sheltonr2/drone-boat/docs/Launch_Point_Study.md

# Launch-point study: where on the US Atlantic coast to launch, and the best launch and destination pair

12 November 2026. Plan, research and reasoning. Results will be added as the runs finish. Companion to [Destination_Study.md](Destination_Study.md).

## The question

The launch has been fixed 10 km off Ocean City, Maryland. Randolph asked on 12 Nov to test launch points up and down the US Atlantic coast, then combinations of launch point and destination, to find the best pair.

## What the research says

**1. The record of small robot boats points at the first few hundred kilometres.** The [Microtransat history](https://www.microtransat.org/history.php) lists every attempt.

- Eight boats left **Cape Cod** between 2014 and 2020. None got further than about 2,100 km. Three were caught by fishing boats within three to six days, and a fourth ran aground and was picked up by one.
- Three left **Gloucester, Massachusetts**. They looped, ran aground on Nantucket, or were withdrawn.
- Four left **Newfoundland**, which is already beyond the New England shelf and its fisheries. One finished (SB Met, 2018, 79 days), one reached the Irish coast after 6,041 km, one covered 4,682 km, and one sailed south and was lost.
- Scout, a 4 m solar boat, left Rhode Island in 2013 and was [lost after more than 1,300 miles](https://makezine.com/article/maker-news/scout-transatlantic-when-is-a-failure-not-a-failure).

The lesson is that boats die on the continental shelf, among the fishing fleets, before they reach deep water. Newfoundland is not a US launch point, but it shows what skipping the shelf is worth.

**2. Unsteered miniboats are launched into the Gulf Stream, not from the beach.** [Educational Passages](https://educationalpassages.org) has ships drop its 1.5 m boats in the stream. One boat shows why: Gryphon Cruiser was [launched off South Carolina less than 50 nautical miles short of the stream, and three days later it was ashore at Daytona Beach](https://educationalpassages.org/?p=15604). Relaunched from a ship, it strayed out of the stream and landed on Nantucket within six weeks. So a launch that stops short of the stream can end within days, and even the stream throws boats back at New England. Our boat steers, which should help with both.

**3. How far the Gulf Stream is from the beach varies enormously.**

- Off Jupiter and Palm Beach, Florida, it runs [1 to 3 miles from the inlet on many days](https://rigline-web-azure-mu.vercel.app/blog/best-offshore-fishing-spots-in-florida-data-driven-breakdown).
- Off Cape Hatteras it is [15 to 25 miles out](https://islandfreepress.org/?p=7099), the closest anywhere north of Florida, and charter boats fish it routinely.
- At Hatteras the stream leaves the coast. South of New England its north wall averages [240 km beyond the shelf break](https://scienceweb.whoi.edu/PO/linew/stream_coordinate_sections.php), which itself is 100 to 200 km offshore.

**4. On the Mid-Atlantic shelf the water moves slowly offshore and south-west.** Ten years of radar measurements ([Roarty et al. 2020](https://repository.library.noaa.gov/view/noaa/48639/noaa_48639_DS1.pdf)) give a mean surface flow of 2 to 12 cm/s, weakest in summer (3 to 6 cm/s). In the south of the region the flow turns offshore and joins the Gulf Stream near Hatteras. The day-to-day swings (10 to 20 cm/s) are much larger than the mean. So off Ocean City the shelf current neither helps nor hurts much: the boat has to sail about 250 km to reach the stream, in whatever the wind is doing.

**5. Early-season tropical storms form close to the southern launch points.** In June, storms tend to form in the Gulf of Mexico, the Caribbean or [off the south-east coast](https://michaelrlowry.substack.com/p/from-late-june-to-early-july-where), sometimes from [fronts stalled over the Gulf Stream](https://products.climate.ncsu.edu/weather/hurricanes/science). A boat launched from Florida or the Carolinas spends its first weeks there. Our weather data understates the winds in tropical storms, so the runs will flatter the southern launches on this point.

## What the destination runs already show about the launch

In the batch-1 Ireland run from Ocean City, 9% of boats were lost or aground within three weeks, 11% ended aground on the American side, and the median boat took 6.8 days to get 200 km from the launch point. So the near-coast phase costs roughly 10 points of success. That is the most a better launch point could win back from that phase alone; a faster crossing could add more.

## Launch points to test

All are about 10 km off the beach (what a small boat can reach in an hour) unless stated. Two extra "offshore" points test paying a charter boat to carry the drone to the shelf edge or the Gulf Stream.

| Launch | Position | Route to SW Ireland | Gulf Stream from the launch (my estimate) | Why it is in |
|---|---|---|---|---|
| Maine, off Mount Desert | 44.05°N 68.17°W | 4,800 km | 700 km | Shortest route. Has to cross the Gulf of Maine and pass Georges Bank and Nova Scotia |
| Cape Cod, off Chatham | 41.70°N 69.80°W | 4,980 km | 450 km | Where eight Microtransat boats started. A check of the model against that record |
| Montauk / Block Island | 41.00°N 71.78°W | 5,090 km | 350 km | Southern New England, clear of Cape Cod and Nantucket Shoals to the south |
| New Jersey, off Barnegat | 39.76°N 73.98°W | 5,250 km | 300 km | Between New York's and Delaware Bay's shipping lanes |
| **Ocean City, MD (current plan)** | 38.32°N 74.97°W | 5,380 km | 250 km | Baseline |
| Ocean City, 100 km off | 38.10°N 73.85°W | 5,290 km | 150 km | Charter run to the canyons at the shelf edge. What is skipping the shelf worth? |
| Virginia Beach | 36.83°N 75.85°W | 5,510 km | 150 km | South of the Chesapeake Bay mouth, where the shelf flow starts to turn offshore |
| Hatteras Inlet, NC | 35.10°N 75.72°W | 5,590 km | 30–45 km | Closest the stream comes north of Florida |
| Hatteras, 45 km off | 34.95°N 75.35°W | 5,560 km | 0 | Charter run into the stream's inshore edge |
| Charleston, SC | 32.68°N 79.77°W | 6,120 km | 100 km | Widest shelf in the south. The Gryphon Cruiser case |
| Cape Canaveral, FL | 28.41°N 80.48°W | 6,430 km | 60 km | Mid-Florida |
| Palm Beach, FL | 26.77°N 79.93°W | 6,600 km | under 10 km | In the stream from the first hour, but 1,200 km further |

Routes: the southern launches follow the stream's axis past Hatteras (30°N 79.8°W, 32°N 78.6°W, 35°N 74.5°W), the Hatteras launches clear Diamond Shoals first (35°N 74.9°W), Cape Cod and Montauk pass south of Georges Bank (40°N 67.5°W), and Maine leaves by the Northeast Channel (42.3°N 66°W). All then use the same mid-ocean waypoint as before (42°N 48°W).

**Autopilot change for this study.** Until now a waypoint counted only when the boat came within 25 km of it. In a 2 m/s current a boat can be swept past, and the old rule would turn it back against the stream. The launch scenarios use a new option (`"waypoint_rule": "abeam"`): a waypoint also counts once the boat has passed it. The earlier destination runs keep the old rule, so Ocean City is run again with the new rule as this study's baseline. Comparing it with the batch-1 Ireland run shows what the rule itself changes.

## Stages

| Stage | What | Runs | Time on the PC |
|---|---|---|---|
| A | All 12 launch points aimed at SW Ireland. Rev C5, 150 voyages each, 2023 weather, same launch dates and seeds as the destination study | 12 | about 8 hours |
| B | The best three launch points × the best three destinations from the destination study (pairs not already run) | up to 8 | about 5.5 hours |
| C | Confirmation of the best two pairs and the current plan: **Rev D**, 500 voyages (250 in each of 2023 and 2024), on the faster simulator | 3 | about 1 h 36 min |

- Stage A uses Rev C5 so that its numbers line up with the 13 destination runs. The boat we will build is Rev D, so the final answer (stage C) is run on Rev D.
- Stage B is a 3 × 3 grid because launch and destination might interact: a southern launch arrives in mid-ocean further south and later in the season, which could favour a different aim point.
- `simulator/run_launch_points_2023.bat` runs stage A. Scenario files: `collab/launch_points/`. A run that has already finished is skipped, so the batch can be restarted after a reboot.
- Analysis: `docs/data/launch_analysis.py`.

## What the simulator can and cannot tell us

It models, for every launch point: the real 2023 wind, waves and currents (currents at 1/12°, so the Gulf Stream and the Florida Current are resolved); land; and risks that rise near any coast (pick-up within 160 km of land, collision ×8 and fouling ×3 within 100 km).

It does not model:

- **Regional differences in fishing and traffic.** The pick-up risk is the same off Maine as off Florida. The Microtransat record says the New England and Nova Scotia shelves are far worse. The analysis therefore adds a sensitivity: each successful voyage is marked down for the days it spent on those grounds (Gulf of Maine and Georges Bank, the Scotian Shelf, the Grand Banks) at an extra 2% and 5% a day. Both rates are guesses. The Cape Cod record implies something near the higher one (3 or 4 boats caught in roughly 70 boat-days), but that is thin data from smaller boats.
- **Shoals and tidal races:** Diamond Shoals, Nantucket Shoals, Georges Bank, the Bay of Fundy tides. The land map has no shallows.
- **Lobster gear** in the Gulf of Maine, beyond the general near-coast fouling risk.
- **Tropical storms at full strength** (research note 5), which matters most for the southern launches.
- **Launch date.** Every launch point uses 1 May to 15 June. A Florida launch could go in April, before the storm season; a Maine launch might be better in June. Stage C can test this for the winners.
- **Cold.** Sea temperature off Maine in May is about 8 °C against 25 °C off Florida. That affects fouling growth, which is modelled, and fog, which is not.

Outside the simulator altogether: how far the boat has to be trailered, whether a charter boat is available (routine at Hatteras and Ocean City), and where a boat that washes back ashore can be recovered.

## What I expect, before the runs

- **Hatteras should do best**, and the 45 km charter launch better than the 10 km one. It is the only place where the stream is close and the route is not much longer. The risk is Diamond Shoals and the capes if the boat is set back ashore.
- **The offshore Ocean City launch** should recover most of the 10 points the near-coast phase costs, at the price of a charter.
- **Florida** gets a fast start but a 1,200 km longer route along a busy coast, within pick-up range for a week. I expect it to be close to Ocean City, and worse once storms are counted properly.
- **Charleston and Canaveral** have a wide shelf to cross before the stream. I expect them to be worst in the south.
- **New England** has the shortest route, but the model will flatter it because it does not know about the fishing fleets. Its fishing-adjusted figure is the one to read.

These are expectations, not results.

## Results

**Destinations for stage B** (from the finished destination study, 12 Nov): **SW Ireland, Cornwall and Brittany.** SW Ireland and Cornwall tied at 44.7%; West of Ireland (42.0%) and Brittany (41.3%) are tied within noise. Brittany is taken over West of Ireland because it is the furthest-south target still in the leading group, which is the better test of whether a southern launch favours a southern aim. Details: [Destination_Study.md](Destination_Study.md#results-12-nov-2026-final-for-this-screen).

### Stage A: 12 launch points to south-west Ireland (finished 13 Nov, 4:04 am)

Rev C5, 150 voyages per launch point, 2023 weather, launches 1 May–15 June, the same launch dates and seeds everywhere, so the paired column is the fair comparison. A single share is good to about ±8 points; paired differences to about ±10 here.

| # | Launch | Success (95% range) | vs Ocean City, paired | Median days | Lost | Aground | At sea | Lost or aground in 3 weeks | Aground on the home side | Days to get 200 km out | Days on the northern fishing grounds | Success if those grounds add 2% / 5% a day |
|---|---|---|---|---|---|---|---|---|---|---|---|---|
| 1 | Hatteras, 45 km off (charter, in the stream) | 54.0% (46–62) | +7.3 (-3.3 to +17.3) | 110 | 9.3% | 6.7% | 21.3% | 0.7% | 6.0% | 2.1 | 5.6 | 53.5% / 52.8% |
| 2 | Ocean City, 100 km off (charter, shelf edge) | 50.0% (42–58) | +3.3 (-6.7 to +12.7) | 115 | 10.7% | 7.3% | 23.3% | 0.0% | 6.7% | 4.7 | 6.5 | 49.0% / 47.8% |
| 3 | Hatteras Inlet, 10 km | 49.3% (41–57) | +2.7 (-7.3 to +12.7) | 107 | 11.3% | 6.0% | 22.7% | 4.7% | 6.0% | 2.6 | 4.2 | 48.5% / 47.5% |
| 4 | Virginia Beach, 10 km | 48.7% (41–57) | +2.0 (-8.7 to +12.7) | 116 | 16.7% | 5.3% | 24.0% | 7.3% | 5.3% | 6.3 | 3.6 | 48.0% / 47.1% |
| 5 | **Ocean City, 10 km (current plan)** | 46.7% (39–55) | — | 121 | 14.0% | 12.0% | 21.3% | 8.7% | 11.3% | 6.8 | 7.3 | 45.5% / 44.0% |
| 6 | Cape Cod, 10 km | 46.6% (39–55) | +0.0 (-9.3 to +10.0) | 118 | 18.0% | 7.3% | 23.3% | 1.3% | 7.3% | 5.5 | 13.0 | 40.9% / 34.1% |
| 7 | Montauk / Block Island, 10 km | 46.0% (38–54) | -0.7 (-12.0 to +10.0) | 126 | 18.0% | 12.0% | 20.7% | 6.7% | 11.3% | 7.3 | 10.2 | 42.0% / 37.3% |
| 8 | Maine, 10 km | 44.0% (36–52) | -2.7 (-12.0 to +6.7) | 115 | 22.7% | 11.3% | 18.0% | 10.7% | 11.3% | 4.5 | 23.7 | 30.3% / 18.4% |
| 9 | Charleston, 10 km | 43.3% (36–51) | -3.3 (-14.0 to +7.3) | 120 | 22.7% | 4.0% | 22.7% | 11.3% | 4.0% | 6.2 | 5.9 | 42.4% / 41.1% |
| 10 | Palm Beach, 10 km | 42.7% (35–51) | -4.0 (-13.3 to +5.3) | 127 | 18.0% | 9.3% | 26.0% | 9.3% | 9.3% | 2.5 | 6.9 | 41.7% / 40.4% |
| 11 | New Jersey (Barnegat), 10 km | 34.7% (28–43) | -12.0 (-21.3 to -2.7) | 131 | 20.7% | 20.0% | 22.0% | 10.7% | 17.3% | 6.5 | 10.3 | 32.4% / 29.7% |
| 12 | Cape Canaveral, 10 km (route flaw, see below) | 31.3% (24–39) | -15.3 (-25.3 to -5.3) | 126 | 21.3% | 15.3% | 24.7% | 18.7% | 14.0% | 4.5 | 7.0 | 29.5% / 27.2% |

"Success" = arrived still reporting or tracked by the YB3. "Aground on the home side" counts groundings west of 50°W, which includes Nova Scotia and Newfoundland as well as the launch coast. "Days on the northern fishing grounds" is time spent over the Gulf of Maine, Georges Bank, the Scotian Shelf and the Grand Banks; the last column marks successes down for it at two guessed extra pick-up rates (see "What the simulator can and cannot tell us").

**Checks before trusting the table.** No errors; every launch point has arrivals. Day-0 groundings are 0–1 everywhere except Hatteras Inlet (3, two of them on the beach at Hatteras village) and **Cape Canaveral (8 aground on the cape itself within a day, nothing broken)**. That one is my mistake: the launch point is south of the cape and the first leg to the north-north-east crosses it. A real launch would head east first. Canaveral's 31% is therefore about 5 points too low; a rerun with a first waypoint due east is queued at the end of stage B. Even corrected it stays in the bottom group, so it does not affect the stage B choice.

**What the waypoint rule changed.** Ocean City with the new "abeam" rule scored 46.7% against 44.7% for the same 150 launches with the old rule (destination study). 137 voyages came out identical; 3 that failed under the old rule arrived under the new one, and none went the other way. Paired: +2.0 (−0.2 to +4.2). So the rule helps a little and changes nothing else; launch points can be compared with it.

### What stage A shows

- **Going offshore beats moving along the coast.** The two charter launches top the table: 45 km off Hatteras, into the stream's inshore edge, 54.0% (+7.3 over Ocean City, range −3 to +17), and 100 km off Ocean City at the shelf edge, 50.0% (+3.3). Both nearly eliminate the near-coast losses: lost or aground in the first three weeks falls from 8.7% at Ocean City to 0.7% and 0%. And they cut fishing pick-ups (from 15 boats to 7 and 9).
- **Hatteras is the best beach launch**, as the research suggested: 49.3% from 10 km off, the shortest median crossing of all (107 days, against 121 from Ocean City), because the boat is 200 km out in under three days. Virginia Beach is about as good (48.7%).
- **None of these gains is certain on 150 voyages.** Every paired range for the top five crosses zero. The pattern (the closer the launch is to the stream, the better) is consistent, and it is what the research predicted, but the size of the gain needs stage C's larger runs.
- **New England gains nothing, and the fishing grounds make it worse.** Cape Cod (46.6%) and Montauk (46.0%) tie Ocean City in the model, but their boats spend 10–13 days on the New England and Scotian fishing grounds, against 4–7 from further south. With the guessed fishing mark-down they fall to 34–42%. Maine is worst affected: 24 days on the grounds, 22 boats picked up, and 18–30% after the mark-down. The Microtransat record from Cape Cod points the same way.
- **Florida doesn't pay.** Palm Beach is in the Florida Current from the first hour, but the route is 1,200 km longer and the boats take longer (127 days median). 42.7%, about the same as Charleston (43.3%).
- **New Jersey is clearly worse** (34.7%, −12, range −21 to −3): boats are carried north-east onto southern New England, Nova Scotia and Newfoundland, and 20% end aground (17% on the home side).

### Stage B: launch and destination pairs (finished 13 Nov, 12:52 pm)

Ran on the PC as `simulator/run_launch_pairs_2023.bat` (request 010), 7:06 am to 12:52 pm, no errors. Rev C5, 150 voyages per pair, 2023 weather, the same launch dates and seeds as stage A, so every cell is paired with Ocean City 10 km → SW Ireland (46.7%).

**Success, and paired difference against Ocean City 10 km → SW Ireland (95% range)**

| Launch | → SW Ireland | → Cornwall | → Brittany | Mean of the three |
|---|---|---|---|---|
| Hatteras 45 km (charter) | **54.0%** +7.3 (−3.3 to +17.3) | 46.7% +0.0 (−10.0 to +9.3) | 50.7% +4.0 (−6.0 to +13.3) | 50.4% |
| Ocean City 100 km (charter) | 50.0% +3.3 (−6.7 to +12.7) | **53.3%** +6.7 (−2.7 to +16.7) | 45.3% −1.3 (−11.3 to +8.7) | 49.6% |
| Hatteras Inlet 10 km | 49.3% +2.7 (−7.3 to +12.7) | 51.3% +4.7 (−6.0 to +15.3) | 50.7% +4.0 (−6.7 to +14.7) | 50.4% |
| Ocean City 10 km (current plan) | 46.7% (baseline) | 46.7% +0.0 (−7.3 to +7.3) | 44.7% −2.0 (−9.3 to +5.3) | 46.0% |

**Pooled** (`docs/data/launch_pairs_analysis.py`; each launch compared with Ocean City 10 km to the same destination, and each destination with SW Ireland from the same launch, resampling seeds):

| | Paired difference (95% range) |
|---|---|
| Hatteras 45 km vs Ocean City 10 km | +4.4 (−4.0 to +12.2) |
| Ocean City 100 km vs Ocean City 10 km | +3.6 (−3.8 to +11.3) |
| Hatteras Inlet 10 km vs Ocean City 10 km | +4.4 (−3.8 to +12.9) |
| Hatteras Inlet 10 km vs Hatteras 45 km | +0.0 (−7.8 to +8.0) |
| Cornwall vs SW Ireland | −0.5 (−4.2 to +3.7) |
| Brittany vs SW Ireland | −2.2 (−6.3 to +2.2) |

With the guessed fishing-ground mark-down (2% / 5% a day) every cell drops by 0.3 to 3 points and the order does not change. Storm encounters (`docs/data/launch_pairs_storms.json`, grade-D loss model) are 16.5–18.2% of voyages within 200 km of a tropical storm for every pair, costing 0.7–1.1 points: they do not separate the pairs.

**Canaveral rerun.** With the waypoint moved east of the cape, Canaveral → SW Ireland is 34.0% (−12.7 against Ocean City, range −22.0 to −2.7), against 31.3% for the flawed run. Grounding in the first three weeks fell from 18.7% to 14.0%, but it is still the worst launch tested, so the stage A conclusion stands: Florida doesn't pay.

### What stage B shows

- **The single cells are noise.** The best cell, Hatteras 45 km → SW Ireland (54.0%), and the next, Ocean City 100 km → Cornwall (53.3%), each come with a poor cell from the same launch (46.7%, 45.3%). The same launch dates and nearly the same first 3,000 km can't plausibly differ by 7 points on the aim point alone; that spread is what 150 voyages give.
- **Pooled, the three alternative launches are all about 4 points better than Ocean City 10 km, and tied with each other.** None of the ranges excludes zero, but all three point the same way, and they share the reason stage A found: they get the boat off the shelf and away from the coast faster (lost or aground in three weeks: 0–5% against 8.7%).
- **A beach launch at Hatteras Inlet is as good as the charter 45 km out** (+0.0, −7.8 to +8.0). Following the rule we set (prefer a beach launch over a charter launch when they're within noise), Hatteras Inlet is the launch to carry forward, though its early-grounding rate (4.7%) is higher than the charter's (0.7%).
- **SW Ireland and Cornwall are tied; Brittany is about 2 points worse.** Same as the destination study.

### Stage C: final check (13 Nov, 1:56–3:30 pm)

The best two pairs, both from Hatteras Inlet so that one comparison isolates the destination and the other the launch, and the current plan:

1. Hatteras Inlet 10 km → SW Ireland
2. Hatteras Inlet 10 km → Cornwall
3. Ocean City 10 km → SW Ireland (current plan)

On **Rev D as drawn**, **500 voyages each** (alternating 2023 and 2024 weather, so 250 in each year), the same seeds in all three runs. That is twice the 250 first planned: the faster simulator (installed 13 Nov after the bit-for-bit check) makes it cost about 1 h 36 min instead of 8 hours, and it narrows the paired ranges by about a third. `simulator/run_launch_final.bat` (request 011). Results: `results/2026-11-13_launch_2023+2024_<pair>.json`; log `collab/run_log_launch_final_2026-11-13.txt`; analysis `docs/data/launch_final_analysis.py` (output beside it).

Results: `results/2026-11-13_launch_2023_<launch>__<destination>.json`. Logs: `collab/run_log_launch_points_2023_2026-11-13.txt` (stage A), `collab/run_log_launch_pairs_2023_2026-11-13.txt` (stage B). Note: the first attempt at stage A, started at 6:02 pm on 12 Nov, was killed when the laptop was unplugged; the batch was restarted at 8:49 pm and ran cleanly.

**Results.** 500 voyages per pair, 250 in each weather year, the same seeds in all three. Ran in 1 h 34 min, no errors.

| Pair | Success (95% range) | 2023 | 2024 | Lost | Aground | Lost or aground in 3 weeks | Storm: TS within 200 km | After the storm-loss model | Fishing mark-down 2% / 5% |
|---|---|---|---|---|---|---|---|---|---|
| **Hatteras Inlet → Cornwall** | **68.4% (64–72)** | 72.0% | 64.8% | 6.8% | 3.4% | 2.8% | 13.2% | 67.2% | 67.9 / 67.2% |
| Hatteras Inlet → SW Ireland | 64.6% (60–69) | 65.6% | 63.6% | 8.2% | 2.4% | 2.8% | 13.8% | 63.5% | 64.0 / 63.3% |
| Ocean City 10 km → SW Ireland (current plan) | 59.2% (55–63) | 62.8% | 55.6% | 15.2% | 3.0% | 7.4% | 16.3% | 57.8% | 58.3 / 57.4% |

**Paired differences (95% range):**

| Comparison | Both years | 2023 | 2024 |
|---|---|---|---|
| **Hatteras Inlet → Cornwall vs current plan** | **+9.2 (+3.8 to +14.8)** | +9.2 (+1.2 to +17.2) | +9.2 (+1.6 to +16.8) |
| Launch only: Hatteras Inlet vs Ocean City, both to SW Ireland | +5.4 (−0.2 to +10.8) | +2.8 (−4.8 to +10.0) | +8.0 (+0.4 to +15.6) |
| Destination only: Cornwall vs SW Ireland, both from Hatteras Inlet | +3.8 (−0.2 to +7.8) | +6.4 (+0.4 to +12.4) | +1.2 (−4.4 to +7.2) |

## Recommendation (13 Nov 2026; adopted by Randolph the same day, with one correction)

**Update, 13 Nov evening:** Rev E from the 45 km point to Cornwall: **87.6%** (500 voyages, 2023 and 2024), +4.2 (+0.0 to +8.4) over the inlet, clear of the shoals; the 45 km point is the recommended drop ([Launch_Plan.md](Launch_Plan.md), [Naval_Review.md](Naval_Review.md)).

**Correction, 13 Nov, after adoption:** the 10 km drop off Hatteras Inlet sends about half the simulated tracks across Diamond Shoals, which the simulator's coastline doesn't hold ([Naval_Review.md](Naval_Review.md)). The provisional drop point is the 45 km charter point ("Hatteras 45 km" in stages A and B), which tied with the inlet on success and stays clear of the shoals. Runs to confirm it on Rev E are queued. The destination half of the recommendation (Cornwall) is unaffected. The text below is as written before the correction.

**Launch 10 km off Hatteras Inlet and aim for Cornwall** (Isles of Scilly / Land's End), instead of 10 km off Ocean City to SW Ireland.

- **How sure:** +9.2 points (+3.8 to +14.8) over the current plan on Rev D, the same in both weather years. That is the first launch result in this study whose range clears zero by a clear margin. Each half of it alone is borderline: the launch is worth about 5 points and the destination about 4.
- **Why it works:**
  - Off Hatteras the Gulf Stream is close. The boat is 200 km out in under 3 days (Ocean City: 7), so it spends less time near the coast, the fishing grounds and the shipping lanes. Losses fall from 15.2% to 6.8%, and the first-three-weeks losses from 7.4% to 2.8%.
  - It also sees slightly fewer tropical storms: within 200 km on 13% of voyages against 16%.
  - Cornwall is a slightly easier target than SW Ireland on the same tracks.
- **What it costs in practice:**
  - **Distance:** Hatteras is about 5 hours' drive south of Ocean City, plus a boat out of Hatteras Inlet. The inlet shoals and breaks in any swell, so go out on a calm morning with a local skipper, not a borrowed skiff.
  - **The charter alternative:** the 45 km charter from Hatteras did as well as the Inlet in stage B (tied), so if the Inlet is unworkable on the day, go with the Hatteras charter.
  - **Recovery:** Cornwall and the Scillies have good harbours and an active sea-rescue and fishing community for recovery. Recovery planning and contacts move from Ireland to south-west England.
- **What would change it:**
  - A test-season result from the real boat showing it can't hold its course in the Stream's eddies.
  - Real data on fishing-boat pick-ups, which the model only guesses. The Hatteras route crosses fewer grounds, so better data is more likely to strengthen this than reverse it.
  - Cornwall's approaches have heavy shipping; if a ship-strike model is added, rerun the destination half.
- **Changed 13 Nov:** [Launch_Plan.md](Launch_Plan.md) rewritten for Hatteras → Cornwall; Executive Summary, Build Plan and README updated. The boat-sim files for John's team (`designs/boat-sim/`) still carry the Ocean City drop so the boats there are compared alike.

## Sources

- [Microtransat Challenge history](https://www.microtransat.org/history.php)
- [Educational Passages: Gryphon Cruiser](https://educationalpassages.org/?p=15604)
- [Roarty et al. 2020, surface circulation over the Mid-Atlantic Bight shelf from HF radar](https://repository.library.noaa.gov/view/noaa/48639/noaa_48639_DS1.pdf)
- [WHOI Line W: mean position of the Gulf Stream north wall](https://scienceweb.whoi.edu/PO/linew/stream_coordinate_sections.php)
- [Island Free Press: charter fishing off Hatteras](https://islandfreepress.org/?p=7099)
- [Rigline: Gulf Stream off Jupiter and Palm Beach](https://rigline-web-azure-mu.vercel.app/blog/best-offshore-fishing-spots-in-florida-data-driven-breakdown)
- [Michael Lowry: where early-season tropical storms form](https://michaelrlowry.substack.com/p/from-late-june-to-early-july-where)
- [NC State Climate Office: tropical storm science](https://products.climate.ncsu.edu/weather/hurricanes/science)
- [Make: Scout transatlantic](https://makezine.com/article/maker-news/scout-transatlantic-when-is-a-failure-not-a-failure)
