sheltonr2/drone-boat/docs/Destination_Study.md

# Destination study: is there a better target than Ireland?

12 November 2026. Plan and reasoning; results to follow when the runs finish. Run files `simulator/run_destinations_2023.bat` and `run_destinations2_2023.bat`, scenarios in `collab/destinations/`.

## How the question is set up

- **The simulator already counts any landfall in Europe as a crossing.** Ireland is where the autopilot aims, not the only place that counts. So the question is which aim point gets the most boats across.
- **What counts as "across" in this study:** mainland Europe and the British Isles, Madeira, the Canary Islands, and north-west Africa's Atlantic coast (Morocco, Western Sahara). **The Azores do not count:** they sit about two-thirds of the way across, roughly 4,000 km from the launch point against 5,200–5,700 km for the others.
- **Same everything else:** Rev C5, corrected simulator, 10 km launch off Ocean City, launches 1 May–15 June 2023, real 2023 weather, 150 voyages per destination. A 150-voyage result is good to about ±8 points, so this is a first screen; the best two or three get a 2023 + 2024 confirmation run.
- **An artefact to keep in mind:** a boat that leaves the weather data's area (north of 60°N or east of 0°) gets no wind there. That penalises boats that overshoot the Hebrides to the north.
- **Weather data limits:** the downloaded weather covers 26–60°N and 82°W–0°. That rules out Norway, Iceland and West Africa south of the Canaries without new downloads. A boat pushed south of 26°N near the Canaries sails on neutral weather there.

## Candidates

### How they were chosen

The first six were a quick north-to-south sweep of well-known headlands on the European side that fit inside the weather data, each with an obvious route. They were a sensible first screen but not an optimised list, and they left three gaps: nothing north of Mizen Head, nothing between Brittany and Galicia, and nothing between Lisbon and the Canaries. They also tested only one route to each place. A second batch of seven fills those gaps.

The choice is driven by two things more than by the name on the map:
- **The latitude at which the boat approaches the far side.** That sets how much it uses the westerlies and the North Atlantic Current, how rough the seas are, and how long it takes.
- **How good a net the coast behind the aim point is.** Any far-side landfall counts, and many boats arrive damaged. A coast that wraps round the aim point, with the wind blowing onto it, catches boats that can no longer steer well. An isolated island or a coast the current runs along, not onto, does not.

### Batch 1 (`run_destinations_2023.bat`)

| Destination | Aim point | Route distance | Route |
|---|---|---|---|
| South-west Ireland (current plan) | Mizen Head, 51.35°N 9.7°W | 5,380 km | via 42°N 48°W, south of the Grand Banks |
| Cornwall and the Isles of Scilly | 49.95°N 6.3°W | 5,610 km | same waypoint |
| Brittany | Pointe du Raz, 48.04°N 4.85°W | 5,730 km | same waypoint |
| Galicia, Spain | Cape Finisterre, 42.9°N 9.35°W | 5,530 km | via 40°N 48°W |
| Portugal | Cabo da Roca, 38.75°N 9.6°W | 5,560 km | direct (the direct course arcs north to about 43°N in mid-ocean) |
| Canary Islands | Lanzarote, 29.0°N 13.4°W | 5,690 km | direct |

### Batch 2 (`run_destinations2_2023.bat`)

| Destination | Aim point | Why it was added |
|---|---|---|
| Bay of Biscay | Vendée coast, 46.45°N 1.85°W | The middle of the widest net: Brittany to the north, Spain to the south, wind onshore. The best test of the "net" idea |
| West of Ireland | Connemara, 53.4°N 10.25°W | Further into the current's path; a boat that drifts north still has Donegal and Scotland beyond it |
| Outer Hebrides, Scotland | South Uist, 57.2°N 7.5°W | The northern end of what the weather data allows; most current, roughest seas |
| Gulf of Cádiz | 36.55°N 6.4°W | A funnel between the Algarve and Morocco, both of which count |
| Morocco | Casablanca, 33.6°N 7.7°W | A long, straight coast to aim at south of the stormy latitudes |
| Canary Islands by the northern arc | via 42°N 48°W and 40°N 20°W | The traditional sailing route: stay in the westerlies, then turn south with the northerly winds off Portugal. Tests route against destination |
| Azores | Faial, 38.55°N 28.75°W | Only about 4,000 km, but two-thirds of the way across. Reported separately: it counts only if the Azores are accepted as "across" |

### Not tested, and why

- **Iceland, the Faroes and Norway:** outside the downloaded weather (which stops at 60°N and at 0° longitude). Iceland's south coast is about 4,600 km from the launch point, shorter than Ireland, but colder and rougher, with ice near the route. Worth a weather download only if the northern targets do well here.
- **West Africa south of the Canaries, Cape Verde:** outside the weather data (south of 26°N), and reaching them means crossing the light-wind belt.
- **The Caribbean and South America:** not across from North America in the sense asked. (The trade-wind route runs the other way, Europe to the Caribbean.)
- **Madeira:** a single small island, bracketed by the Portugal and Canaries runs.
- **Different routes to the northern targets:** the waypoint at 42°N 48°W is held fixed. Tuning it is the next step for whichever targets win.
- **A different launch point:** was out of scope here. Added on 12 Nov as its own study, which also tests launch and destination pairs: [Launch_Point_Study.md](Launch_Point_Study.md).

## What the physics suggests before the runs

These are expectations from general North Atlantic oceanography, not results. The runs will confirm or overturn them.

- **The ocean's conveyor favours the north.** The Gulf Stream feeds the North Atlantic Current, which runs north-east toward Ireland and Britain. A boat sailing for the British Isles has current and the prevailing westerlies behind it for most of the way, and a dead boat drifts the same way. That is why drift bottles and small unpowered boats from North America so often land in Ireland, Britain and France.
- **The southern routes cross the Azores High.** In summer a large area of high pressure sits around 30–40°N in the mid-Atlantic, with light, shifting winds. Routes to Portugal and the Canaries go through or around it, so they are likely to be slower, and time at sea is what drives failures.
- **The north is rougher.** Gales and breaking seas are more frequent the further north and the later in the season. That costs knockdowns, wing and keel damage. It is the main argument for a more southerly target.
- **Coast width matters.** Aiming at Cornwall or Brittany puts the boat in the mouth of a funnel: if it drifts north it hits Ireland or Wales, if south it hits France or Spain. Aiming at south-west Ireland, a boat that overshoots north passes Ireland and continues into the open sea towards Scotland and Norway.
- **Traffic and fishing near the coast.** The approaches to the English Channel (off Ushant) and Cape Finisterre are among the busiest shipping lanes in the world, and the Iberian and Moroccan coasts are heavily fished. The simulator's collision and pick-up risks do not vary by region, so it will understate this for Brittany, Galicia and Portugal.
- **Hurricanes.** The Canaries route stays in the subtropics into August to October. The simulator's weather resolves hurricanes poorly, so it will understate that risk.
- **The Azores** would be the easiest target by distance alone, but they are not across the Atlantic and are excluded.

## When results are in

For each destination: share of voyages reaching any far-side coast with a verified position, where they landed, median crossing time, and the main causes of loss. Then a recommendation, with the confirmation run for the best candidates.

## Results (12 Nov 2026, final for this screen)

Rev C5 on the corrected simulator, 150 voyages per aim point, 2023 weather, launched 10 km off Ocean City, 1 May–15 June. Every aim point used the same launch dates and seeds, so the paired column is the fairer comparison. A single share is good to about ±8 points; paired differences are tighter.

| Rank | Aim point | Success (95% range) | vs SW Ireland, paired | Any landfall | Median days | Lost | Aground | At sea | Where successes landed |
|---|---|---|---|---|---|---|---|---|---|
| 1 | SW Ireland (Mizen Head) | 44.7% (37–53) | — | 51.3% | 121 | 14.7% | 12.0% | 22.0% | Ireland 58, France 4, Great Britain 4, Portugal 1 |
| 2 | Cornwall | 44.7% (37–53) | +0.0 (-7.3 to +8.0) | 50.7% | 127 | 16.0% | 12.7% | 20.7% | Great Britain 57, France 9, Portugal 1 |
| 3 | West of Ireland | 42.0% (34–50) | -2.7 (-10.0 to +4.7) | 48.0% | 118 | 15.3% | 12.0% | 24.7% | Ireland 60, Great Britain 3 |
| 4 | Brittany | 41.3% (34–49) | -3.3 (-10.7 to +4.0) | 48.6% | 132 | 13.3% | 12.7% | 25.3% | France 58, Ireland 3, Great Britain 1 |
| 5 | Bay of Biscay | 38.7% (31–47) | -6.0 (-14.0 to +1.3) | 46.1% | 143 | 14.0% | 11.3% | 28.7% | France 52, Spain 2, Portugal 2, Ireland 1, Great Britain 1 |
| 6 | Galicia | 38.0% (31–46) | -6.7 (-15.3 to +2.0) | 43.4% | 140 | 20.7% | 5.3% | 30.7% | Spain 51, Portugal 5, France 1 |
| 7 | Outer Hebrides | 38.0% (31–46) | -6.7 (-15.3 to +1.3) | 46.0% | 124 | 15.3% | 12.0% | 26.7% | Great Britain 53, Ireland 3, France 1 |
| 8 | Gulf of Cádiz | 36.7% (29–45) | -8.0 (-18.0 to +2.7) | 40.7% | 150 | 18.0% | 12.0% | 29.3% | Spain 27, Portugal 26, Africa 2 |
| 9 | Portugal (Lisbon) | 33.4% (26–41) | -11.3 (-21.3 to -1.3) | 36.1% | 148 | 16.7% | 12.7% | 34.7% | Portugal 50 |
| 10 | Canaries, northern arc | 22.0% (16–29) | -22.7 (-31.3 to -14.7) | 27.3% | 158 | 19.3% | 14.7% | 38.7% | Canaries 31, Madeira 1, Portugal 1 |
| 11 | Morocco | 18.0% (13–25) | -26.7 (-36.0 to -17.3) | 19.3% | 163 | 24.7% | 11.3% | 44.7% | Africa 25, Spain 1, Madeira 1 |
| 12 | Canaries | 10.7% (7–17) | -34.0 (-42.7 to -25.3) | 13.4% | 170 | 19.3% | 6.0% | 61.3% | Canaries 15, Madeira 1 |

Success = arrived still reporting or tracked by the YB3. "Any landfall" also counts silent and adrift arrivals. Boats that reach the 40 km arrival circle but are still offshore count for the aim point's country. Lost, aground and at sea are shares of all 150.

**The Azores, reported separately** (they count only if Randolph accepts them as "across"):

| Rank | Aim point | Success (95% range) | vs SW Ireland, paired | Any landfall | Median days | Lost | Aground | At sea | Where successes landed |
|---|---|---|---|---|---|---|---|---|---|
| — | Azores (not "across") | 52.7% (45–60) | +8.0 (-1.3 to +17.3) | 54.7% | 90 | 16.0% | 2.0% | 27.3% | Azores 79 |

### What it shows

- **No target beats south-west Ireland.** Cornwall ties it exactly (44.7% each). West of Ireland (−2.7) and Brittany (−3.3) are within noise. Ireland stays the target; Cornwall is an equal alternative.
- **Further north does not help.** The Outer Hebrides are about as far as SW Ireland but score −6.7. This run doesn't show why.
- **Further south is clearly worse.** Biscay −6, Galicia −7, Cádiz −8, Portugal −11 (range −21 to −1), the Canaries by either route −23 to −34, Morocco −27. Every southern route crosses the light winds of the Azores High: medians of 140–170 days against 121, and 29–61% still at sea at the season's end. The northern arc to the Canaries (22%) beats the direct route (11%), but only by avoiding the High for longer.
- **The Azores score best (52.7%, +8, range −1 to +17) because they are close**: 90 days median. If they counted, they would be the easiest target, but they are about two-thirds of the way across.
- **The causes of loss are the same on every route** (rudder servos, fouling, electronics, leaks). The destination changes how long the boat is exposed to them, not what they are.
- Caveats as before: collision and pick-up risks don't vary by region, so busy approaches (the Channel, Ushant, Finisterre) are flattered; one weather year; Rev C5, not Rev D.

### Going forward

The launch-point study ([Launch_Point_Study.md](Launch_Point_Study.md)) carries three destinations into its stage B: **SW Ireland, Cornwall and Brittany**. West of Ireland scored a fraction higher than Brittany, but the two are tied within noise and the west-of-Ireland aim point is only 230 km from the SW Ireland one. Brittany is the furthest-south target still in the leading group, so it is the better test of whether a southern launch favours a southern aim. No separate destination confirmation run: the best pairs are confirmed on Rev D, on 2023 and 2024 weather, in stage C of the launch study.

Script: `docs/data/dest_analysis.py`. Results: `results/2026-11-12_dest_2023_<name>.json`. Logs: `collab/run_log_destinations_2023_2026-11-12.txt`, `collab/run_log_destinations2_2023_2026-11-12.txt`.
