sheltonr2/drone-boat/build-files/dxf/T21_weed_fairing.dxf

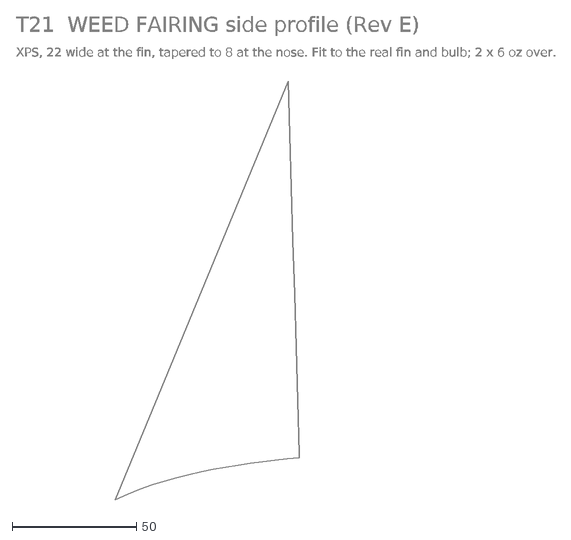
[picture p1: CAD file, 2026-11-13]
build-files/dxf/T21_weed_fairing.dxf
T21 WEED FAIRING side profile (Rev E)
XPS, 22 wide at the fin, tapered to 8 at the nose. Fit to the real fin and bulb; 2 x 6 oz over.
