sheltonr2/drone-boat/build-files/stl/P08_spar_clamp_two_sockets.stl

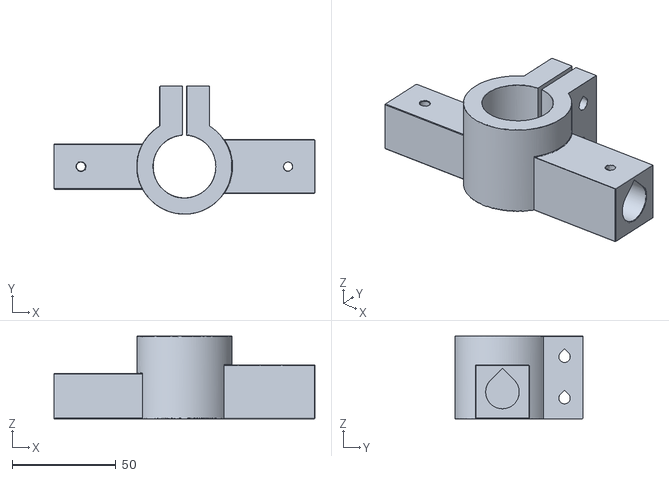
[picture p2: CAD file, 2026-11-14]
build-files/stl/P08_spar_clamp_two_sockets.stl
126.0 x 62.0 x 40.0
