sheltonr2/drone-boat/designs/revC_boat_wing_feathered.stl

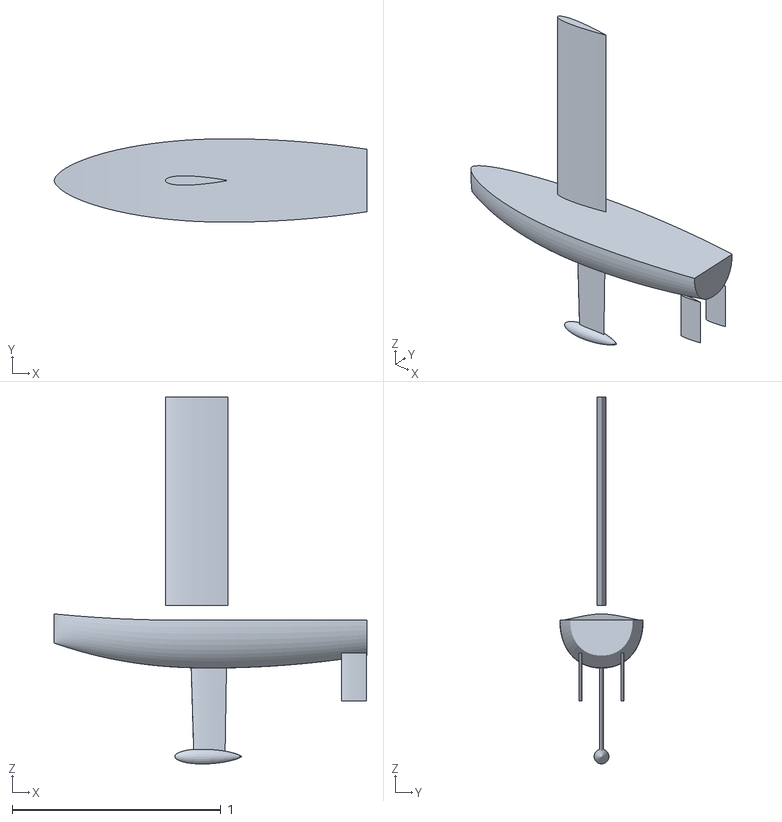
[picture p3: CAD file, 2026-11-10]
designs/revC_boat_wing_feathered.stl
1.50 x 0.4 x 1.76
