sheltonr2/drone-boat/build-files/dxf/T16_hatch.dxf

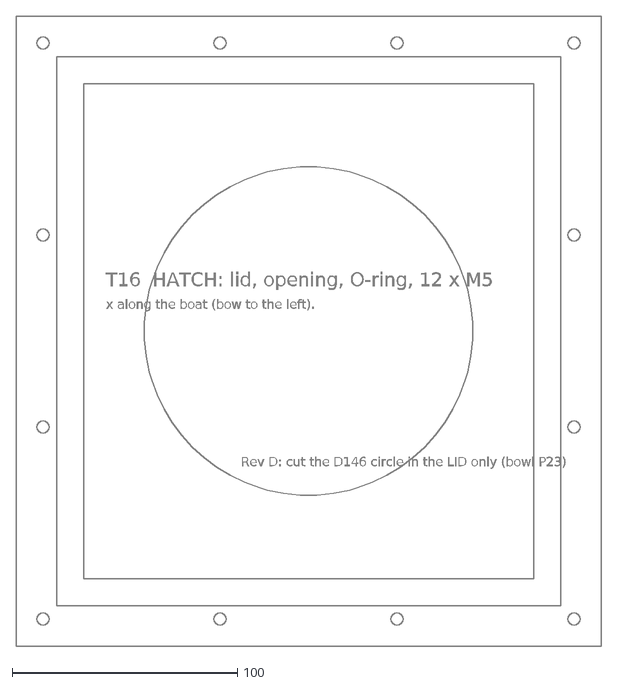
[picture p4: CAD file, 2026-11-12]
build-files/dxf/T16_hatch.dxf
T16 HATCH: lid, opening, O-ring, 12 x M5
Rev D: cut the D146 circle in the LID only (bowl P23)
x along the boat (bow to the left).
