sheltonr2/drone-boat/build-files/stl/P09_tail_servo_housing.stl

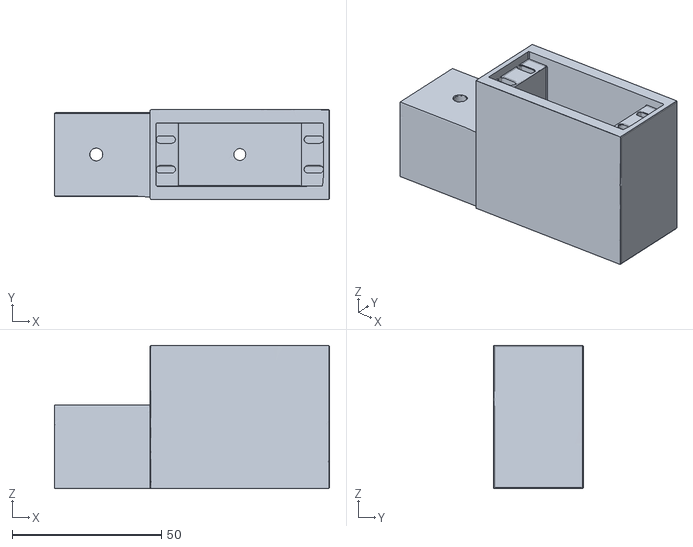
[picture p5: CAD file, 2026-11-14]
build-files/stl/P09_tail_servo_housing.stl
92.0 x 30.0 x 48.0
