sheltonr2/drone-boat/build-files/dxf/T15_wing.dxf

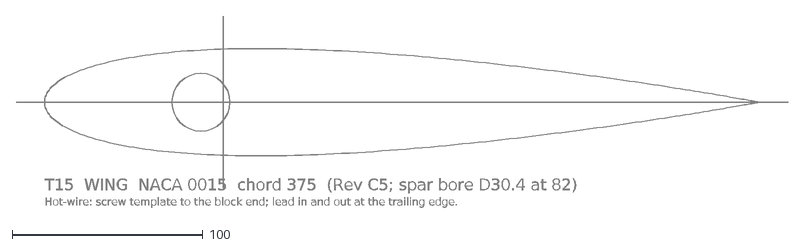
[picture p6: CAD file, 2026-11-11]
build-files/dxf/T15_wing.dxf
T15 WING NACA 0015 chord 375 (Rev C5; spar bore D30.4 at 82)
Hot-wire: screw template to the block end; lead in and out at the trailing edge.
