sheltonr2/drone-boat/build-files/stl/P26_rudder_servo_arm.stl

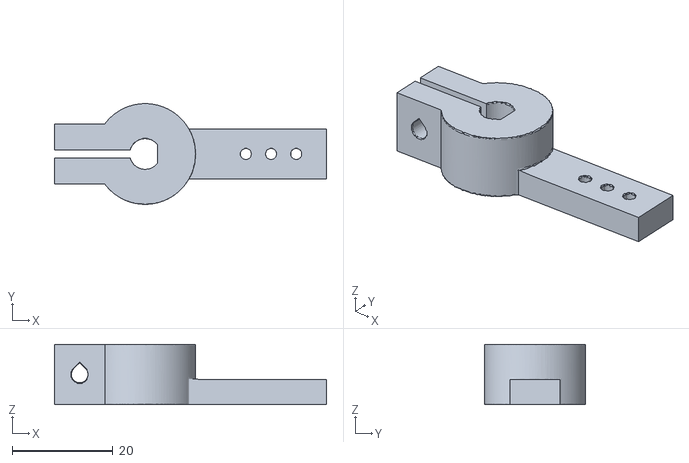
[picture p7: CAD file, 2026-11-13]
build-files/stl/P26_rudder_servo_arm.stl
54.0 x 20.0 x 12.0
