sheltonr2/drone-boat/build-files/dxf/T04_frame_station_4.dxf

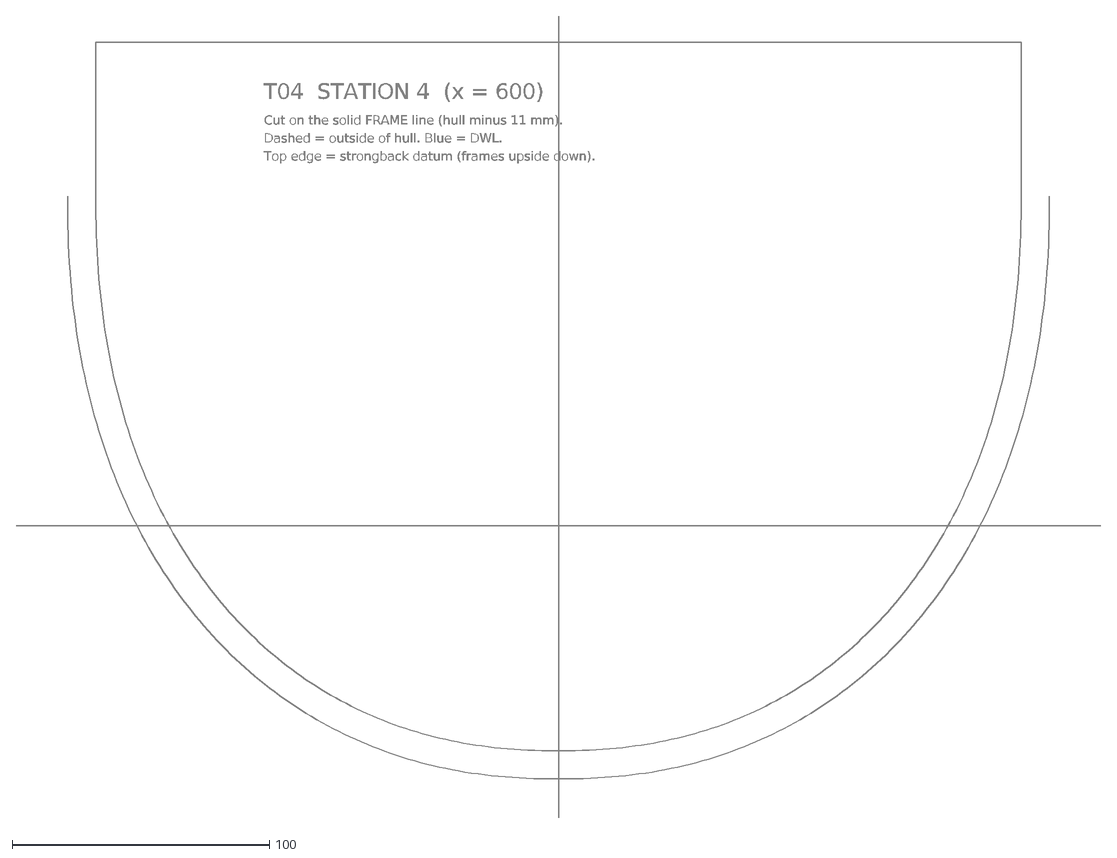
[picture p8: CAD file, 2026-11-11]
build-files/dxf/T04_frame_station_4.dxf
T04 STATION 4 (x = 600)
Cut on the solid FRAME line (hull minus 11 mm).
Dashed = outside of hull. Blue = DWL.
Top edge = strongback datum (frames upside down).
