sheltonr2/drone-boat/build-files/stl/P24_bilge_pump_spacer.stl

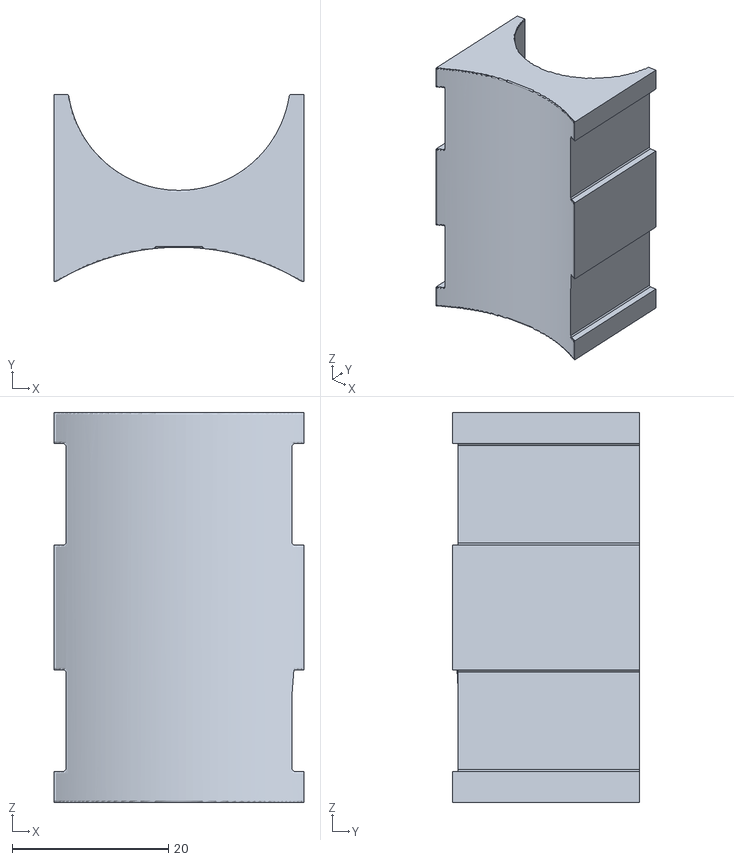
[picture p9: CAD file, 2026-11-13]
build-files/stl/P24_bilge_pump_spacer.stl
32.0 x 24.0 x 50.0
