sheltonr2/drone-boat/build-files/dxf/T09_frame_station_9.dxf

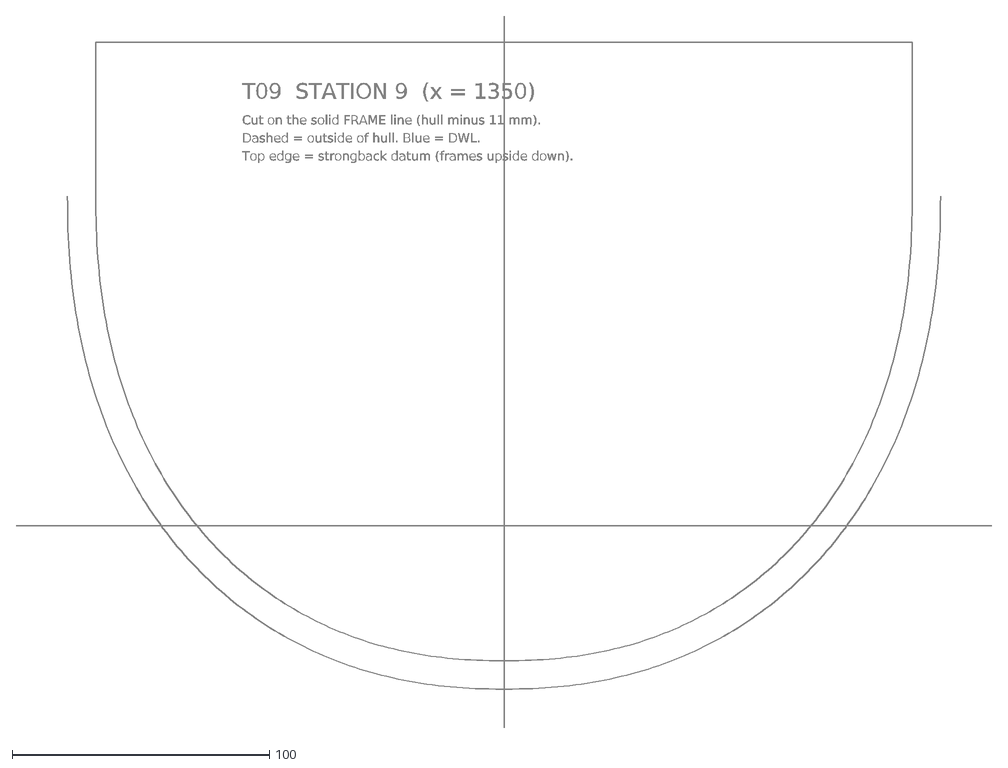
[picture p10: CAD file, 2026-11-11]
build-files/dxf/T09_frame_station_9.dxf
T09 STATION 9 (x = 1350)
Cut on the solid FRAME line (hull minus 11 mm).
Dashed = outside of hull. Blue = DWL.
Top edge = strongback datum (frames upside down).
