sheltonr2/drone-boat/build-files/stl/P12_rudder_servo_cradle.stl

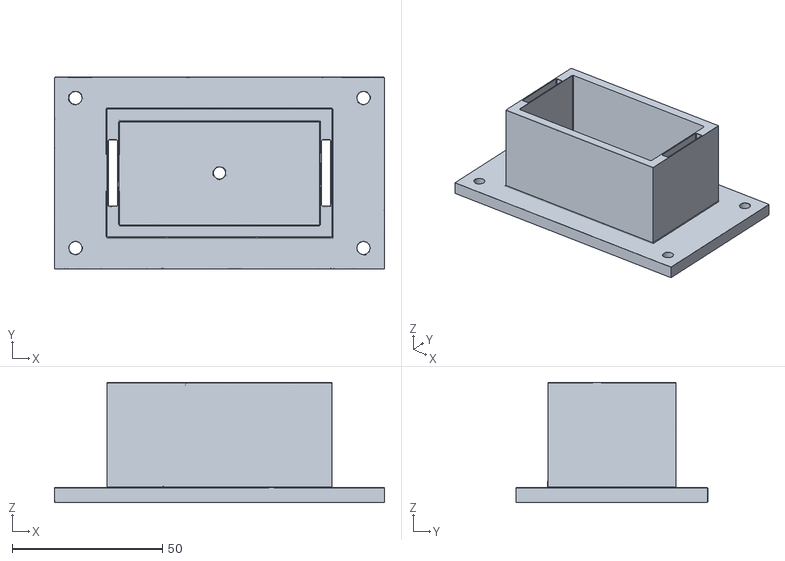
[picture p11: CAD file, 2026-11-13]
build-files/stl/P12_rudder_servo_cradle.stl
110.0 x 64.0 x 40.0
