sheltonr2/drone-boat/build-files/dxf/T02_frame_station_2.dxf

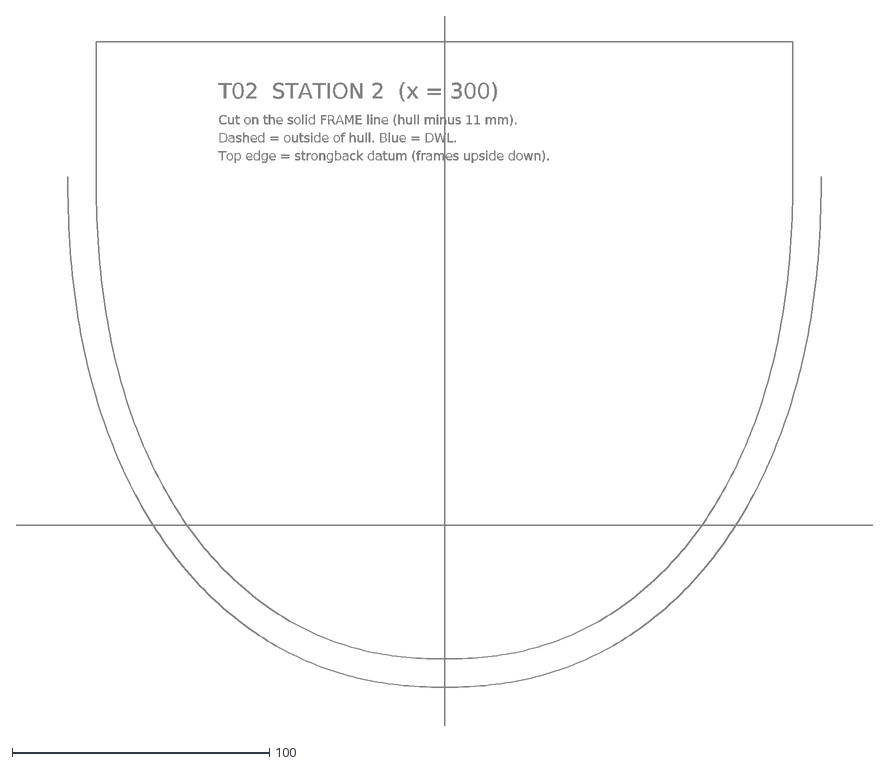
[picture p12: CAD file, 2026-11-11]
build-files/dxf/T02_frame_station_2.dxf
T02 STATION 2 (x = 300)
Cut on the solid FRAME line (hull minus 11 mm).
Dashed = outside of hull. Blue = DWL.
Top edge = strongback datum (frames upside down).
