sheltonr2/drone-boat/build-files/stl/P25_tail_detent.stl

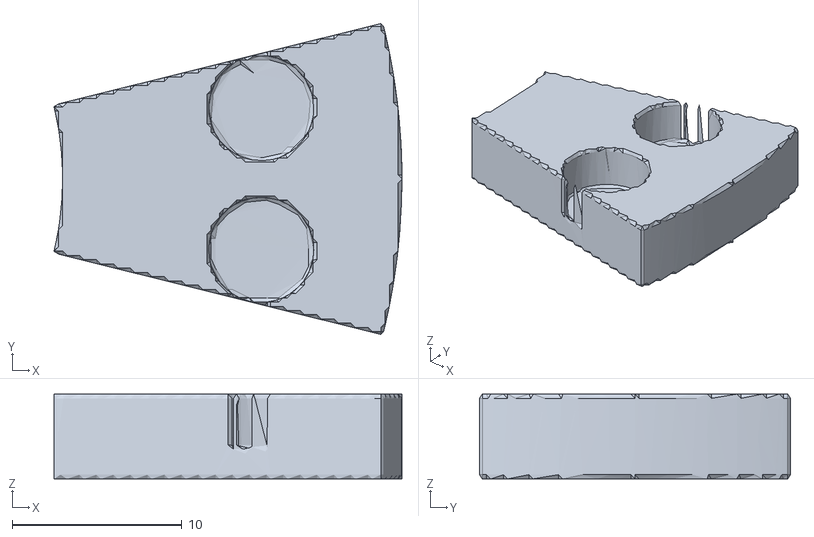
[picture p13: CAD file, 2026-11-13]
build-files/stl/P25_tail_detent.stl
20.5 x 18.3 x 5.00
