sheltonr2/drone-boat/build-files/dxf/T06_frame_station_6.dxf

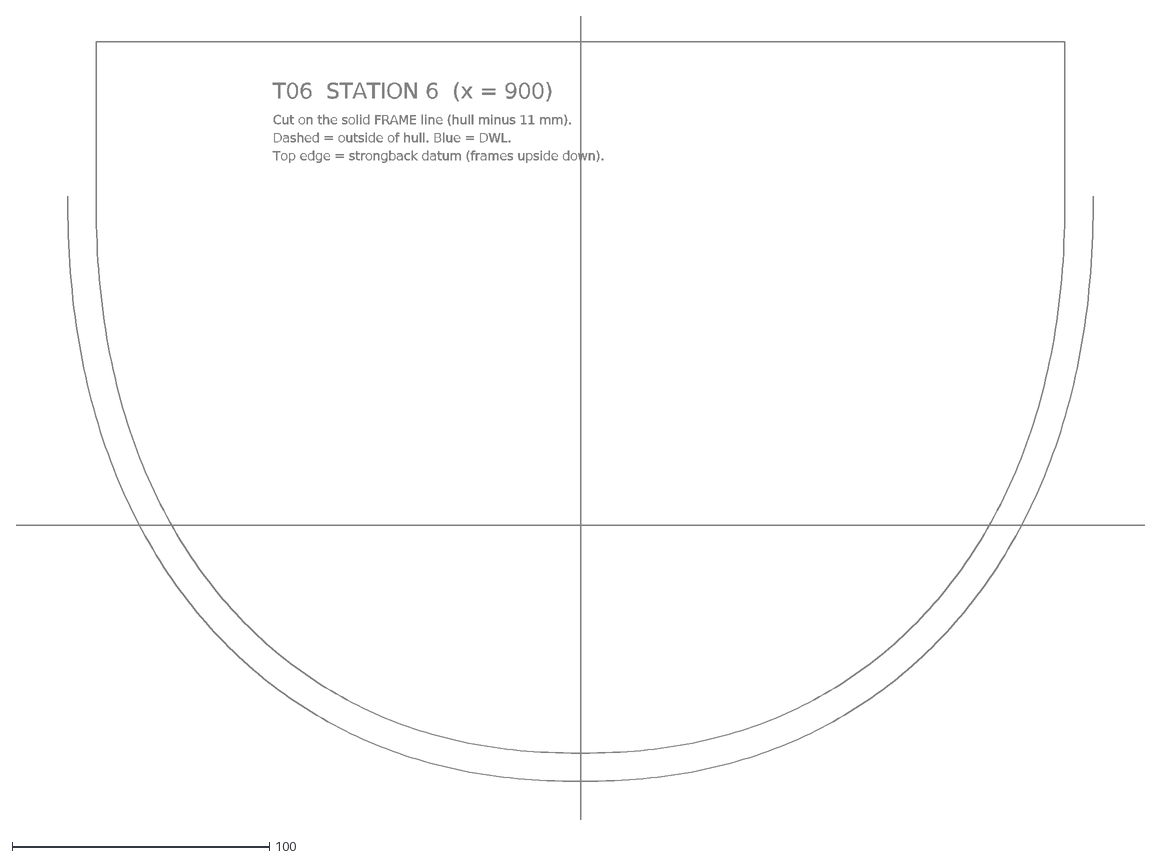
[picture p14: CAD file, 2026-11-11]
build-files/dxf/T06_frame_station_6.dxf
T06 STATION 6 (x = 900)
Cut on the solid FRAME line (hull minus 11 mm).
Dashed = outside of hull. Blue = DWL.
Top edge = strongback datum (frames upside down).
