sheltonr2/drone-boat/build-files/stl/P22_switchover_pod.stl

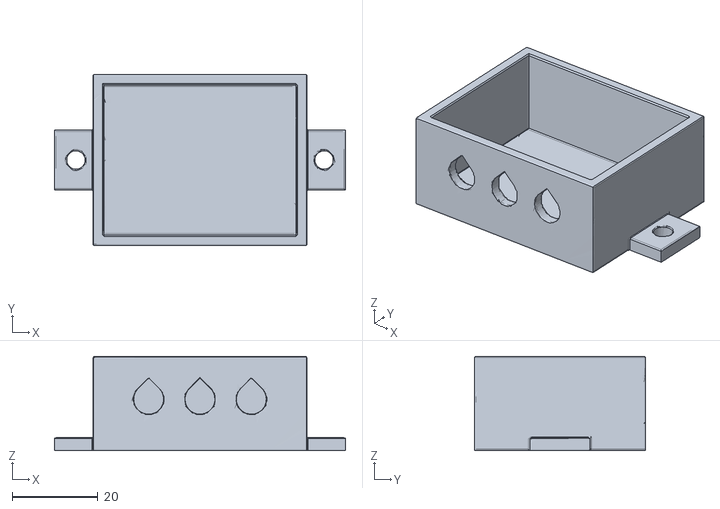
[picture p15: CAD file, 2026-11-12]
build-files/stl/P22_switchover_pod.stl
68.0 x 40.0 x 22.0
