sheltonr2/drone-boat/build-files/dxf/T07_frame_station_7.dxf

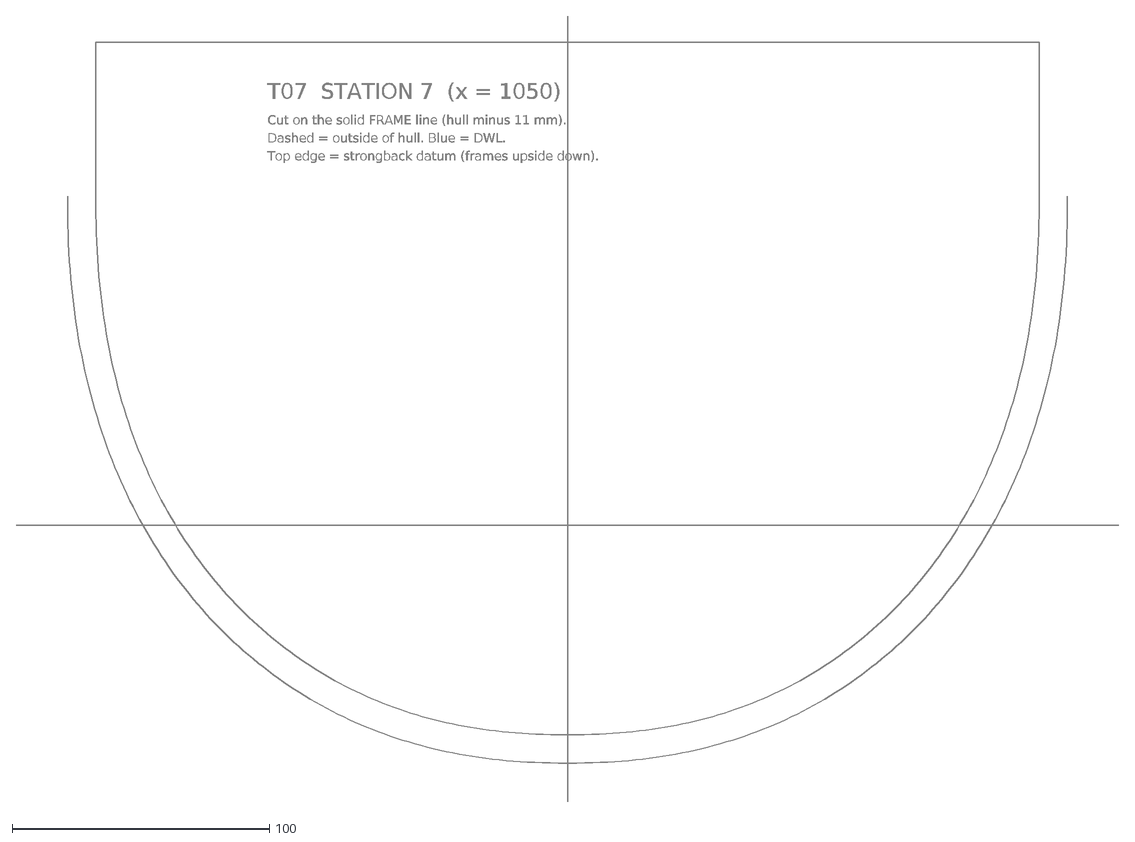
[picture p16: CAD file, 2026-11-11]
build-files/dxf/T07_frame_station_7.dxf
T07 STATION 7 (x = 1050)
Cut on the solid FRAME line (hull minus 11 mm).
Dashed = outside of hull. Blue = DWL.
Top edge = strongback datum (frames upside down).
