sheltonr2/drone-boat/build-files/stl/P21_limp_home_case.stl

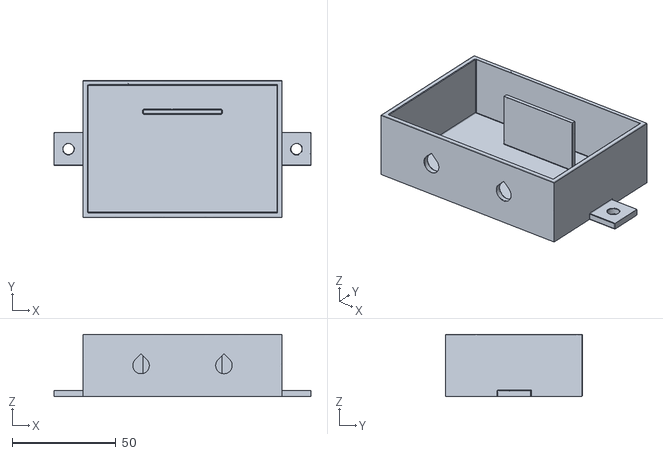
[picture p17: CAD file, 2026-11-12]
build-files/stl/P21_limp_home_case.stl
124.0 x 66.0 x 30.0
