sheltonr2/drone-boat/build-files/dxf/T18_bulkhead_x1260.dxf

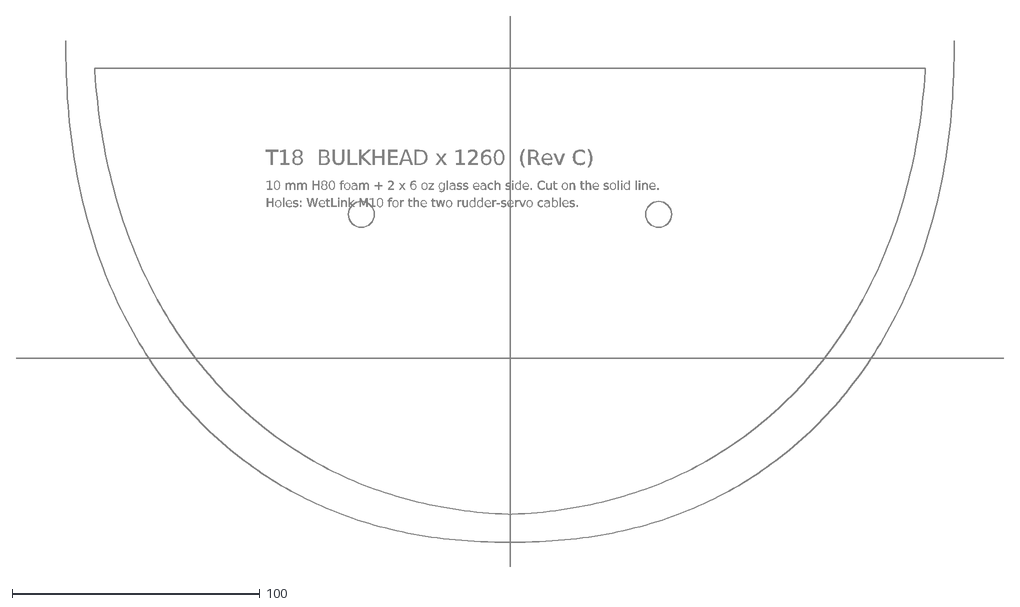
[picture p18: CAD file, 2026-11-11]
build-files/dxf/T18_bulkhead_x1260.dxf
T18 BULKHEAD x 1260 (Rev C)
10 mm H80 foam + 2 x 6 oz glass each side. Cut on the solid line.
Holes: WetLink M10 for the two rudder-servo cables.
