sheltonr2/drone-boat/build-files/stl/P23_rockblock_plus_bowl.stl

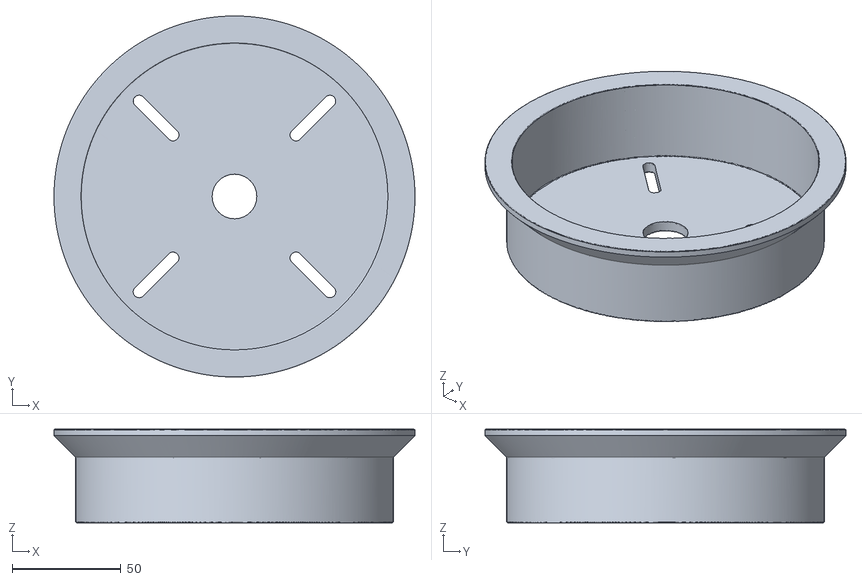
[picture p19: CAD file, 2026-11-12]
build-files/stl/P23_rockblock_plus_bowl.stl
166.0 x 166.0 x 43.0
