sheltonr2/drone-boat/build-files/dxf/T01_frame_station_1.dxf

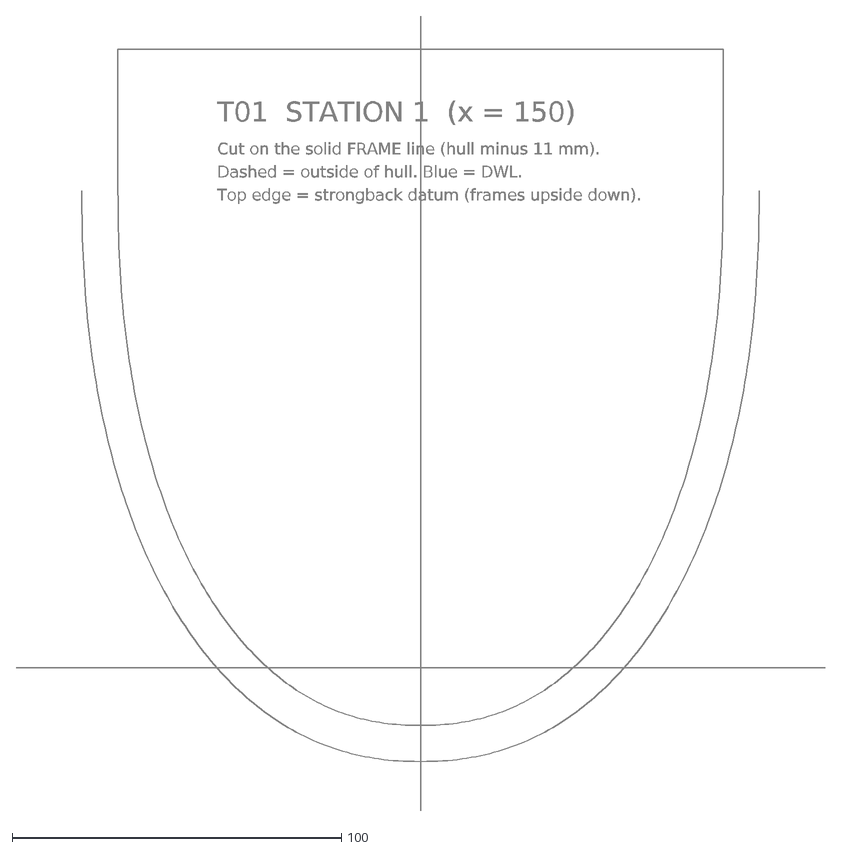
[picture p20: CAD file, 2026-11-11]
build-files/dxf/T01_frame_station_1.dxf
T01 STATION 1 (x = 150)
Cut on the solid FRAME line (hull minus 11 mm).
Dashed = outside of hull. Blue = DWL.
Top edge = strongback datum (frames upside down).
