sheltonr2/drone-boat/build-files/stl/P07_mast_bearing_housing.stl

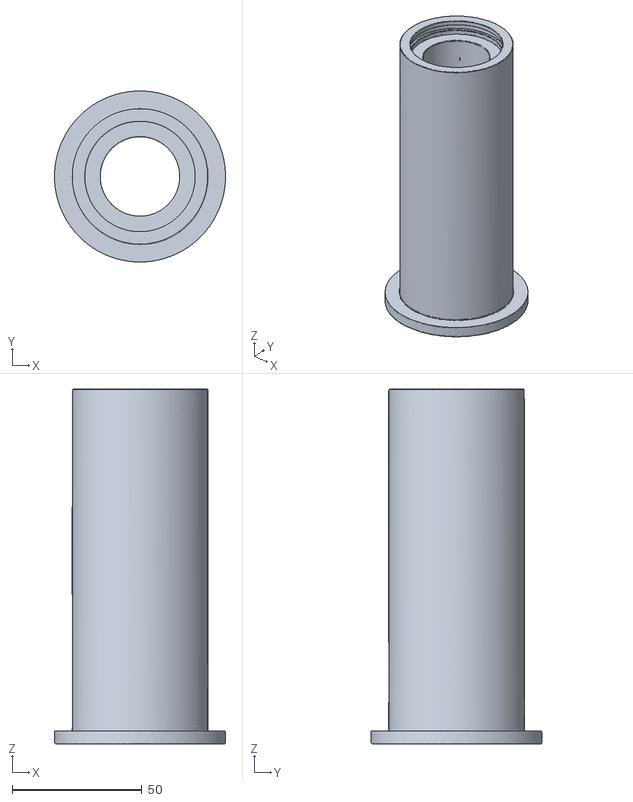
[picture p21: CAD file, 2026-11-11]
build-files/stl/P07_mast_bearing_housing.stl
66.0 x 66.0 x 137.0
