sheltonr2/drone-boat/build-files/dxf/T08_frame_station_8.dxf

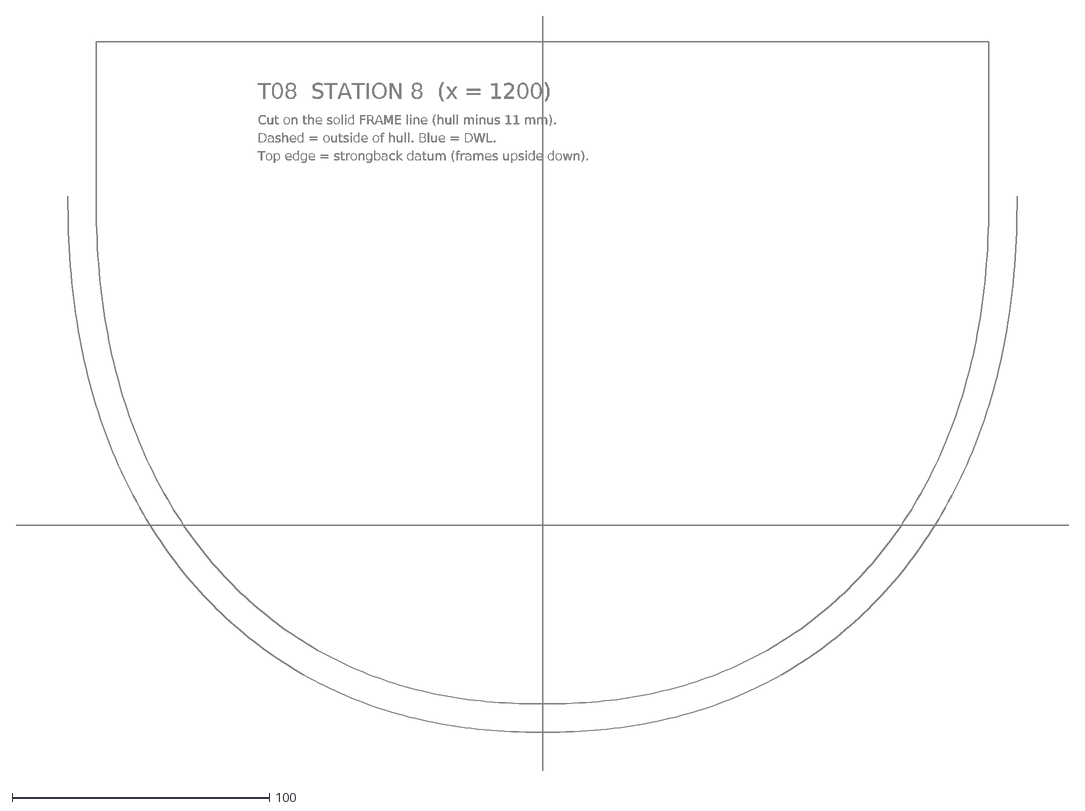
[picture p22: CAD file, 2026-11-11]
build-files/dxf/T08_frame_station_8.dxf
T08 STATION 8 (x = 1200)
Cut on the solid FRAME line (hull minus 11 mm).
Dashed = outside of hull. Blue = DWL.
Top edge = strongback datum (frames upside down).
