sheltonr2/drone-boat/build-files/stl/P19_yb3_platform.stl

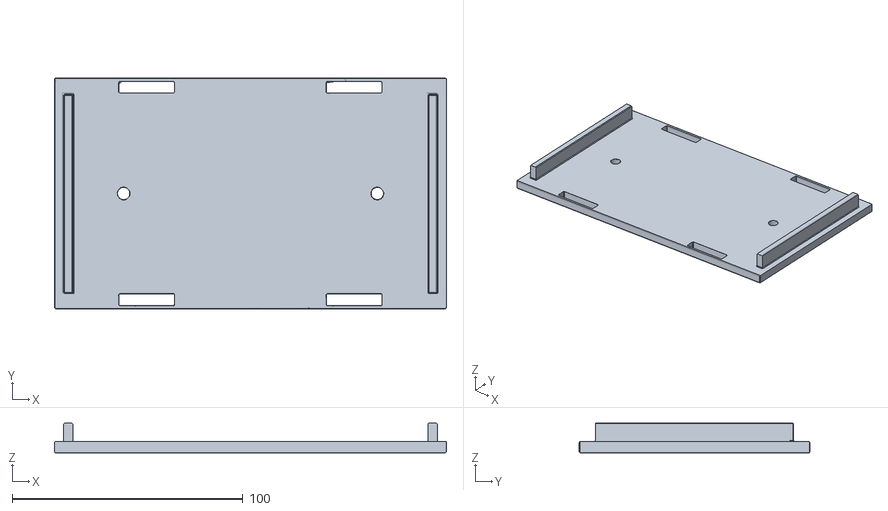
[picture p23: CAD file, 2026-11-11]
build-files/stl/P19_yb3_platform.stl
170.0 x 100.0 x 13.0
