sheltonr2/drone-boat/build-files/dxf/T05_frame_station_5.dxf

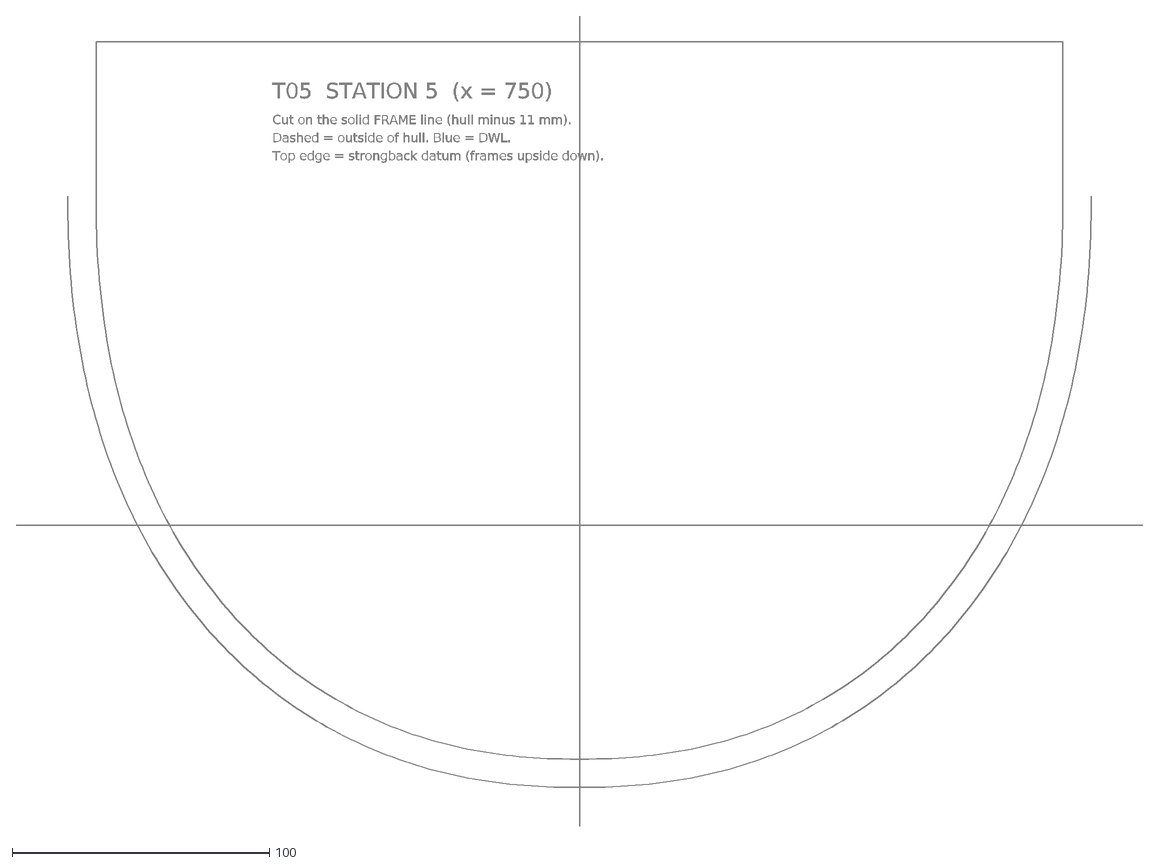
[picture p24: CAD file, 2026-11-11]
build-files/dxf/T05_frame_station_5.dxf
T05 STATION 5 (x = 750)
Cut on the solid FRAME line (hull minus 11 mm).
Dashed = outside of hull. Blue = DWL.
Top edge = strongback datum (frames upside down).
