sheltonr2/drone-boat/build-files/stl/P14a_bulb_pattern_fwd.stl

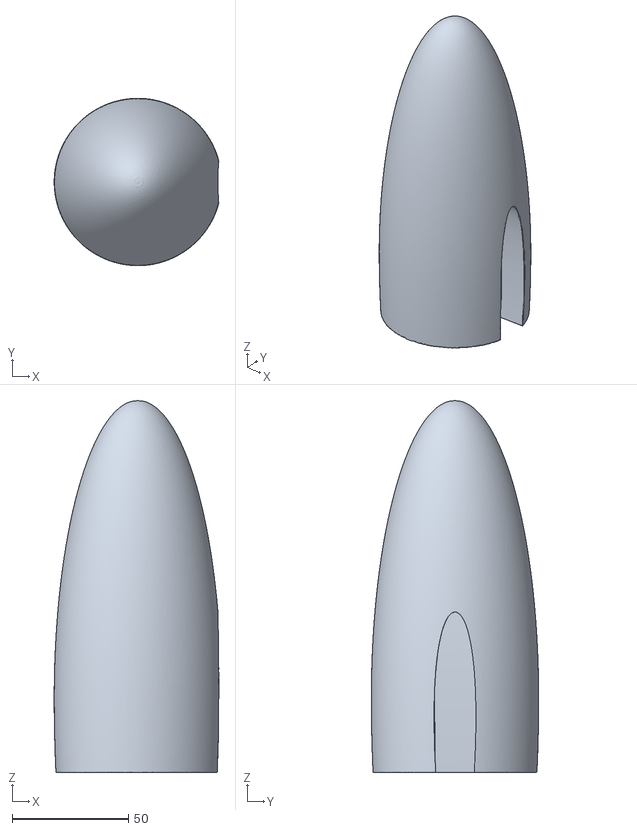
[picture p25: CAD file, 2026-11-10]
build-files/stl/P14a_bulb_pattern_fwd.stl
70.8 x 72.0 x 160.0
