sheltonr2/drone-boat/build-files/dxf/T03_frame_station_3.dxf

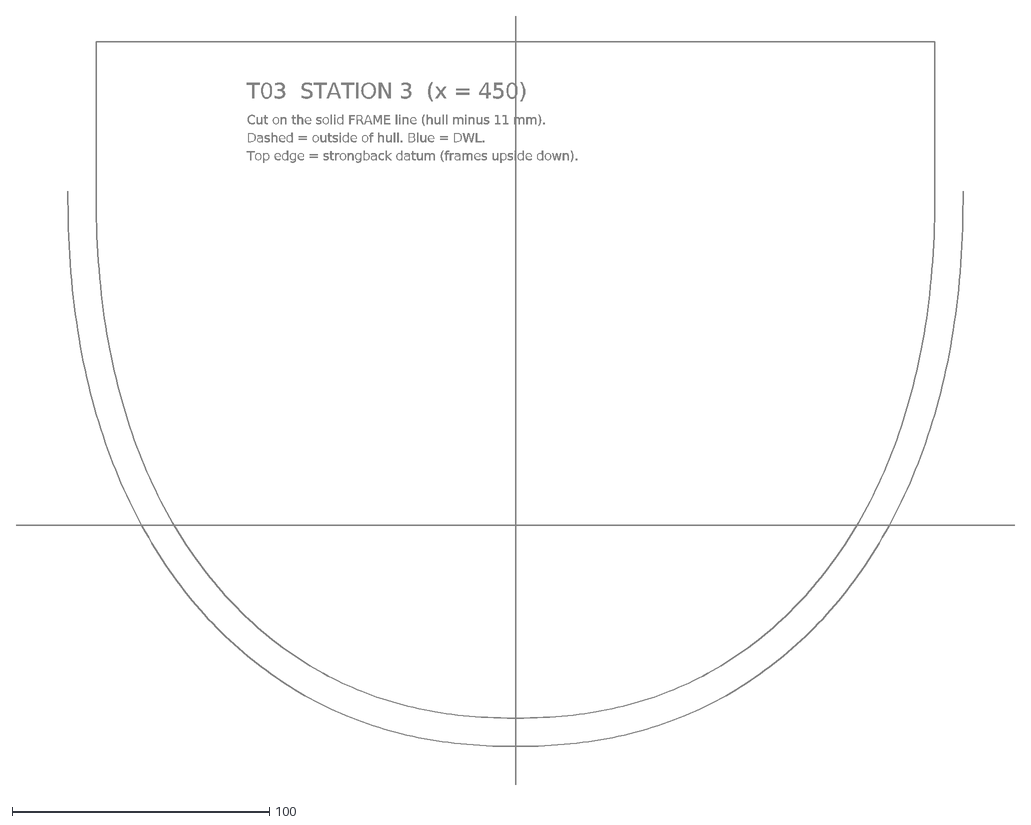
[picture p26: CAD file, 2026-11-11]
build-files/dxf/T03_frame_station_3.dxf
T03 STATION 3 (x = 450)
Cut on the solid FRAME line (hull minus 11 mm).
Dashed = outside of hull. Blue = DWL.
Top edge = strongback datum (frames upside down).
