sheltonr2/drone-boat/build-files/stl/P14b_bulb_pattern_aft.stl

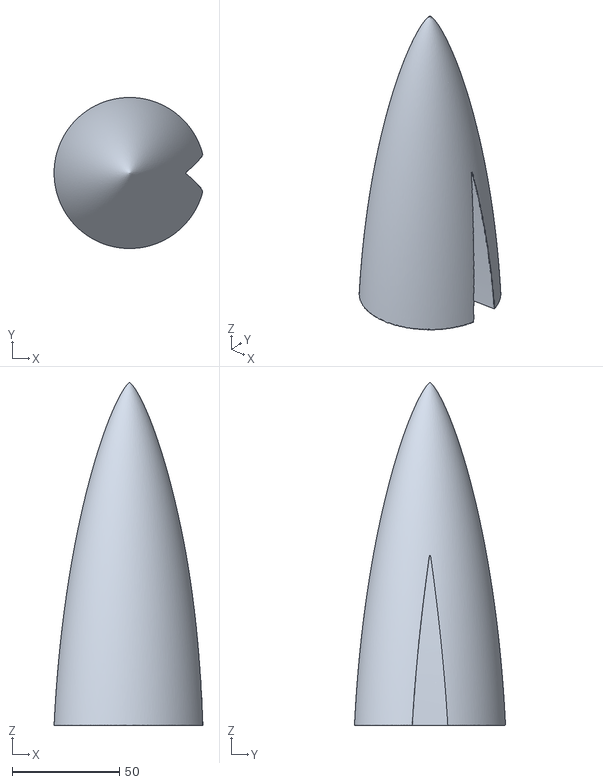
[picture p27: CAD file, 2026-11-10]
build-files/stl/P14b_bulb_pattern_aft.stl
69.4 x 70.4 x 160.0
