sheltonr2/drone-boat/build-files/dxf/T17_bulkhead_x300.dxf

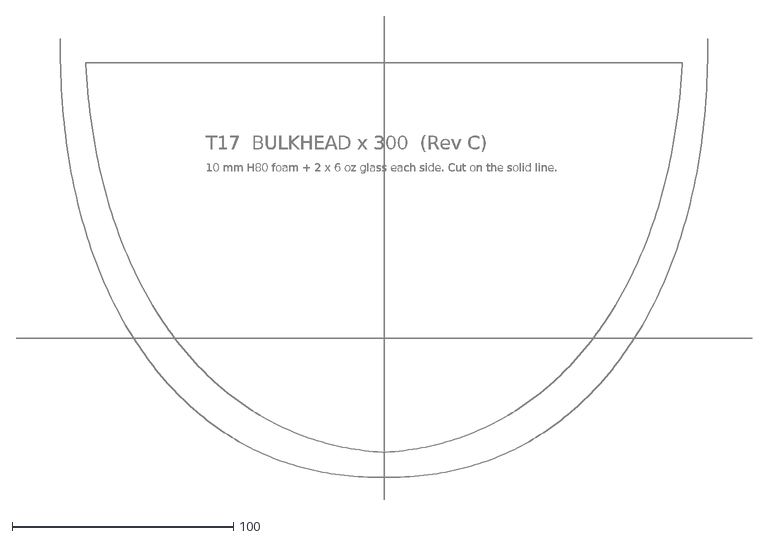
[picture p28: CAD file, 2026-11-11]
build-files/dxf/T17_bulkhead_x300.dxf
T17 BULKHEAD x 300 (Rev C)
10 mm H80 foam + 2 x 6 oz glass each side. Cut on the solid line.
