sheltonr2/drone-boat/build-files/stl/P20_nav_light_clamp.stl

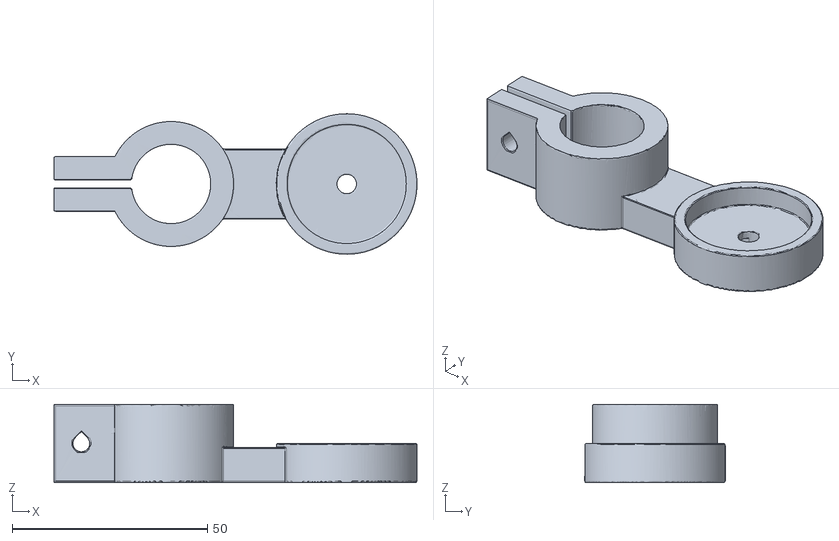
[picture p29: CAD file, 2026-11-10]
build-files/stl/P20_nav_light_clamp.stl
93.0 x 36.0 x 20.0
