sheltonr2/drone-boat/build-files/stl/P18_counterweight_pod.stl

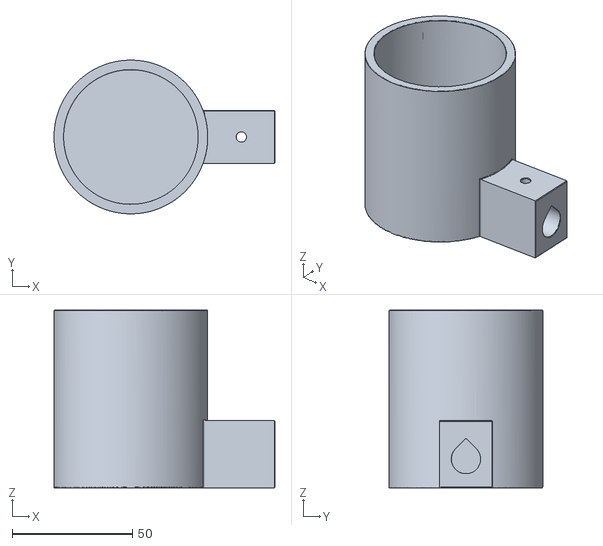
[picture p31: CAD file, 2026-11-08]
build-files/stl/P18_counterweight_pod.stl
92.0 x 64.0 x 74.0
