sheltonr2/drone-boat/build-files/dxf/T19_keel_floor_x650.dxf

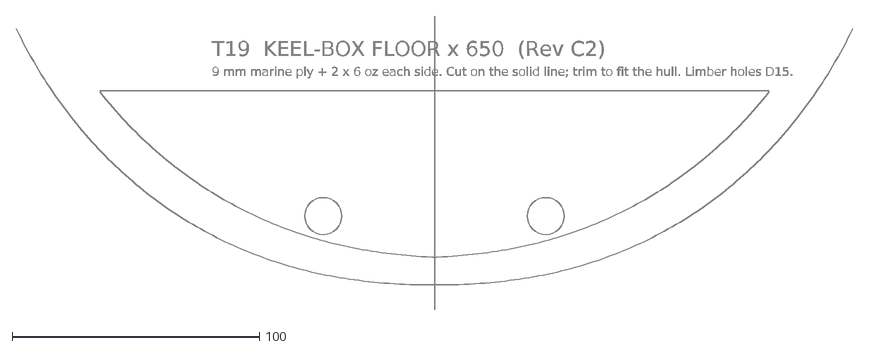
[picture p32: CAD file, 2026-11-11]
build-files/dxf/T19_keel_floor_x650.dxf
T19 KEEL-BOX FLOOR x 650 (Rev C2)
9 mm marine ply + 2 x 6 oz each side. Cut on the solid line; trim to fit the hull. Limber holes D15.
