sheltonr2/drone-boat/build-files/stl/P01_vane_housing.stl

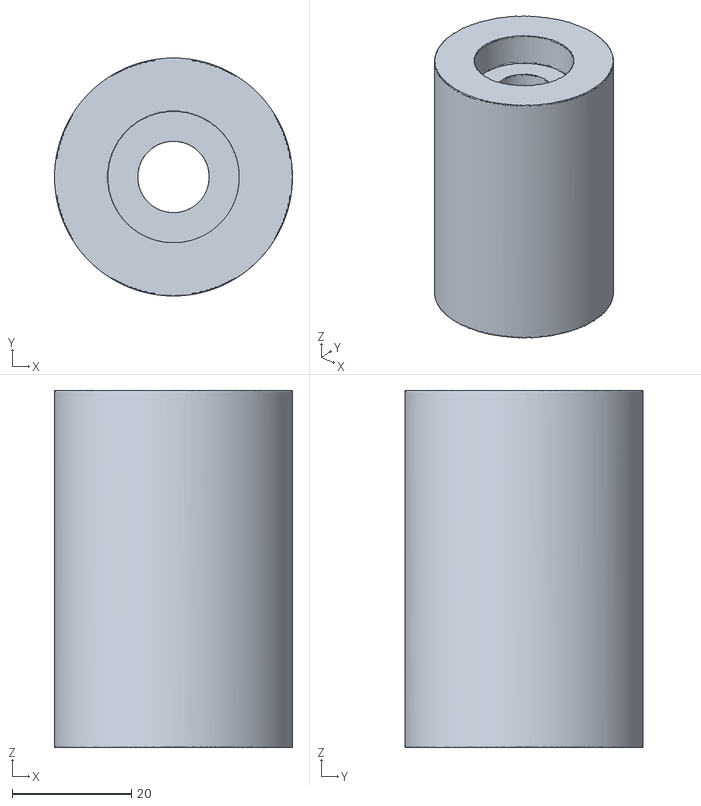
[picture p33: CAD file, 2026-11-08]
build-files/stl/P01_vane_housing.stl
40.0 x 40.0 x 60.0
