sheltonr2/drone-boat/build-files/dxf/T20_keel_floor_x800.dxf

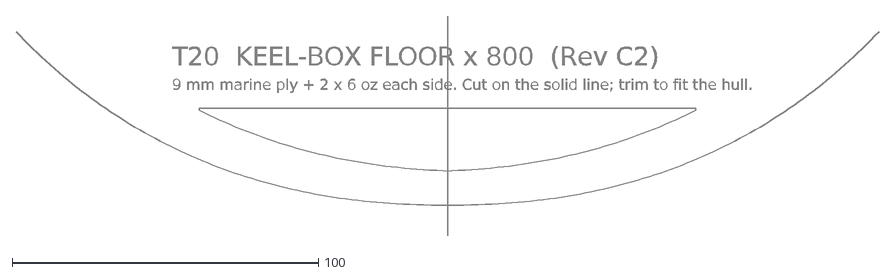
[picture p34: CAD file, 2026-11-11]
build-files/dxf/T20_keel_floor_x800.dxf
T20 KEEL-BOX FLOOR x 800 (Rev C2)
9 mm marine ply + 2 x 6 oz each side. Cut on the solid line; trim to fit the hull.
