sheltonr2/drone-boat/build-files/stl/P03_sensor_cap.stl

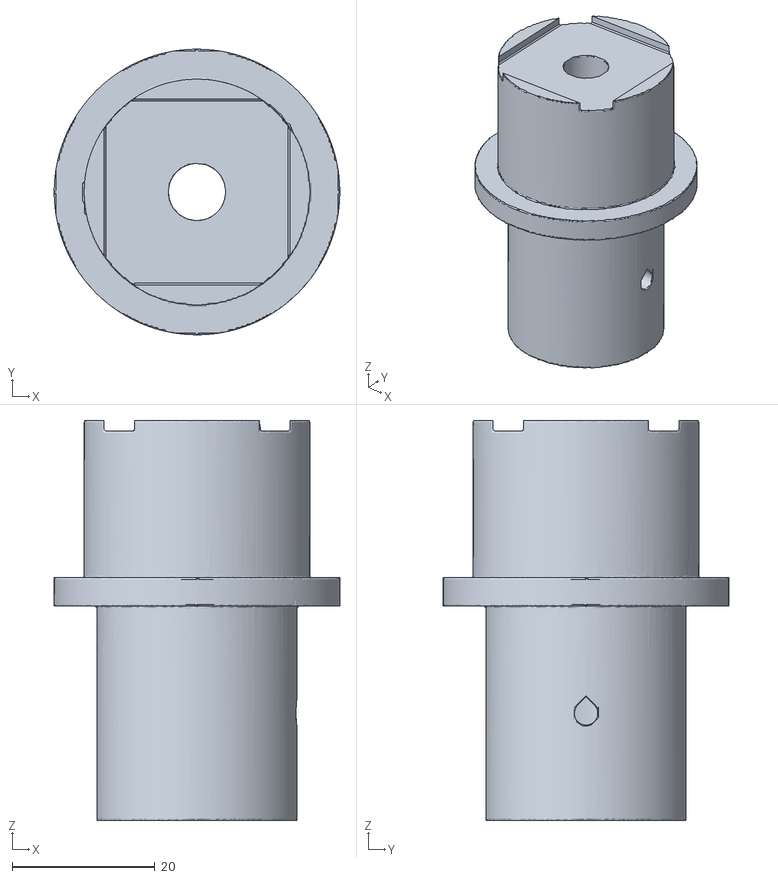
[picture p35: CAD file, 2026-11-08]
build-files/stl/P03_sensor_cap.stl
40.0 x 40.0 x 56.0
