sheltonr2/drone-boat/build-files/dxf/T13_fin_tip.dxf

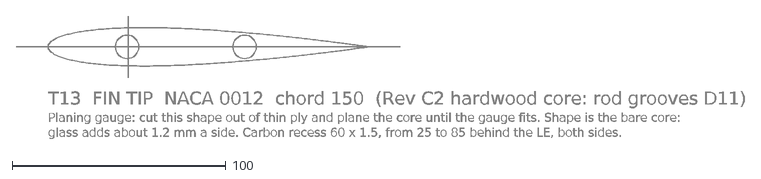
[picture p36: CAD file, 2026-11-11]
build-files/dxf/T13_fin_tip.dxf
T13 FIN TIP NACA 0012 chord 150 (Rev C2 hardwood core: rod grooves D11)
Planing gauge: cut this shape out of thin ply and plane the core until the gauge fits. Shape is the bare core:
glass adds about 1.2 mm a side. Carbon recess 60 x 1.5, from 25 to 85 behind the LE, both sides.
