sheltonr2/drone-boat/build-files/stl/P13b_rudder_core_lower.stl

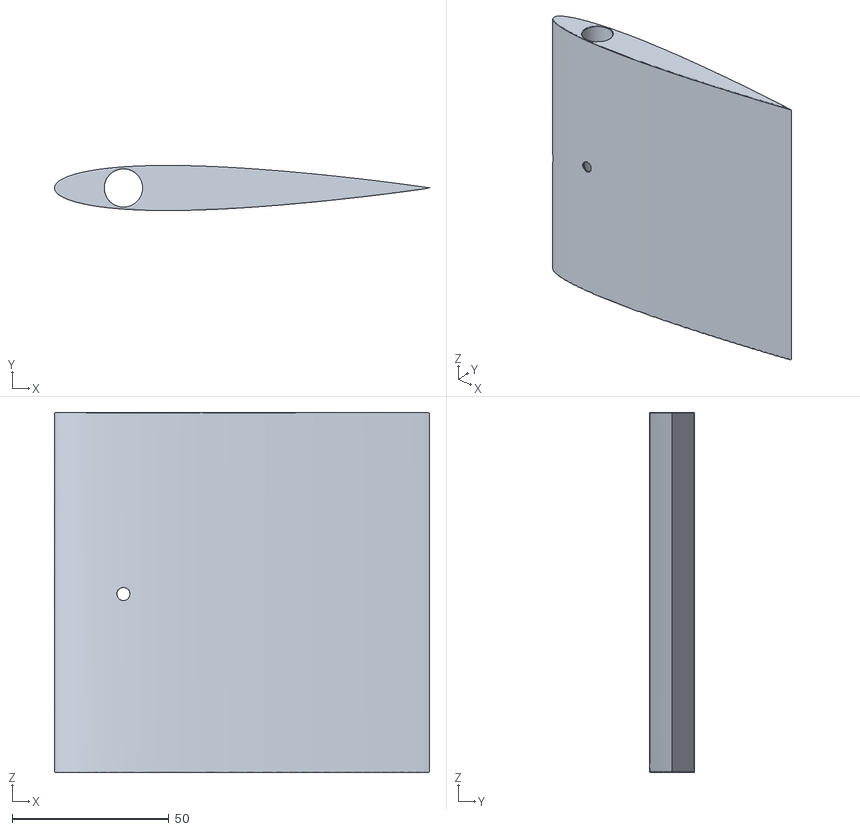
[picture p37: CAD file, 2026-11-08]
build-files/stl/P13b_rudder_core_lower.stl
119.6 x 14.4 x 115.0
