sheltonr2/drone-boat/build-files/dxf/T14_rudder.dxf

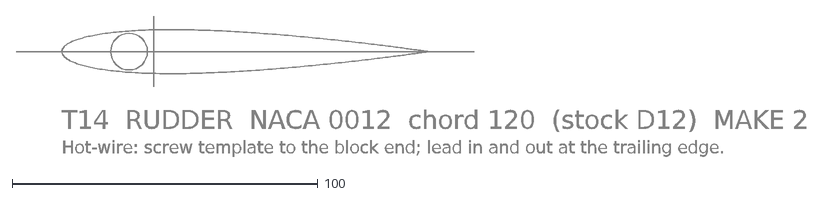
[picture p38: CAD file, 2026-11-10]
build-files/dxf/T14_rudder.dxf
T14 RUDDER NACA 0012 chord 120 (stock D12) MAKE 2
Hot-wire: screw template to the block end; lead in and out at the trailing edge.
