sheltonr2/drone-boat/build-files/stl/P16_battery_strap_anchor_x4.stl

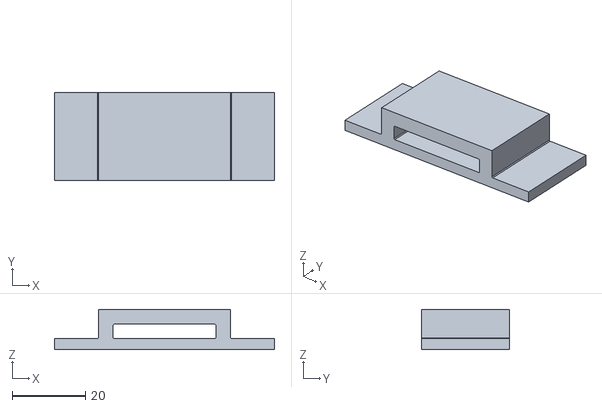
[picture p39: CAD file, 2026-11-08]
build-files/stl/P16_battery_strap_anchor_x4.stl
60.0 x 24.0 x 11.0
