sheltonr2/drone-boat/build-files/dxf/body_plan_all_stations.dxf

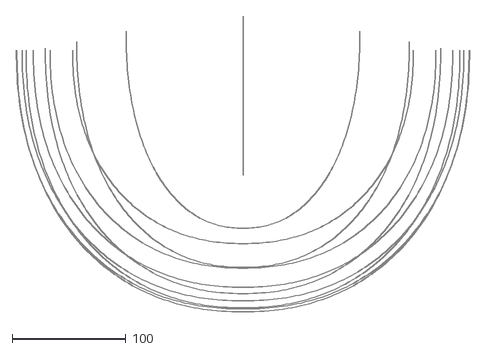
[picture p40: CAD file, 2026-11-08]
build-files/dxf/body_plan_all_stations.dxf
398.8 x 260.0
