sheltonr2/drone-boat/build-files/stl/P10a_tail_fin_lower.stl

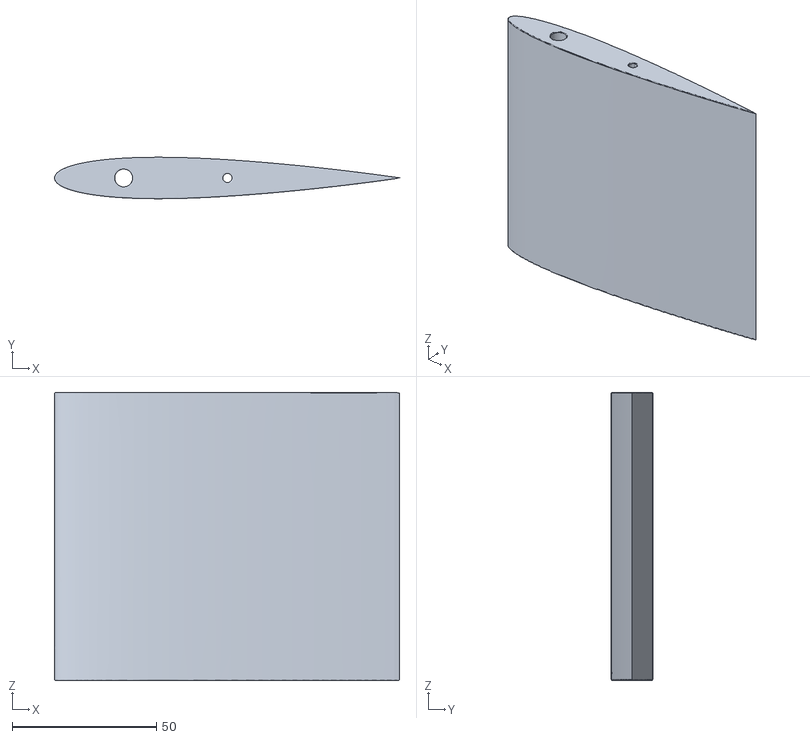
[picture p41: CAD file, 2026-11-08]
build-files/stl/P10a_tail_fin_lower.stl
119.6 x 14.4 x 100.0
