sheltonr2/drone-boat/build-files/dxf/T10_transom.dxf

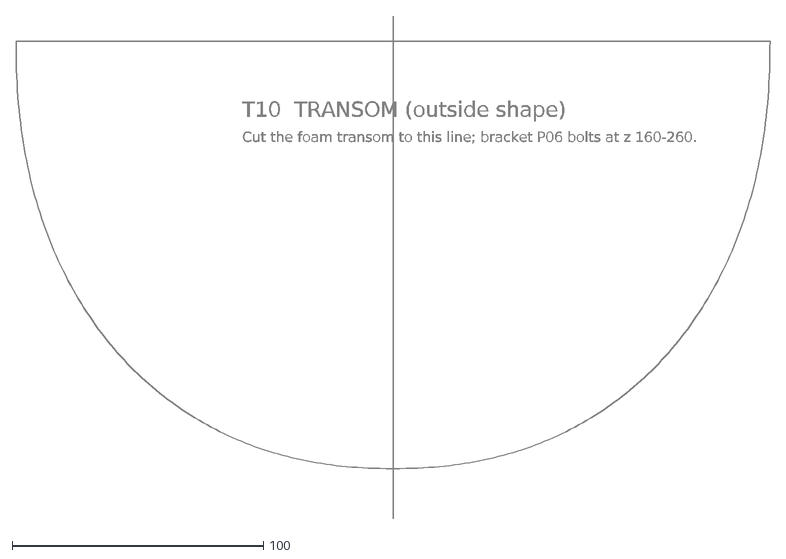
[picture p42: CAD file, 2026-11-08]
build-files/dxf/T10_transom.dxf
T10 TRANSOM (outside shape)
Cut the foam transom to this line; bracket P06 bolts at z 160-260.
