sheltonr2/drone-boat/build-files/stl/P05_antenna_platform.stl

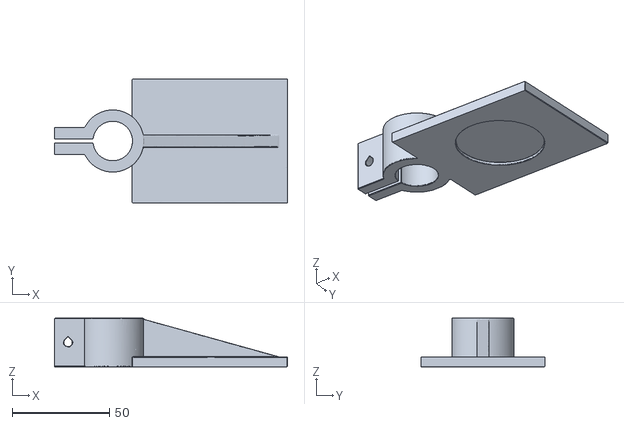
[picture p43: CAD file, 2026-11-08]
build-files/stl/P05_antenna_platform.stl
120.0 x 64.0 x 25.0
