sheltonr2/drone-boat/build-files/dxf/T11_stem_profile.dxf

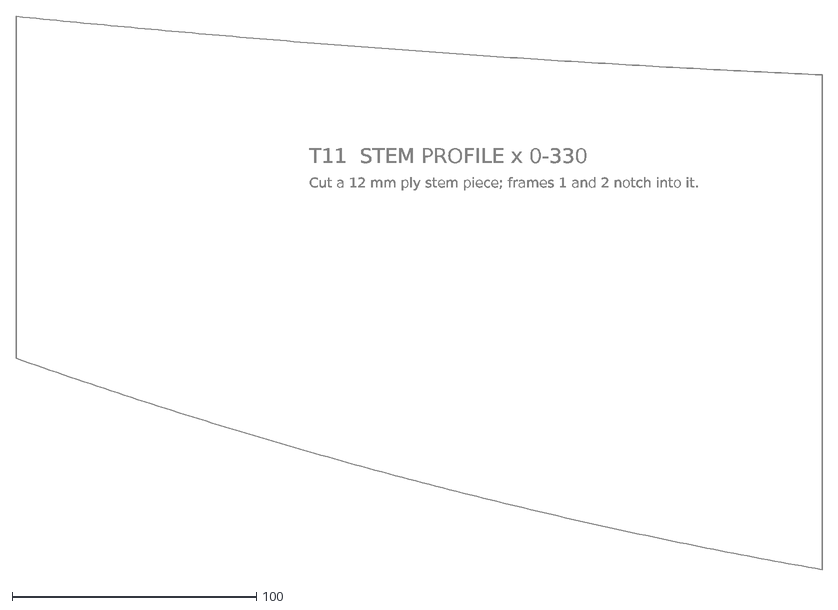
[picture p44: CAD file, 2026-11-08]
build-files/dxf/T11_stem_profile.dxf
T11 STEM PROFILE x 0-330
Cut a 12 mm ply stem piece; frames 1 and 2 notch into it.
