sheltonr2/drone-boat/build-files/stl/P06_transom_bracket.stl

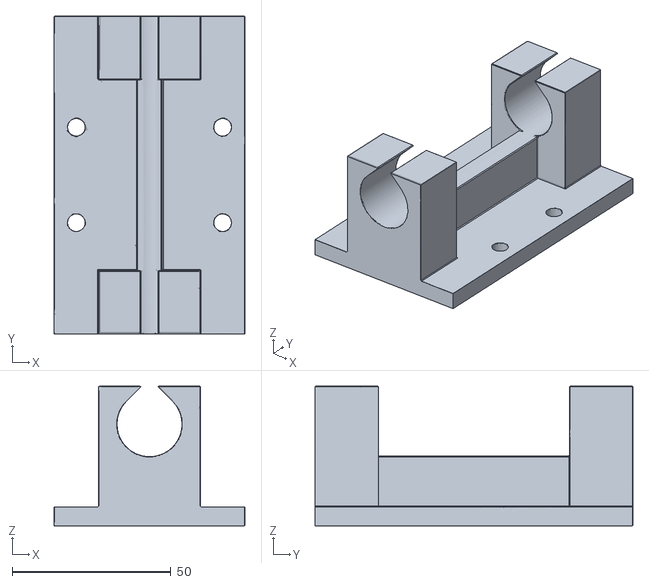
[picture p45: CAD file, 2026-11-08]
build-files/stl/P06_transom_bracket.stl
60.0 x 100.0 x 44.0
