sheltonr2/drone-boat/build-files/stl/P17_penetrator_pad_x4.stl

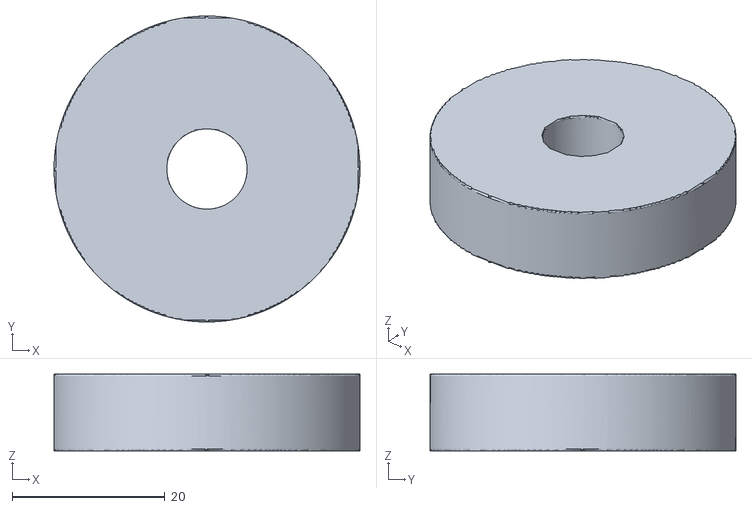
[picture p46: CAD file, 2026-11-08]
build-files/stl/P17_penetrator_pad_x4.stl
40.0 x 40.0 x 10.0
