sheltonr2/drone-boat/build-files/stl/P15_electronics_tray.stl

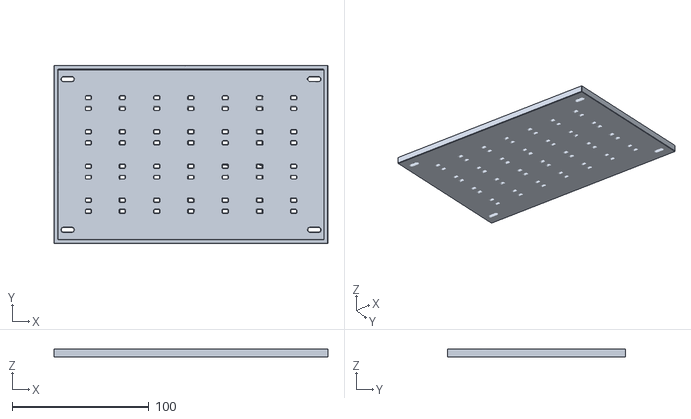
[picture p47: CAD file, 2026-11-08]
build-files/stl/P15_electronics_tray.stl
200.0 x 130.0 x 6.00
