sheltonr2/drone-boat/build-files/stl/P04_magnet_holder.stl

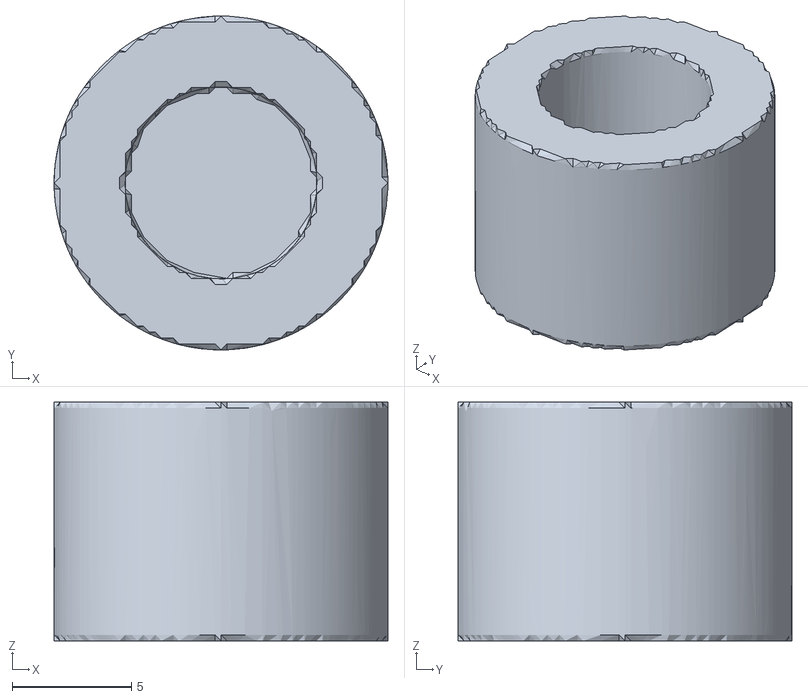
[picture p48: CAD file, 2026-11-08]
build-files/stl/P04_magnet_holder.stl
14.0 x 14.0 x 10.0
