sheltonr2/drone-boat/build-files/stl/P11_tiller_arm.stl

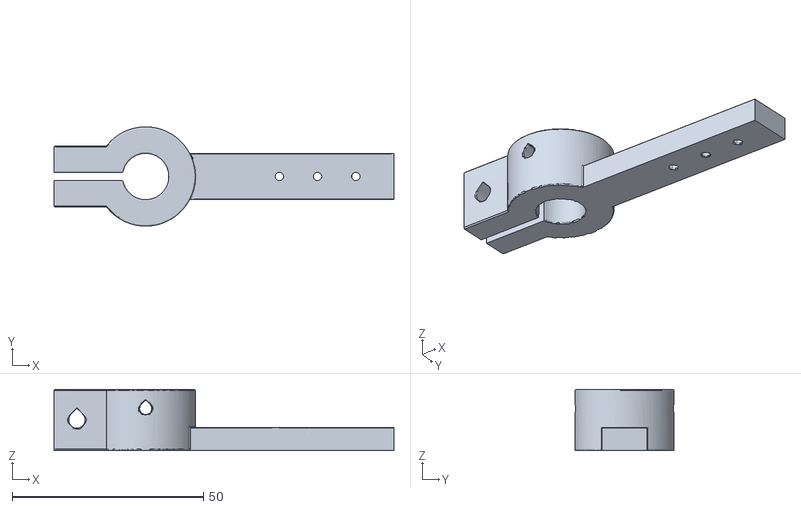
[picture p49: CAD file, 2026-11-08]
build-files/stl/P11_tiller_arm.stl
89.0 x 26.0 x 16.0
