sheltonr2/drone-boat/build-files/stl/P02_vane_arm.stl

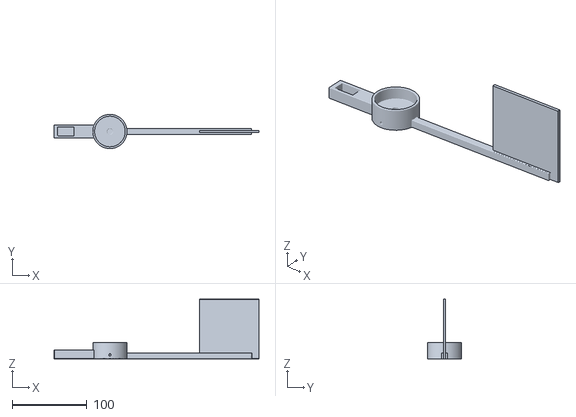
[picture p50: CAD file, 2026-11-08]
build-files/stl/P02_vane_arm.stl
275.0 x 46.0 x 80.0
