sheltonr2/drone-boat/(list of files, cad)

Other CAD files:
build-files/stl/P13a_rudder_core_upper.stl
build-files/stl/P10b_tail_fin_upper.stl
