sheltonr2/drone-boat/build-files/Templates_1to1_Letter.pdf

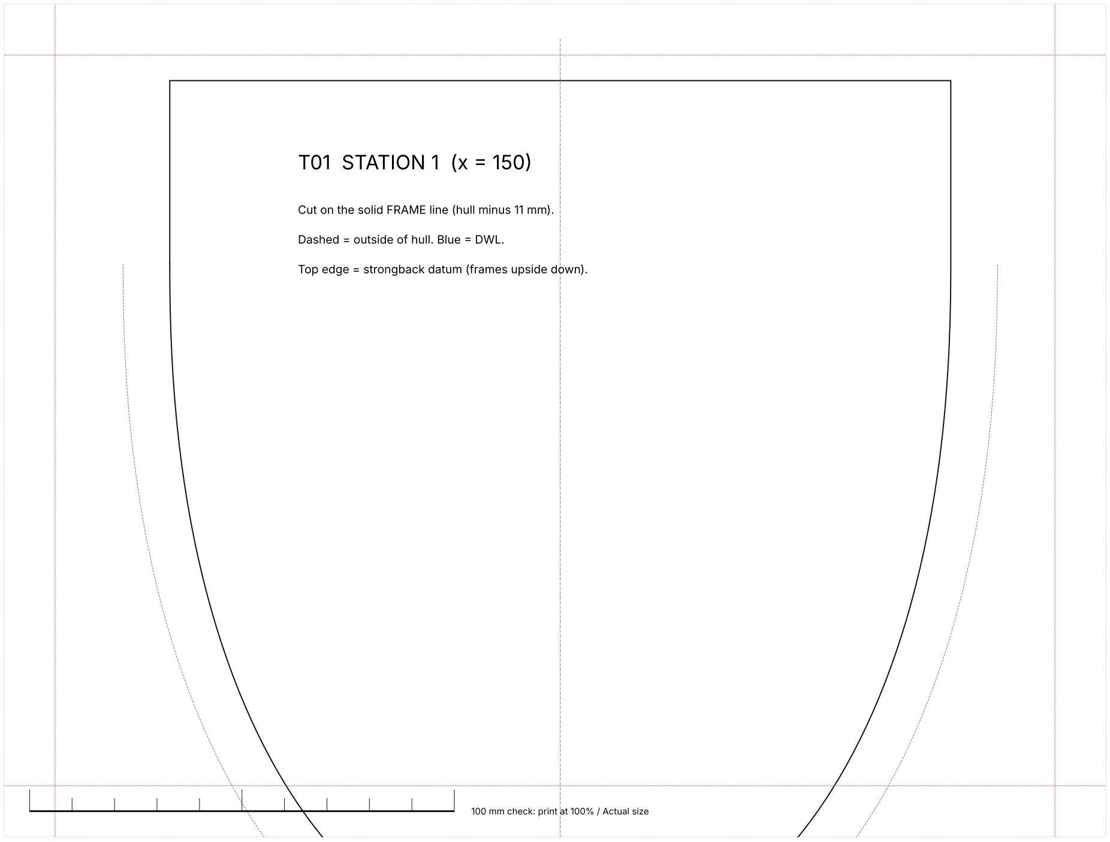
[picture p67: figure]
T01 STATION 1 (x = 150); Dashed = outside of hull. Blue = DWL.

Cut on the solid FRAME line (hull minus 11 mm).

Top edge = strongback datum (frames upside down).

100 mm check: print at 100% / Actual size

Hull frame, station 1 (x 150) | page 1 of 4 (row 1, col 1) | 1:1, mm | overlap 12 mm: align the red dashed lines

Hull frame, station 1 (x 150) | page 2 of 4 (row 1, col 2) | 1:1, mm | overlap 12 mm: align the red dashed lines

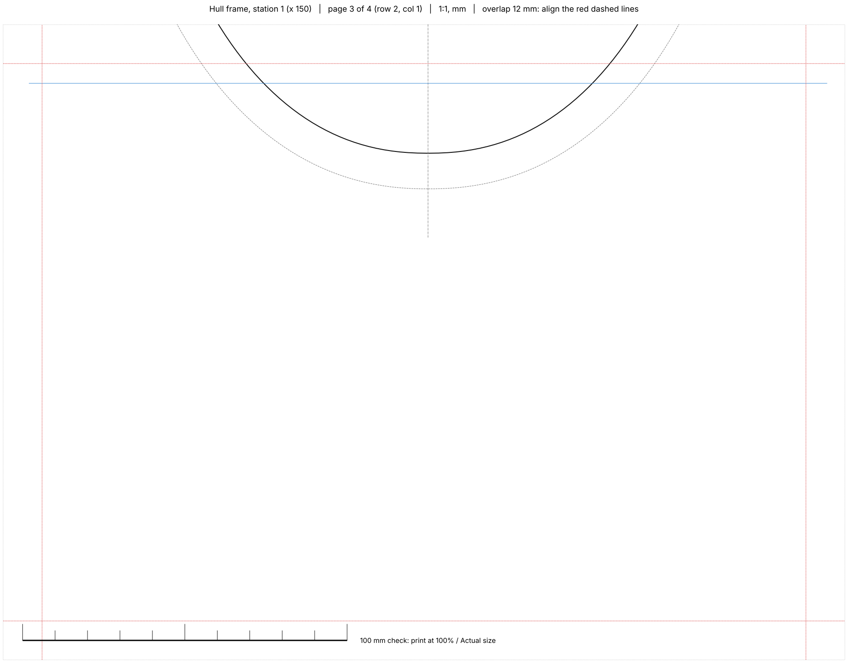
[picture p68: figure]

Hull frame, station 1 (x 150) | page 3 of 4 (row 2, col 1) | 1:1, mm | overlap 12 mm: align the red dashed lines

Hull frame, station 1 (x 150) | page 4 of 4 (row 2, col 2) | 1:1, mm | overlap 12 mm: align the red dashed lines

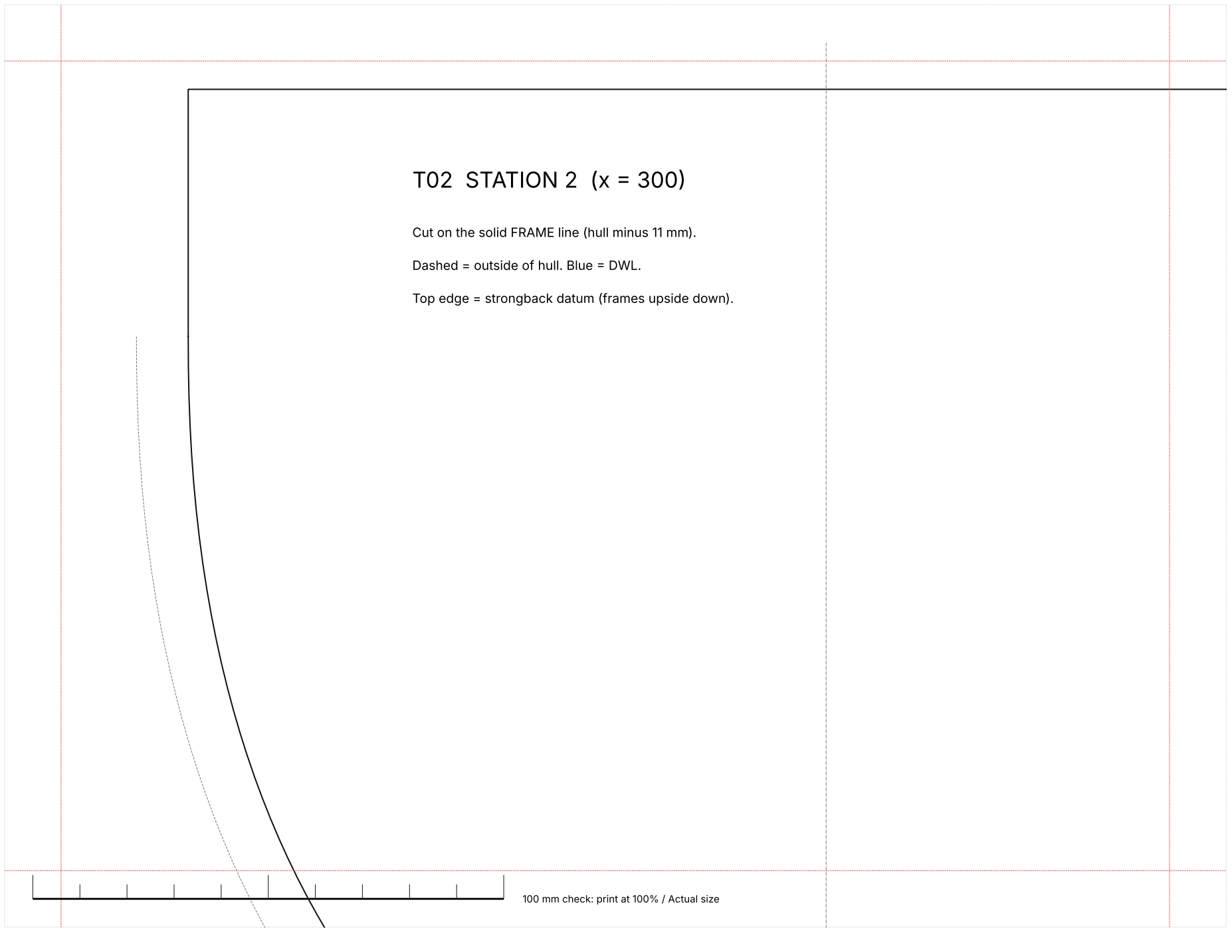
[picture p69: figure]
T02 STATION 2 (x = 300); Dashed = outside of hull. Blue = DWL.

Cut on the solid FRAME line (hull minus 11 mm).

Top edge = strongback datum (frames upside down).

Hull frame, station 2 (x 300) | page 1 of 4 (row 1, col 1) | 1:1, mm | overlap 12 mm: align the red dashed lines

Hull frame, station 2 (x 300) | page 2 of 4 (row 1, col 2) | 1:1, mm | overlap 12 mm: align the red dashed lines

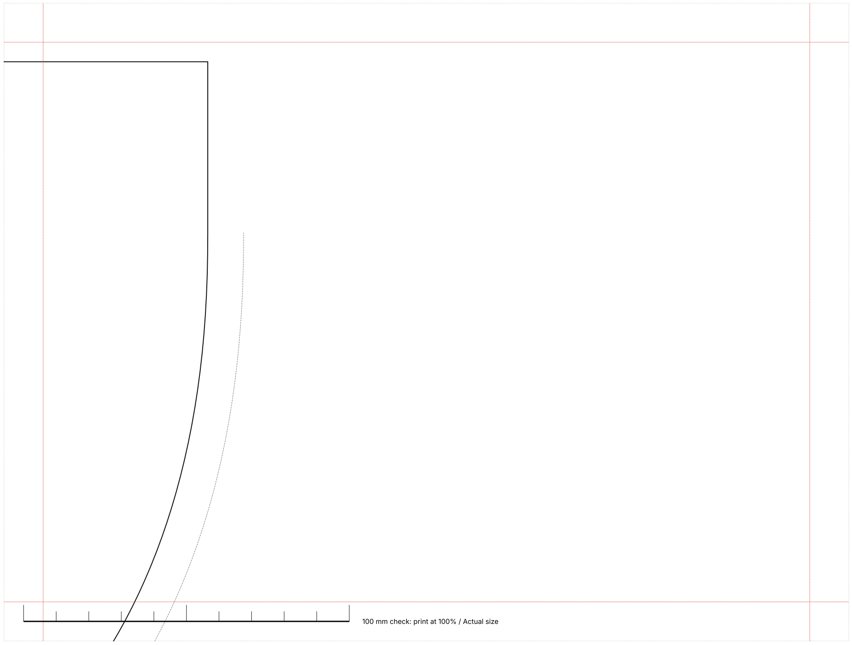
[picture p70: figure]

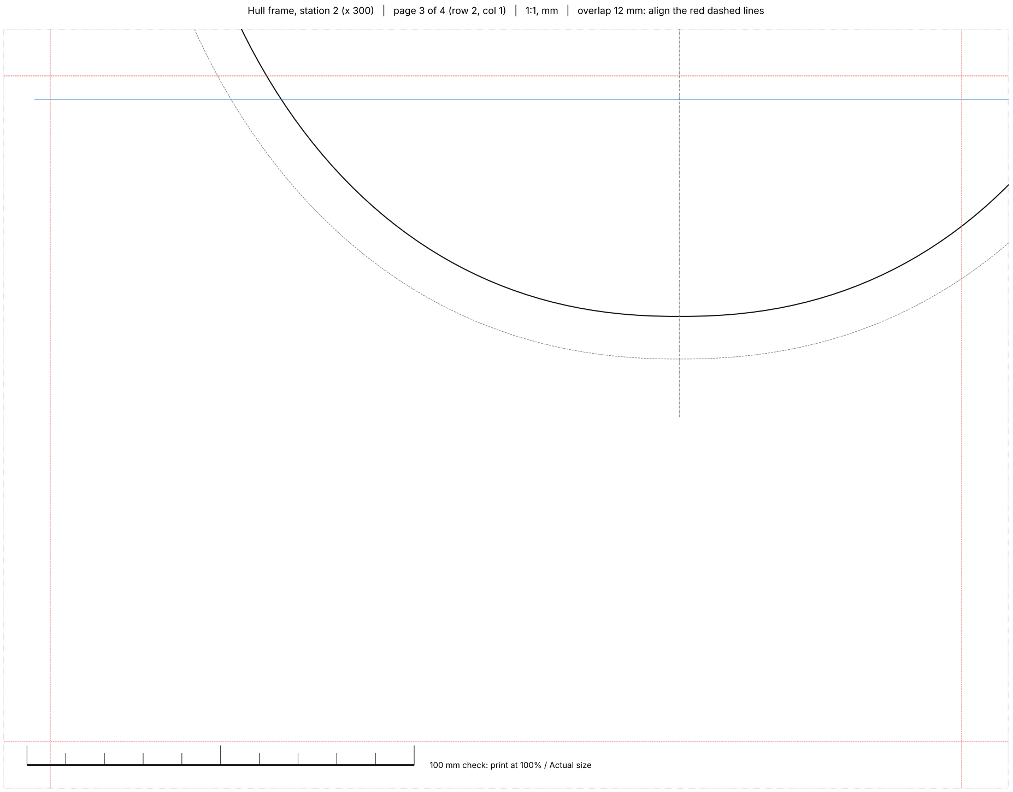
[picture p71: figure]

Hull frame, station 2 (x 300) | page 3 of 4 (row 2, col 1) | 1:1, mm | overlap 12 mm: align the red dashed lines

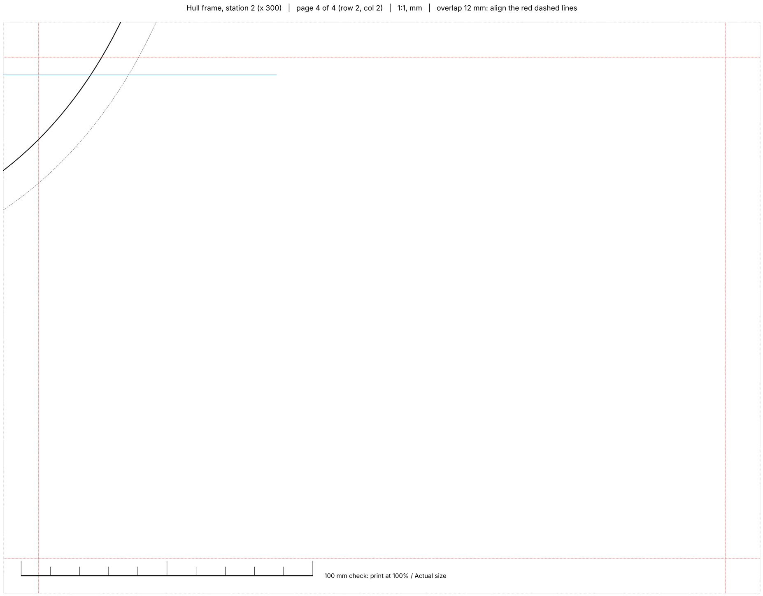
[picture p72: figure]

Hull frame, station 2 (x 300) | page 4 of 4 (row 2, col 2) | 1:1, mm | overlap 12 mm: align the red dashed lines

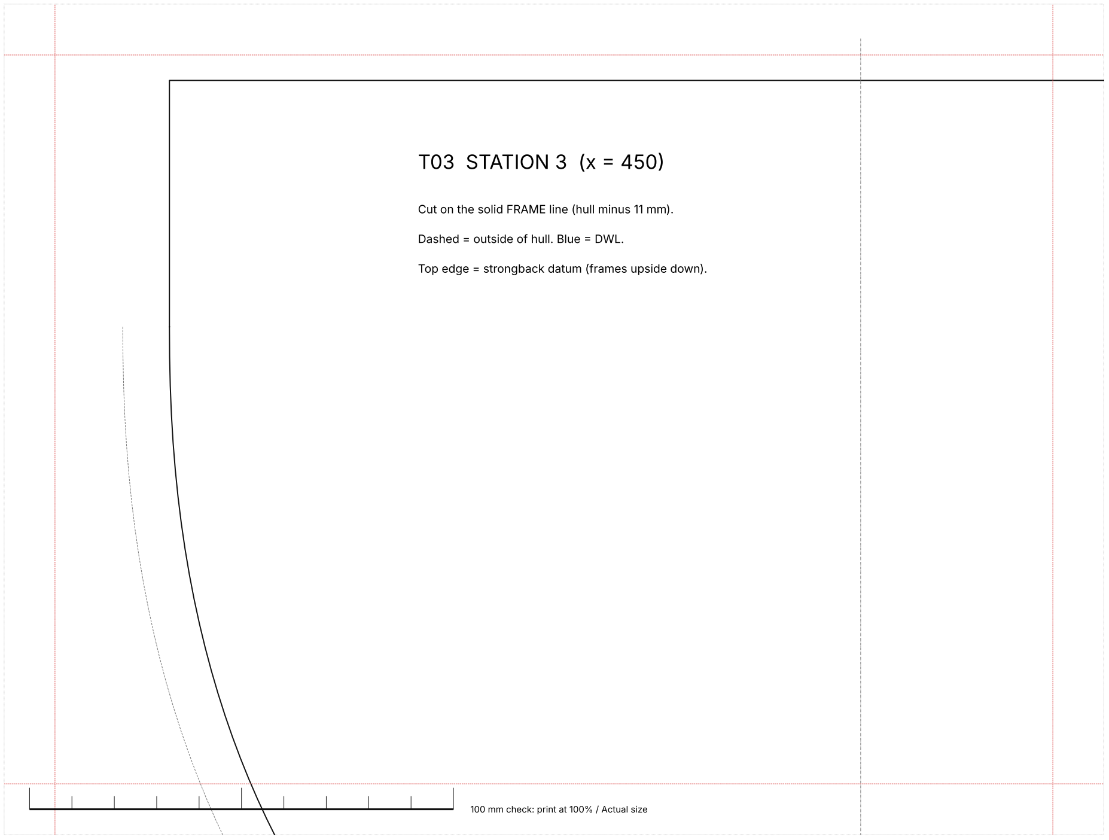
[picture p73: figure]
T03 STATION 3 (x = 450); Dashed = outside of hull. Blue = DWL.

Cut on the solid FRAME line (hull minus 11 mm).

Top edge = strongback datum (frames upside down).

Hull frame, station 3 (x 450) | page 1 of 4 (row 1, col 1) | 1:1, mm | overlap 12 mm: align the red dashed lines

Hull frame, station 3 (x 450) | page 2 of 4 (row 1, col 2) | 1:1, mm | overlap 12 mm: align the red dashed lines

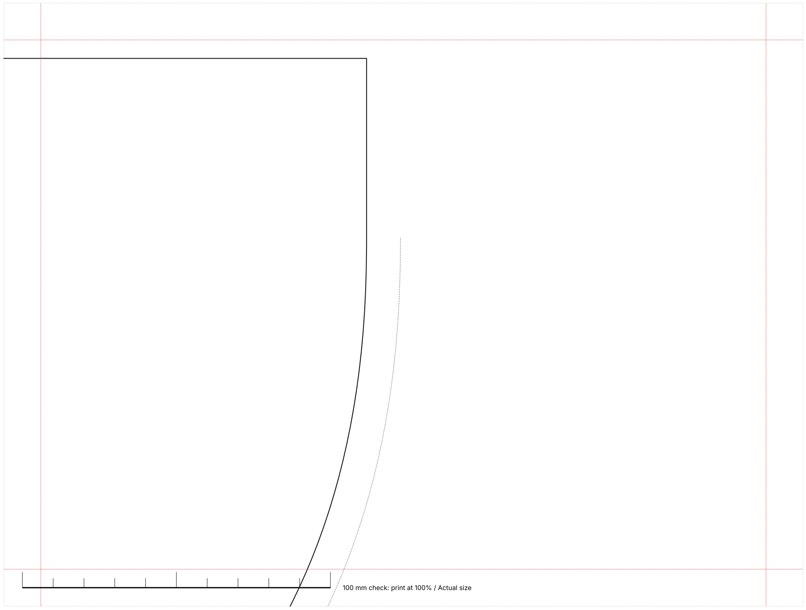
[picture p74: figure]

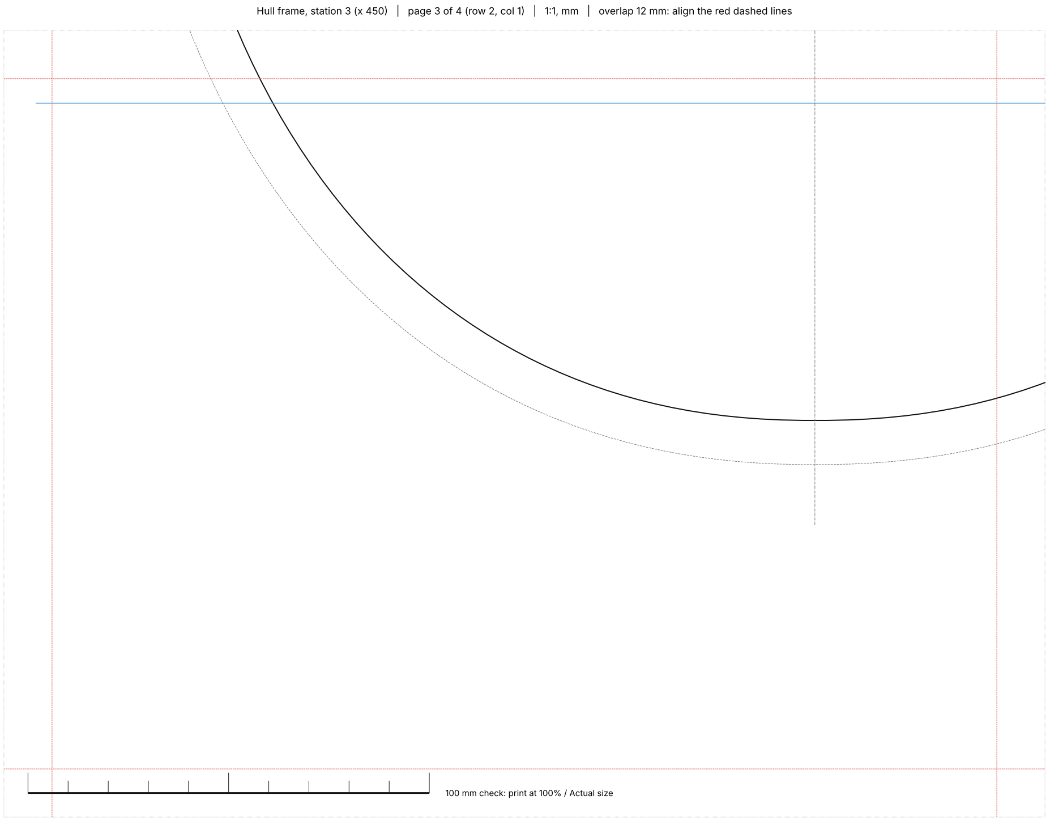
[picture p75: figure]

Hull frame, station 3 (x 450) | page 3 of 4 (row 2, col 1) | 1:1, mm | overlap 12 mm: align the red dashed lines

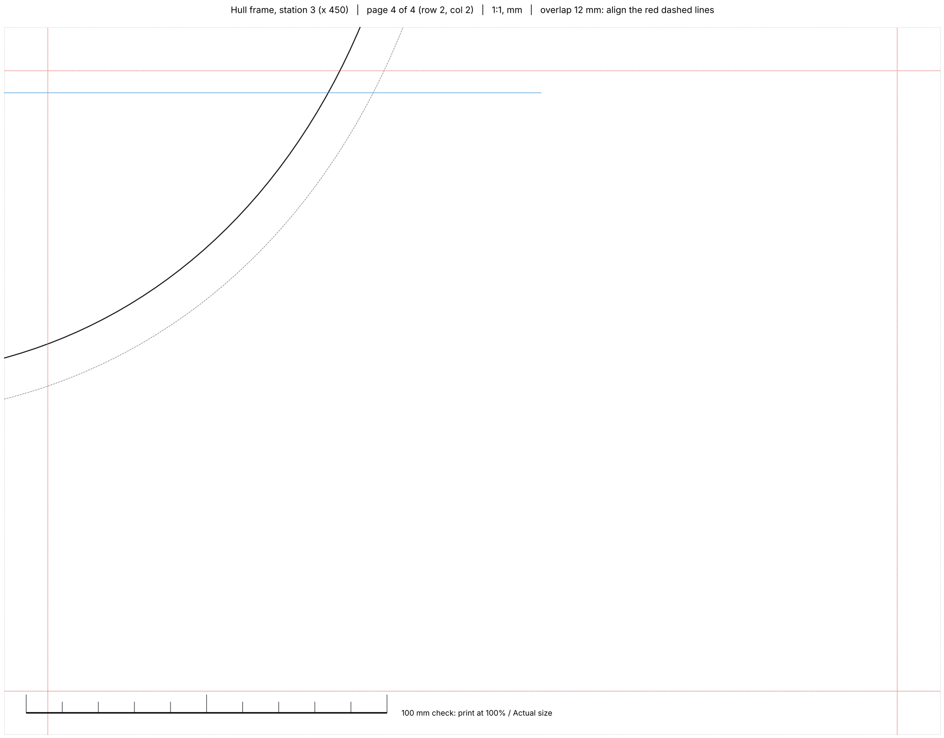
[picture p76: figure]

Hull frame, station 3 (x 450) | page 4 of 4 (row 2, col 2) | 1:1, mm | overlap 12 mm: align the red dashed lines

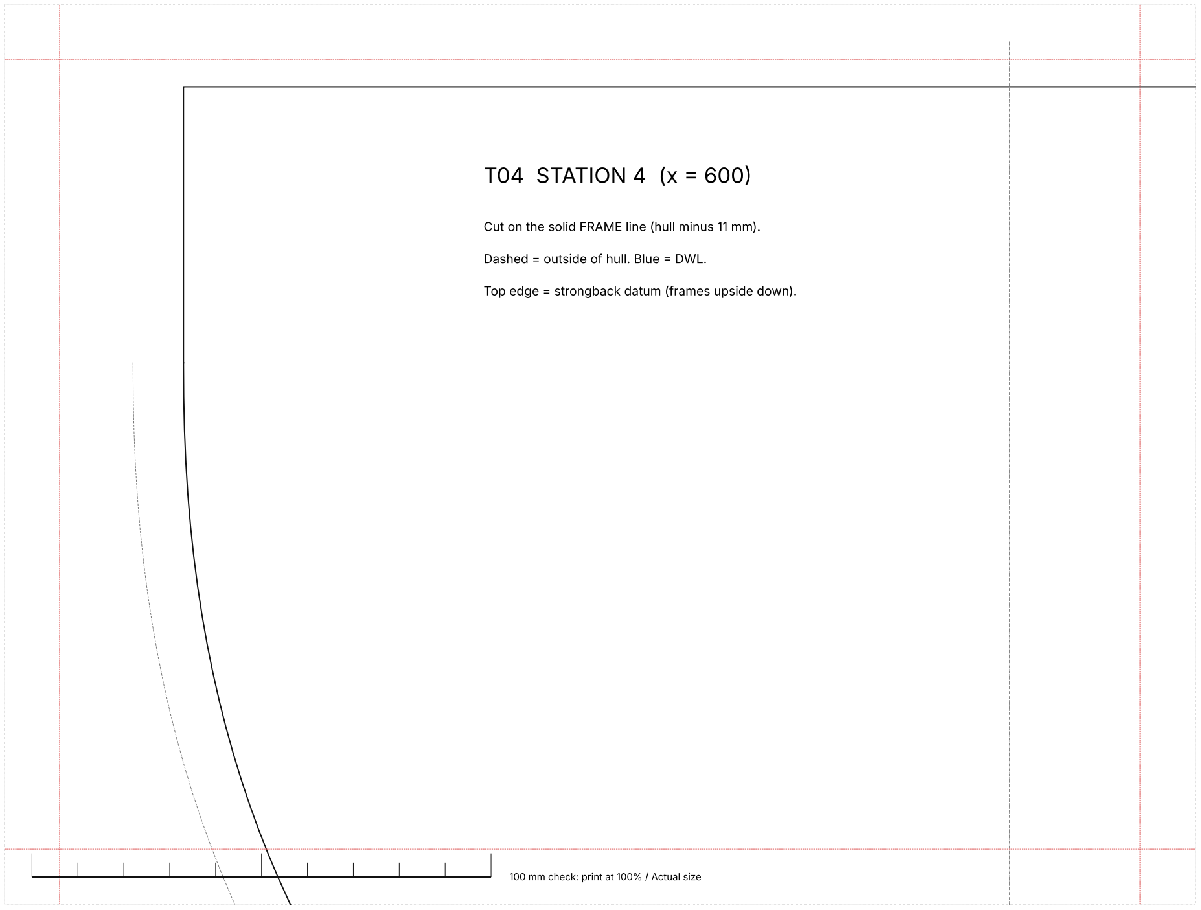
[picture p77: figure]
T04 STATION 4 (x = 600); Dashed = outside of hull. Blue = DWL.

Cut on the solid FRAME line (hull minus 11 mm).

Top edge = strongback datum (frames upside down).

Hull frame, station 4 (x 600) | page 1 of 4 (row 1, col 1) | 1:1, mm | overlap 12 mm: align the red dashed lines

Hull frame, station 4 (x 600) | page 2 of 4 (row 1, col 2) | 1:1, mm | overlap 12 mm: align the red dashed lines

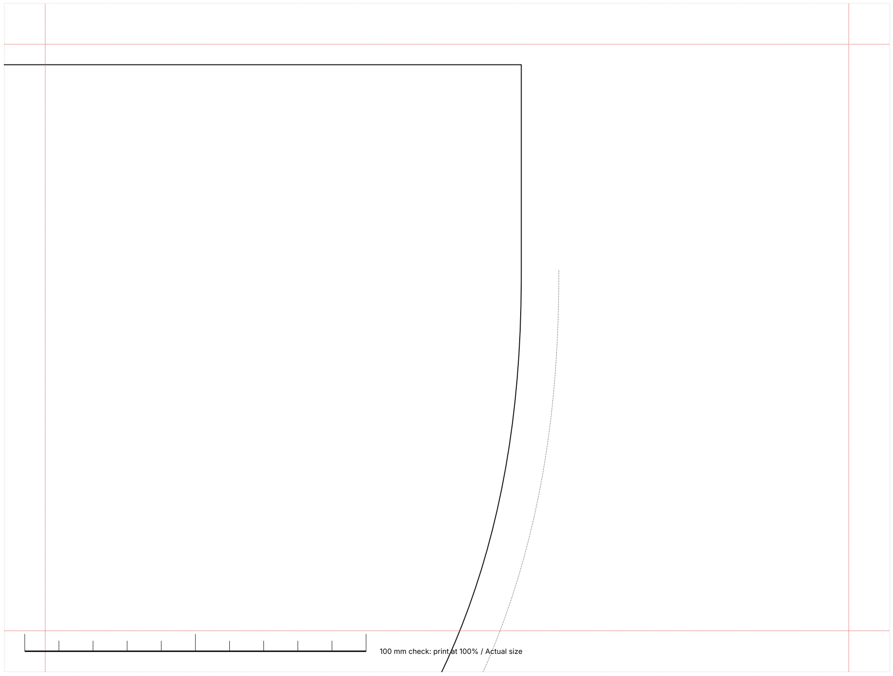
[picture p78: figure]

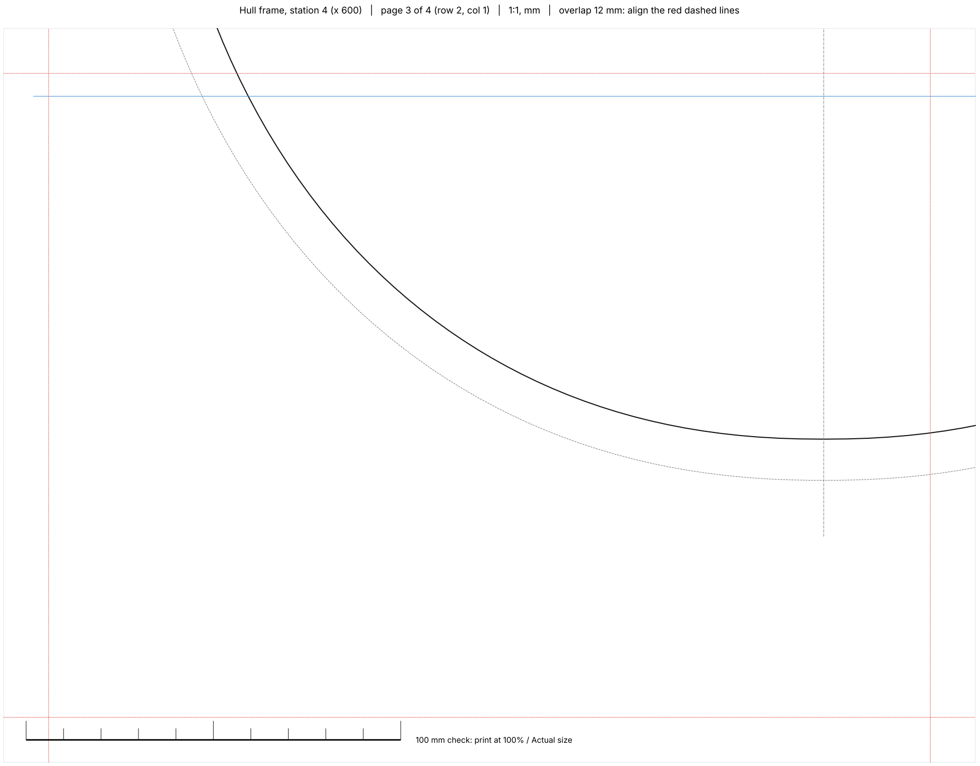
[picture p79: figure]

Hull frame, station 4 (x 600) | page 3 of 4 (row 2, col 1) | 1:1, mm | overlap 12 mm: align the red dashed lines

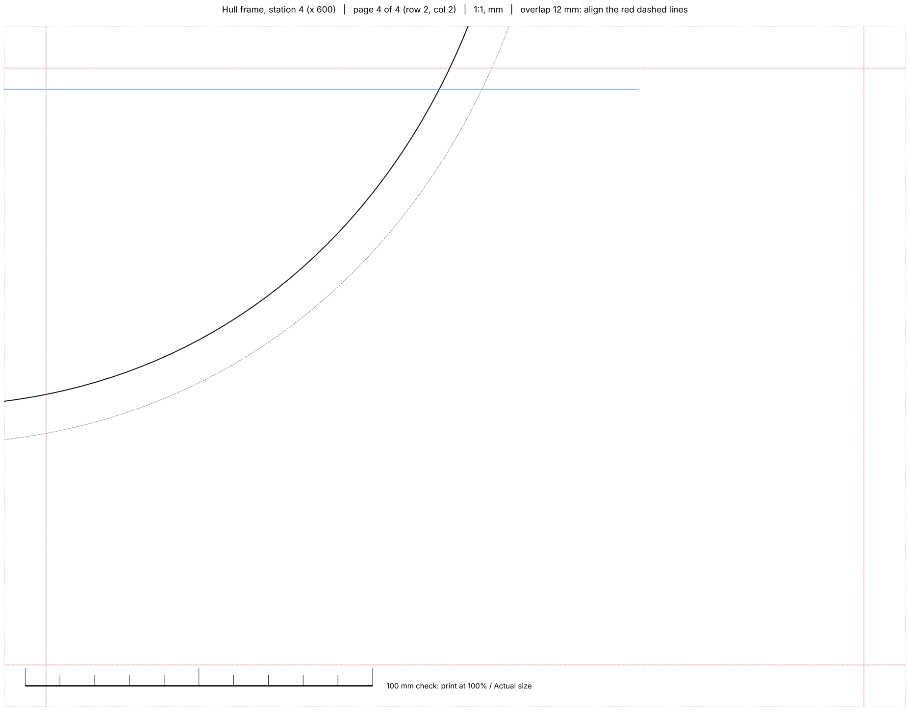
[picture p80: figure]

Hull frame, station 4 (x 600) | page 4 of 4 (row 2, col 2) | 1:1, mm | overlap 12 mm: align the red dashed lines

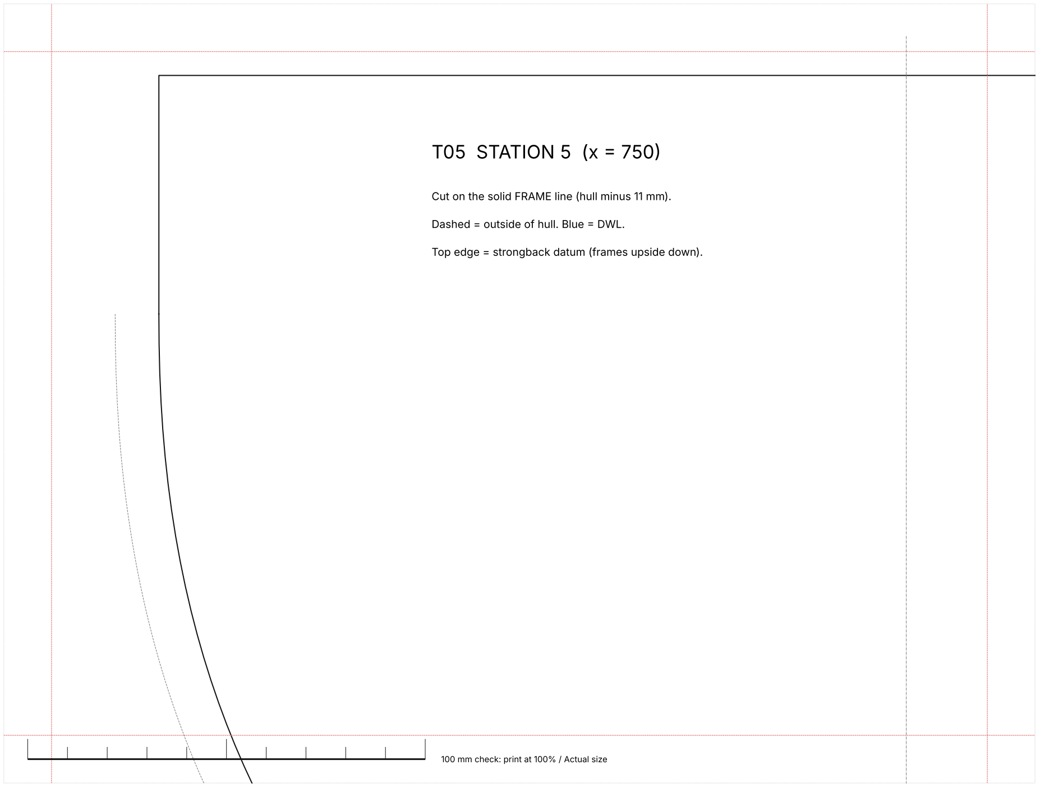
[picture p81: figure]
T05 STATION 5 (x = 750); Dashed = outside of hull. Blue = DWL.

Cut on the solid FRAME line (hull minus 11 mm).

Top edge = strongback datum (frames upside down).

Hull frame, station 5 (x 750) | page 1 of 4 (row 1, col 1) | 1:1, mm | overlap 12 mm: align the red dashed lines

Hull frame, station 5 (x 750) | page 2 of 4 (row 1, col 2) | 1:1, mm | overlap 12 mm: align the red dashed lines

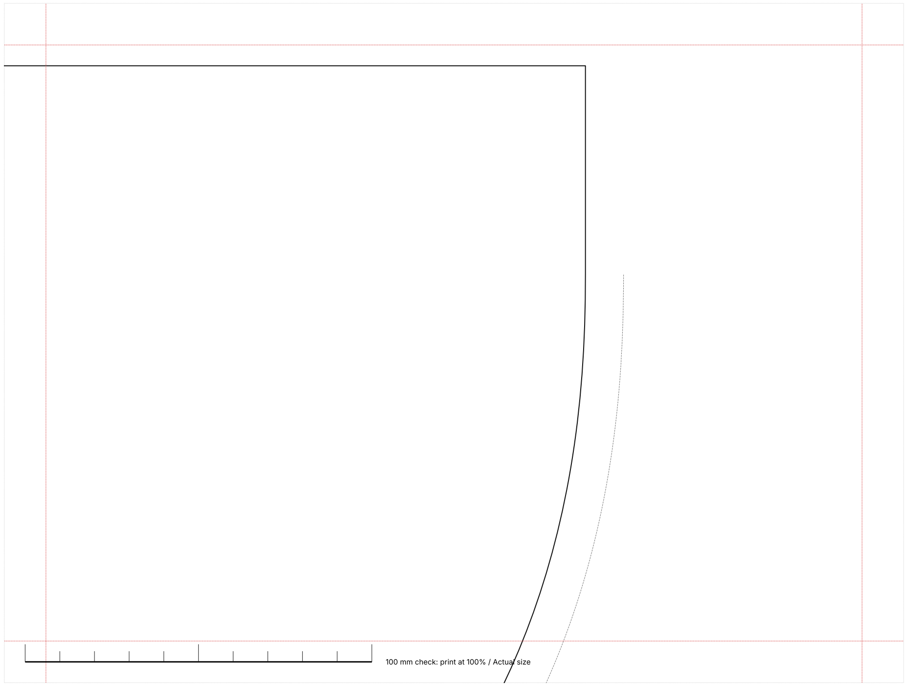
[picture p82: figure]

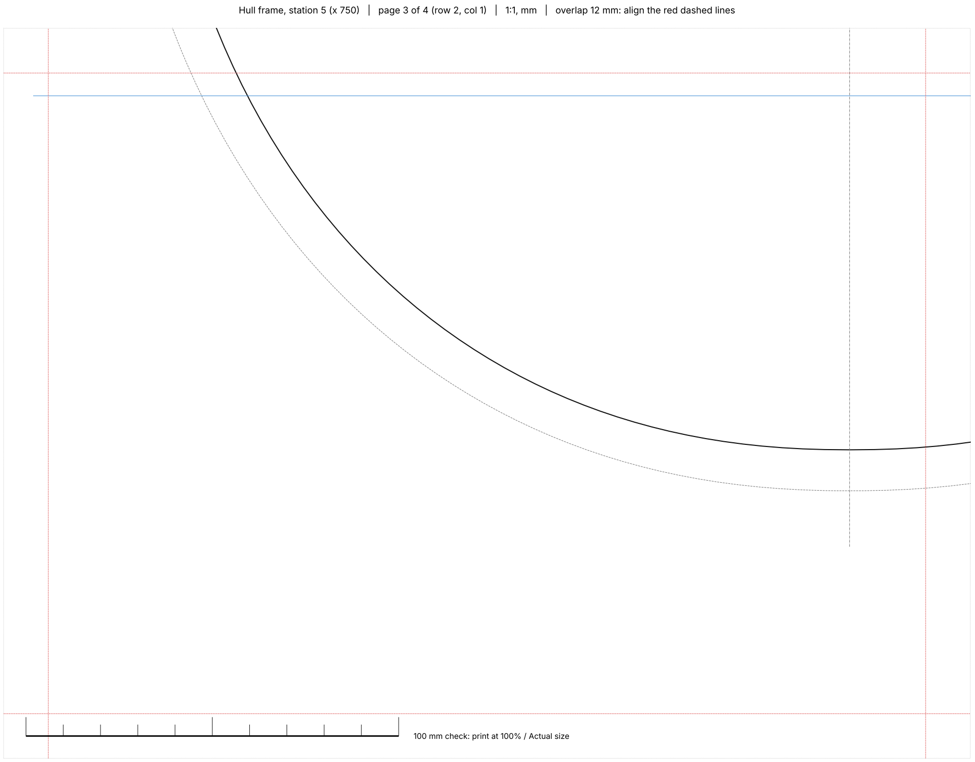
[picture p83: figure]

Hull frame, station 5 (x 750) | page 3 of 4 (row 2, col 1) | 1:1, mm | overlap 12 mm: align the red dashed lines

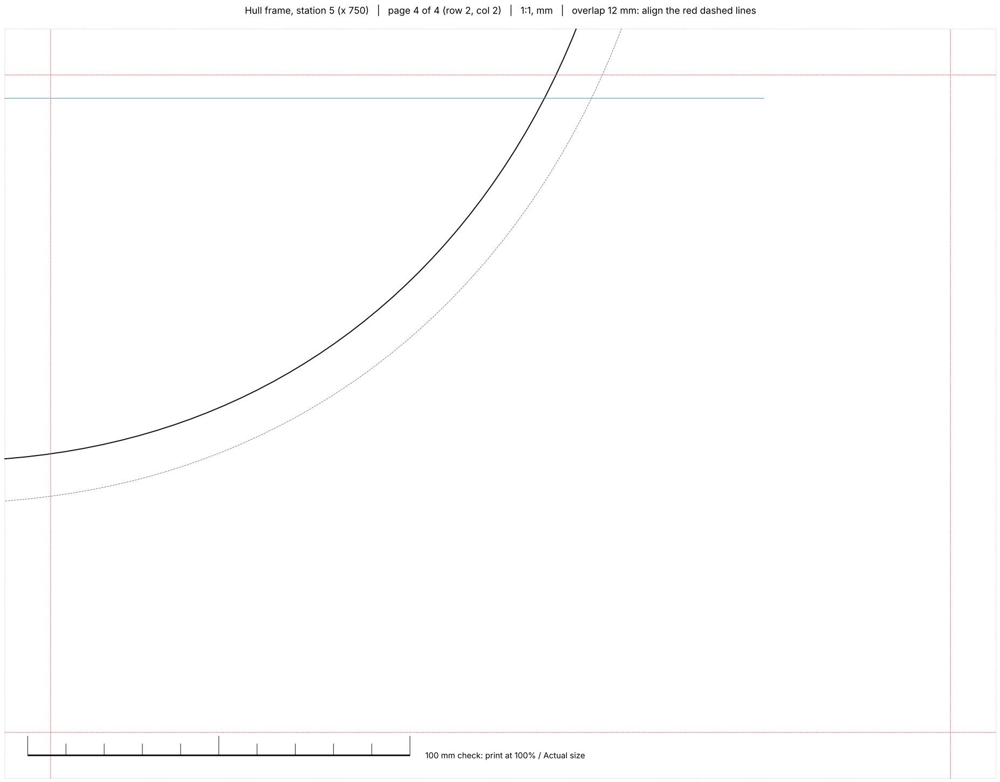
[picture p84: figure]

Hull frame, station 5 (x 750) | page 4 of 4 (row 2, col 2) | 1:1, mm | overlap 12 mm: align the red dashed lines

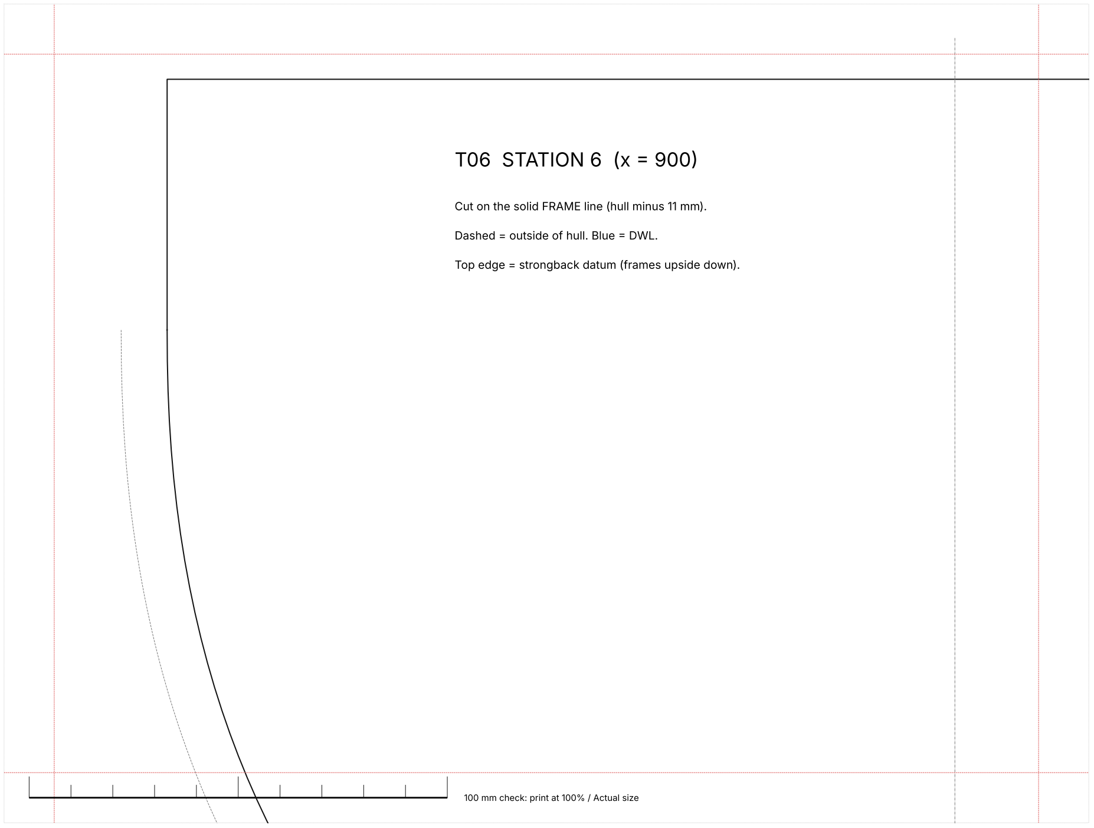
[picture p85: figure]
T06 STATION 6 (x = 900); Dashed = outside of hull. Blue = DWL.

Cut on the solid FRAME line (hull minus 11 mm).

Top edge = strongback datum (frames upside down).

Hull frame, station 6 (x 900) | page 1 of 4 (row 1, col 1) | 1:1, mm | overlap 12 mm: align the red dashed lines

Hull frame, station 6 (x 900) | page 2 of 4 (row 1, col 2) | 1:1, mm | overlap 12 mm: align the red dashed lines

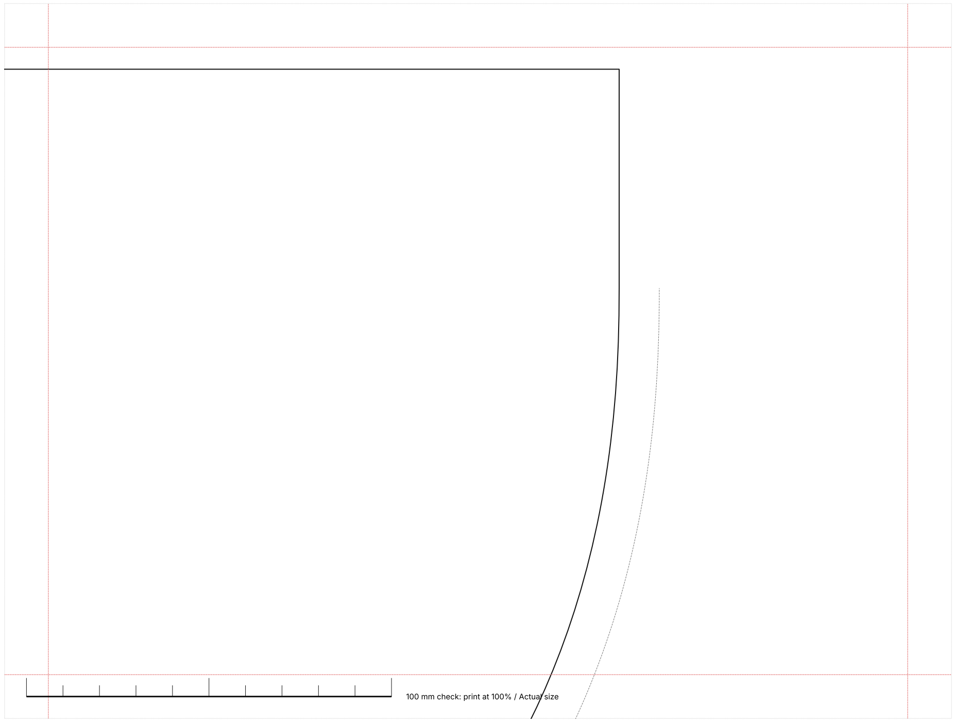
[picture p86: figure]

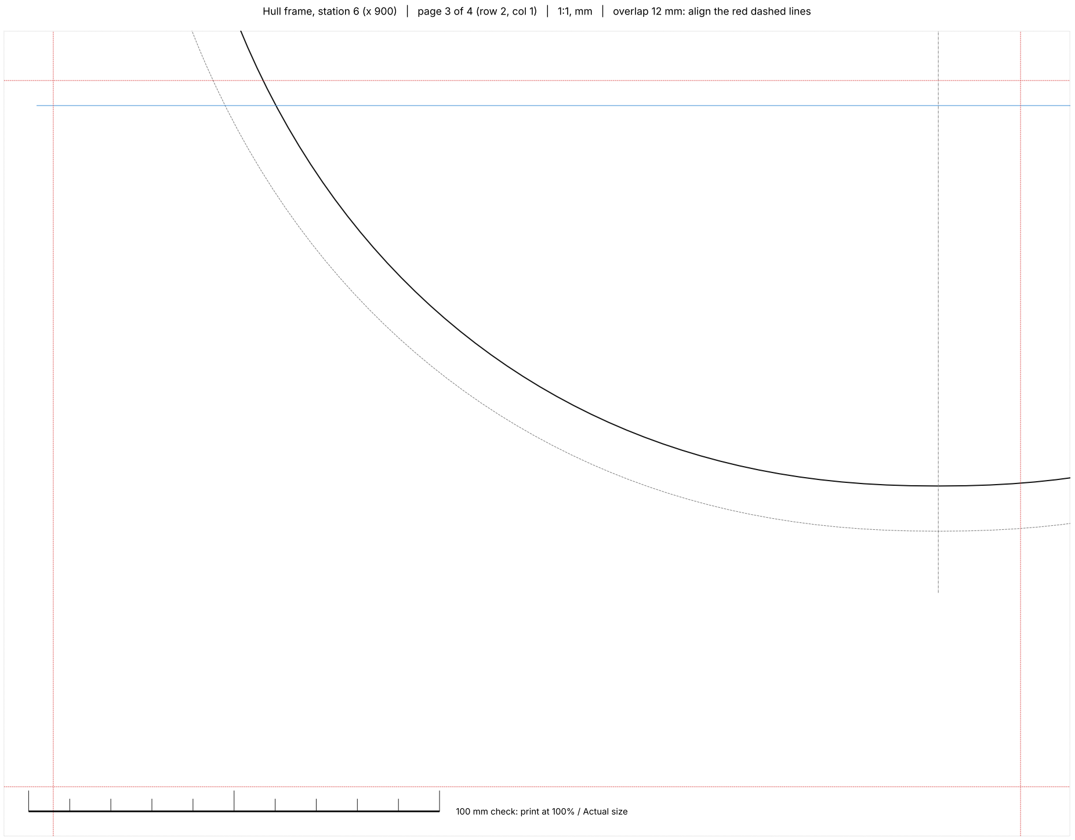
[picture p87: figure]

Hull frame, station 6 (x 900) | page 3 of 4 (row 2, col 1) | 1:1, mm | overlap 12 mm: align the red dashed lines

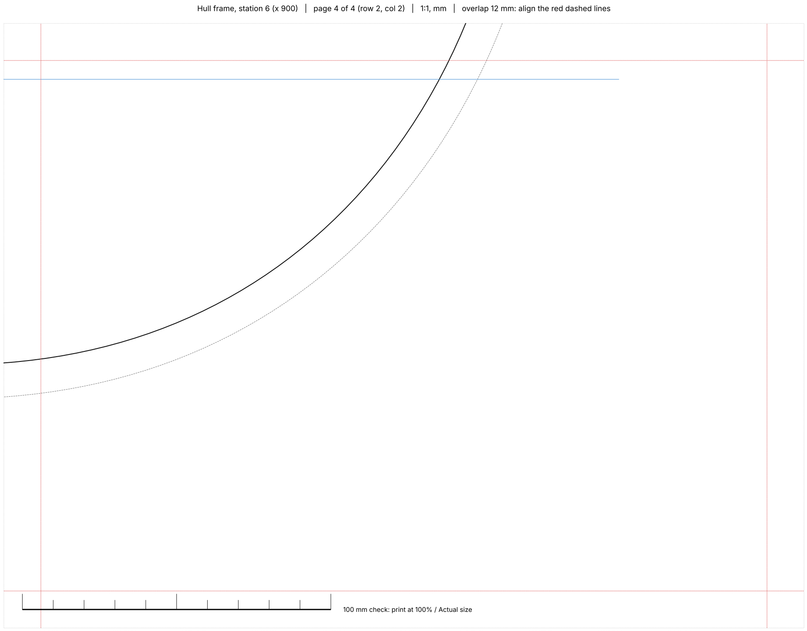
[picture p88: figure]

Hull frame, station 6 (x 900) | page 4 of 4 (row 2, col 2) | 1:1, mm | overlap 12 mm: align the red dashed lines

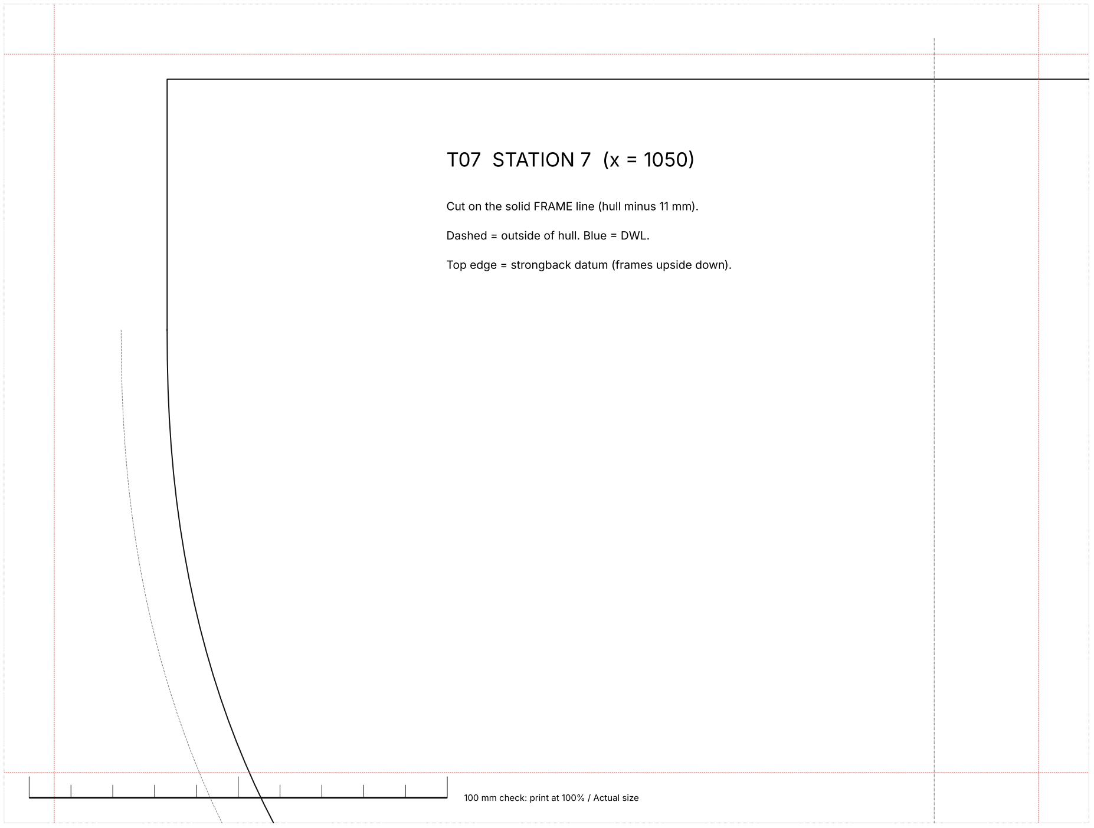
[picture p89: figure]
T07 STATION 7 (x = 1050); Dashed = outside of hull. Blue = DWL.

Cut on the solid FRAME line (hull minus 11 mm).

Top edge = strongback datum (frames upside down).

Hull frame, station 7 (x 1050) | page 1 of 4 (row 1, col 1) | 1:1, mm | overlap 12 mm: align the red dashed lines

Hull frame, station 7 (x 1050) | page 2 of 4 (row 1, col 2) | 1:1, mm | overlap 12 mm: align the red dashed lines

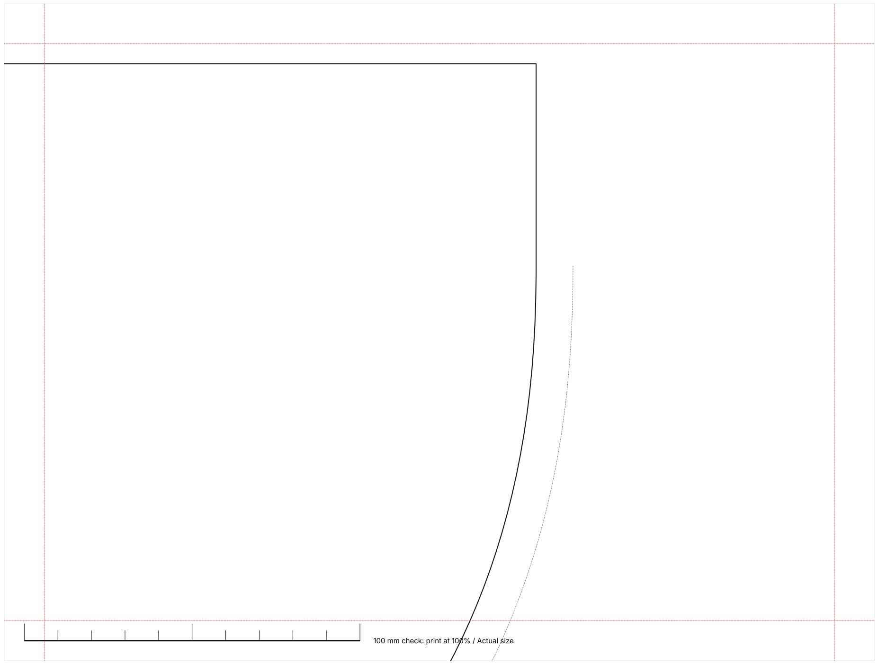
[picture p90: figure]

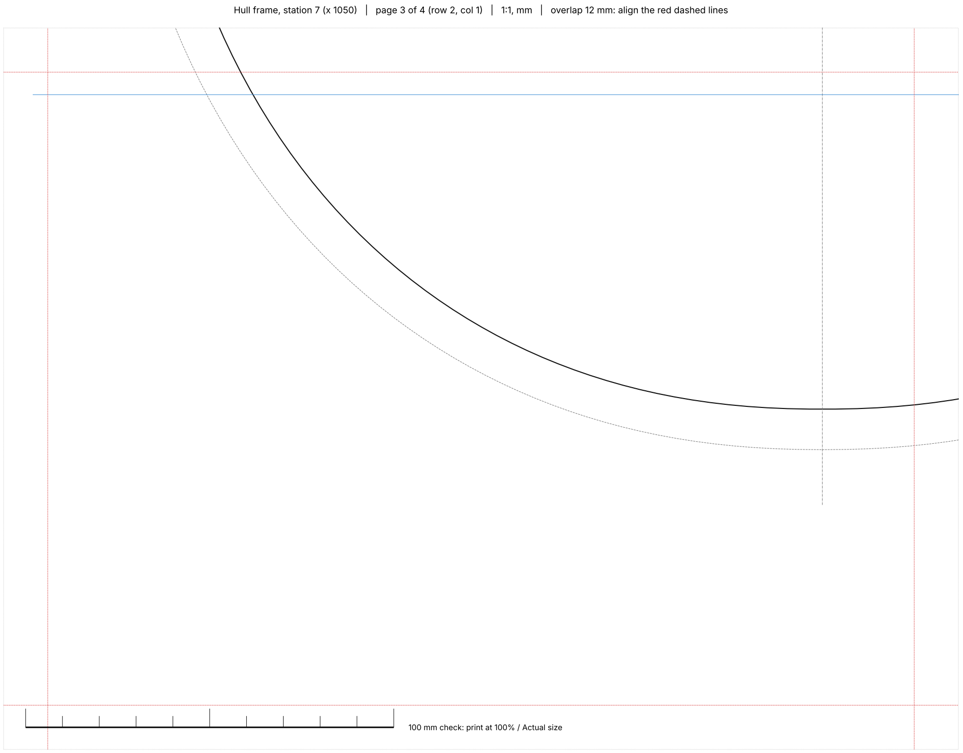
[picture p91: figure]

Hull frame, station 7 (x 1050) | page 3 of 4 (row 2, col 1) | 1:1, mm | overlap 12 mm: align the red dashed lines

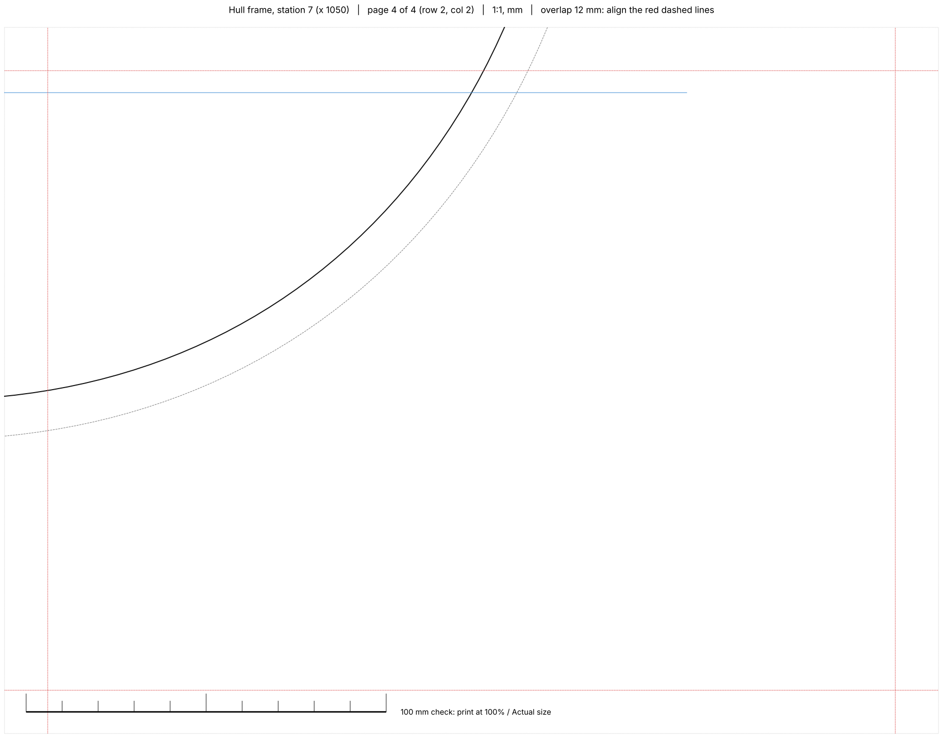
[picture p92: figure]

Hull frame, station 7 (x 1050) | page 4 of 4 (row 2, col 2) | 1:1, mm | overlap 12 mm: align the red dashed lines

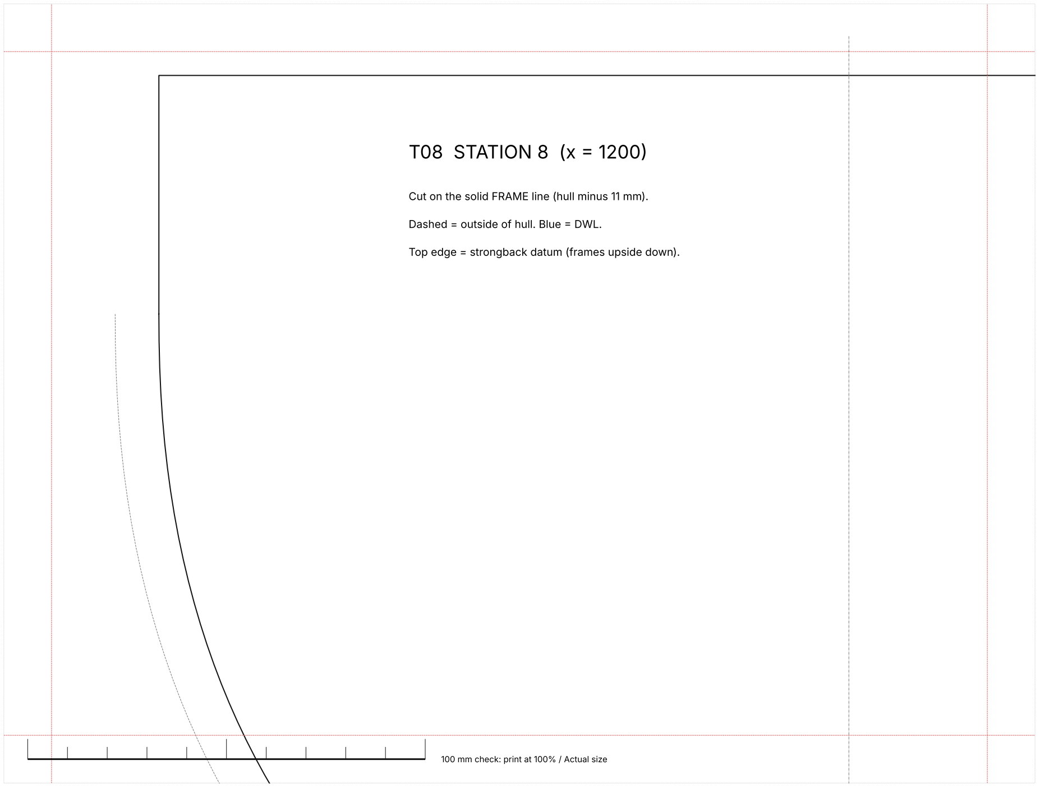
[picture p93: figure]
T08 STATION 8 (x = 1200); Dashed = outside of hull. Blue = DWL.

Cut on the solid FRAME line (hull minus 11 mm).

Top edge = strongback datum (frames upside down).

Hull frame, station 8 (x 1200) | page 1 of 4 (row 1, col 1) | 1:1, mm | overlap 12 mm: align the red dashed lines

Hull frame, station 8 (x 1200) | page 2 of 4 (row 1, col 2) | 1:1, mm | overlap 12 mm: align the red dashed lines

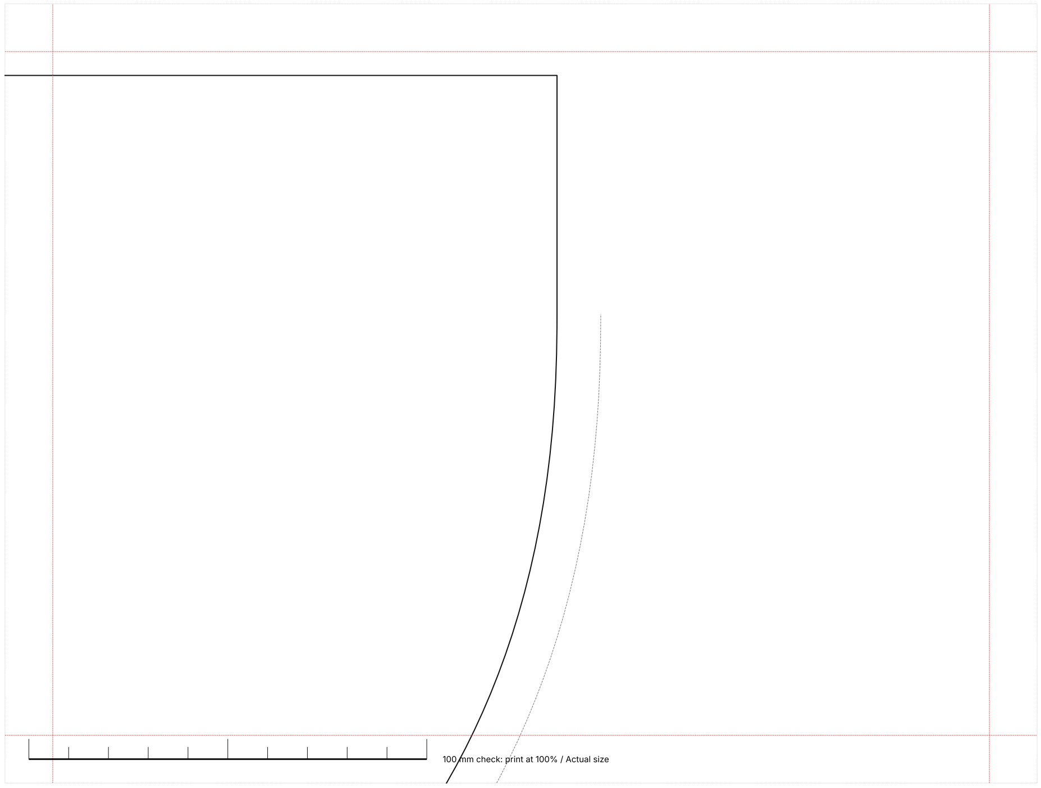
[picture p94: figure]

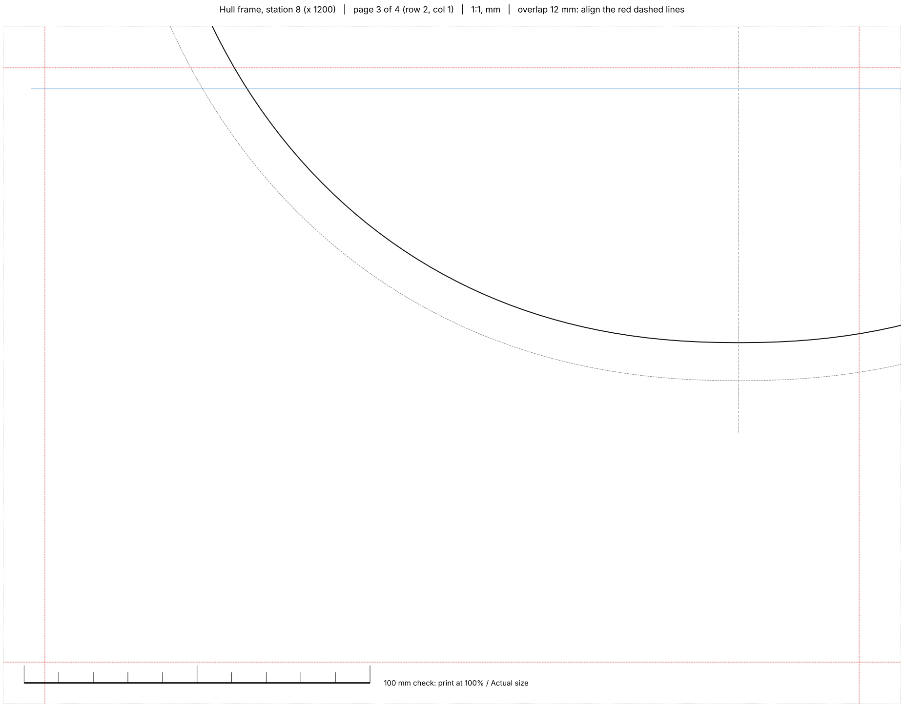
[picture p95: figure]

Hull frame, station 8 (x 1200) | page 3 of 4 (row 2, col 1) | 1:1, mm | overlap 12 mm: align the red dashed lines

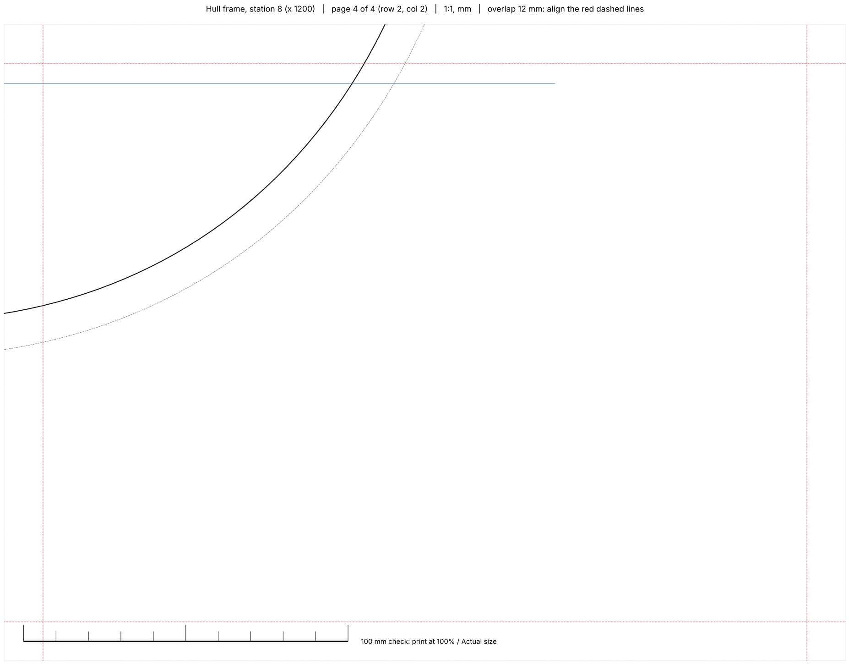
[picture p96: figure]

Hull frame, station 8 (x 1200) | page 4 of 4 (row 2, col 2) | 1:1, mm | overlap 12 mm: align the red dashed lines

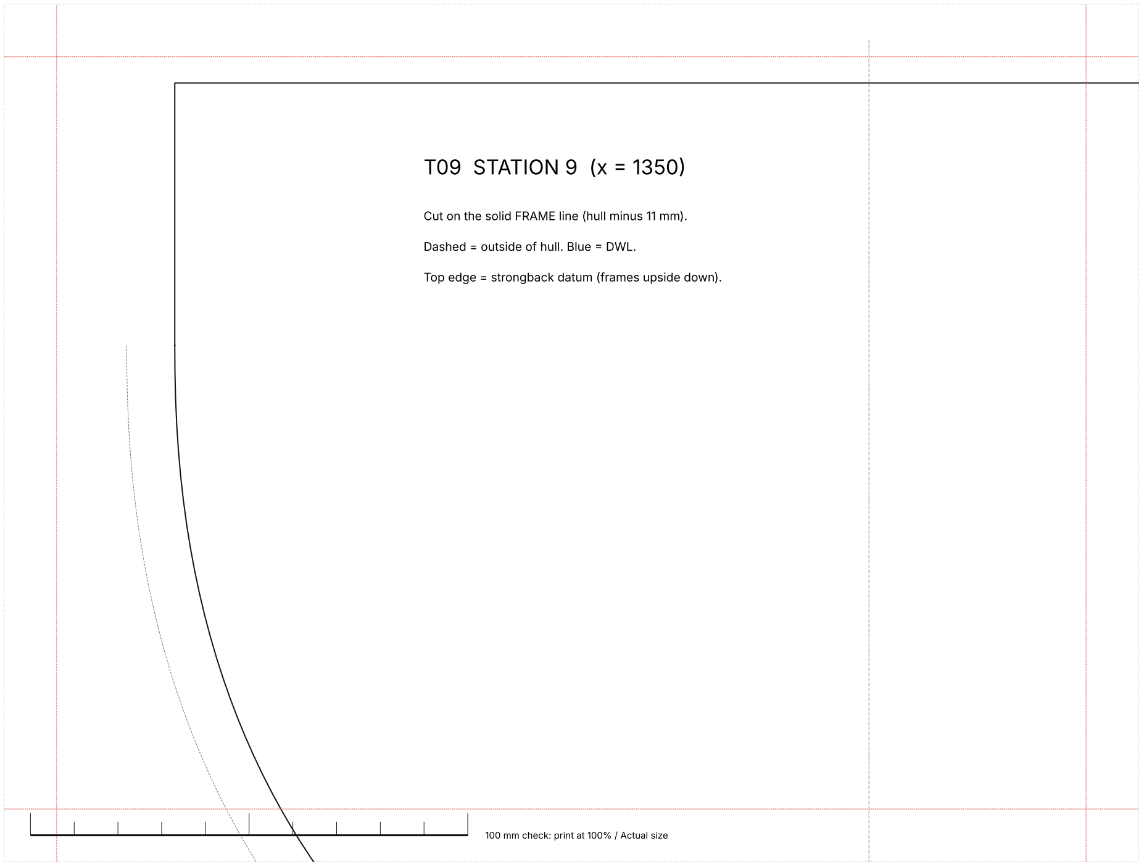
[picture p97: figure]
T09 STATION 9 (x = 1350); Dashed = outside of hull. Blue = DWL.

Cut on the solid FRAME line (hull minus 11 mm).

Top edge = strongback datum (frames upside down).

Hull frame, station 9 (x 1350) | page 1 of 4 (row 1, col 1) | 1:1, mm | overlap 12 mm: align the red dashed lines

Hull frame, station 9 (x 1350) | page 2 of 4 (row 1, col 2) | 1:1, mm | overlap 12 mm: align the red dashed lines

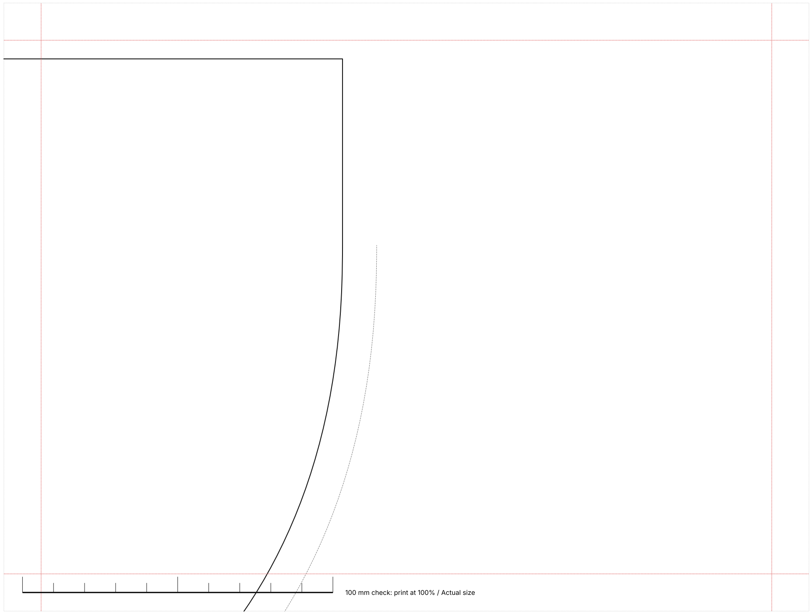
[picture p98: figure]

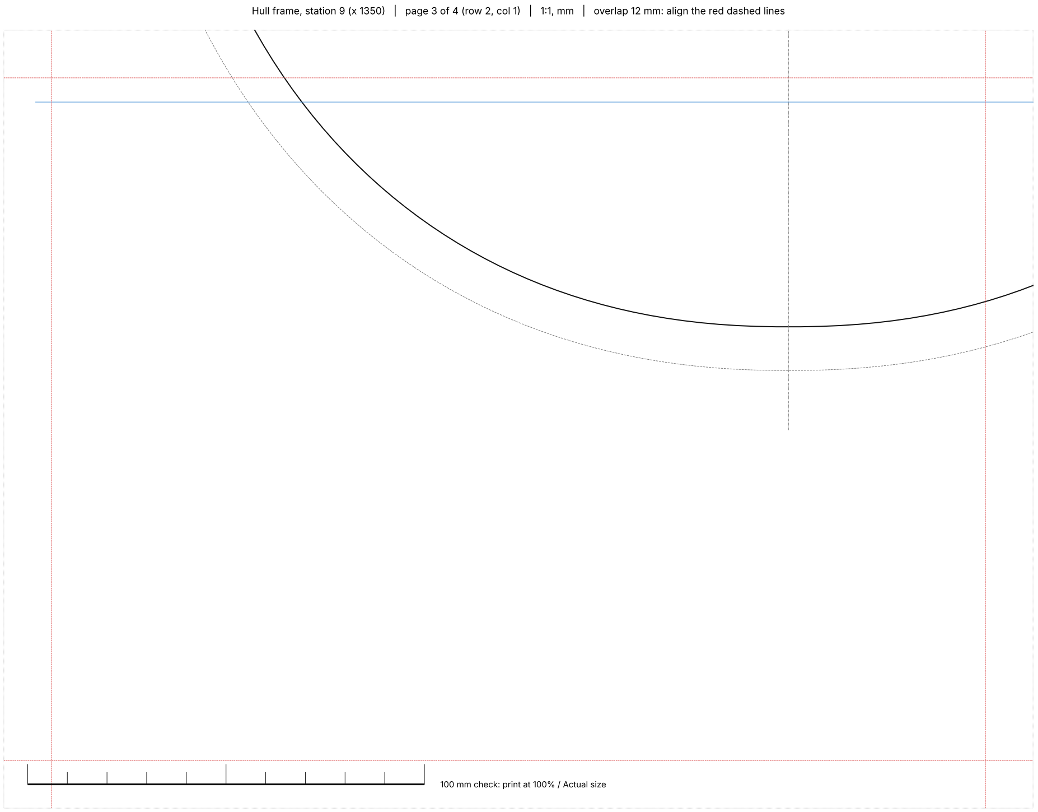
[picture p99: figure]

Hull frame, station 9 (x 1350) | page 3 of 4 (row 2, col 1) | 1:1, mm | overlap 12 mm: align the red dashed lines

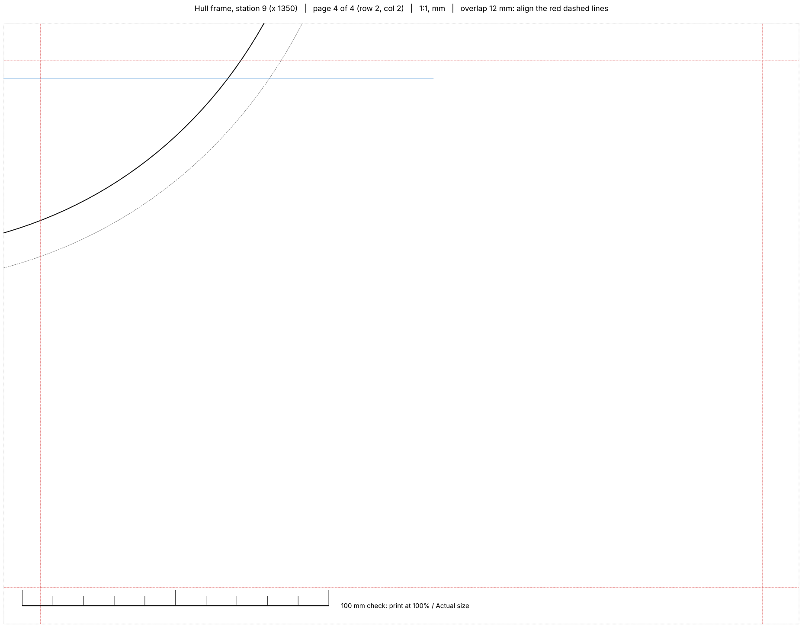
[picture p100: figure]

Hull frame, station 9 (x 1350) | page 4 of 4 (row 2, col 2) | 1:1, mm | overlap 12 mm: align the red dashed lines

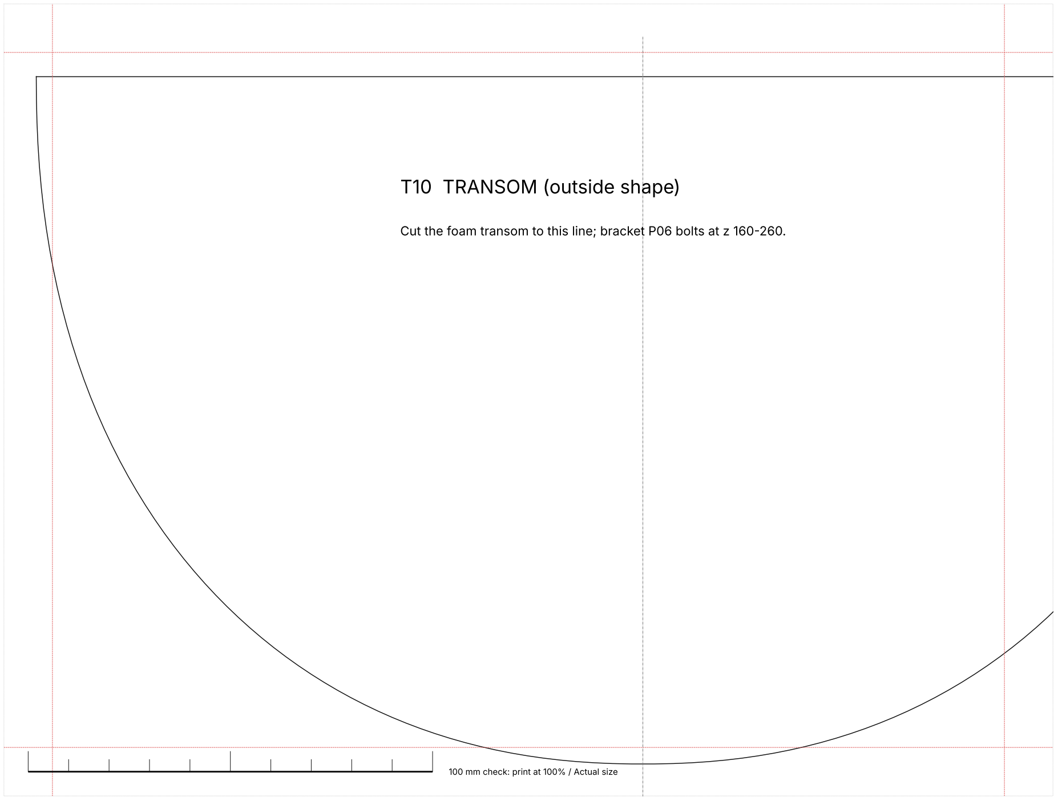
[picture p101: figure]
T10 TRANSOM (outside shape)

Cut the foam transom to this line; bracket P06 bolts at z 160-260.

Transom outline | page 1 of 4 (row 1, col 1) | 1:1, mm | overlap 12 mm: align the red dashed lines

Transom outline | page 2 of 4 (row 1, col 2) | 1:1, mm | overlap 12 mm: align the red dashed lines

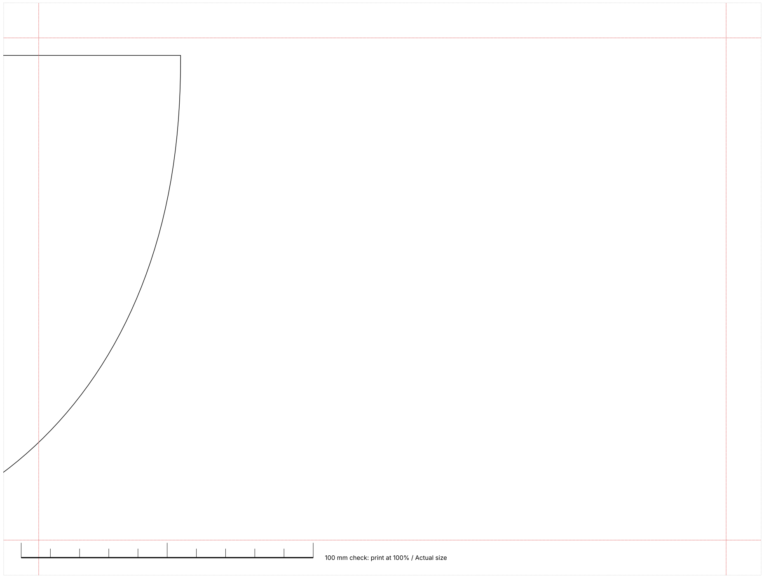
[picture p102: figure]

Transom outline | page 3 of 4 (row 2, col 1) | 1:1, mm | overlap 12 mm: align the red dashed lines

Transom outline | page 4 of 4 (row 2, col 2) | 1:1, mm | overlap 12 mm: align the red dashed lines

# T11 STEM PROFILE x 0-330

Cut a 12 mm ply stem piece; frames 1 and 2 notch into it.

Bow stem profile | page 1 of 4 (row 1, col 1) | 1:1, mm | overlap 12 mm: align the red dashed lines

Bow stem profile | page 2 of 4 (row 1, col 2) | 1:1, mm | overlap 12 mm: align the red dashed lines

Bow stem profile | page 3 of 4 (row 2, col 1) | 1:1, mm | overlap 12 mm: align the red dashed lines

Bow stem profile | page 4 of 4 (row 2, col 2) | 1:1, mm | overlap 12 mm: align the red dashed lines

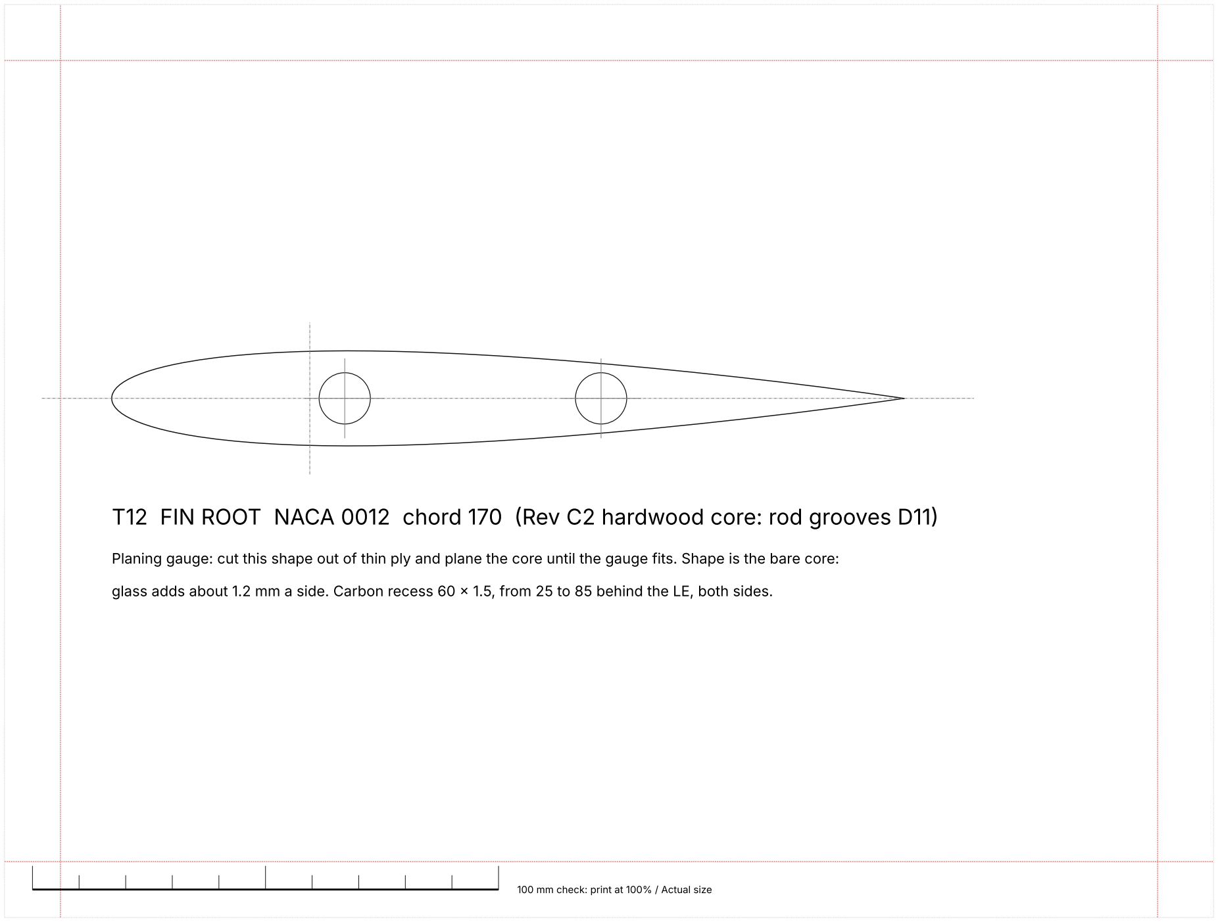
[picture p103: figure]

# T12 FIN ROOT NACA 0012 chord 170 (Rev C2 hardwood core: rod grooves D11)

Planing gauge: cut this shape out of thin ply and plane the core until the gauge fits. Shape is the bare core:

glass adds about 1.2 mm a side. Carbon recess 60 x 1.5, from 25 to 85 behind the LE, both sides.

T12 FIN ROOT NACA 0012 chord 170 (Rev C2 hardwood core: rod grooves D11) | page 1 of 2 (row 1, col 1) | 1:1, mm | overlap 12 mm: align the red dashed lines

T12 FIN ROOT NACA 0012 chord 170 (Rev C2 hardwood core: rod grooves D11) | page 2 of 2 (row 1, col 2) | 1:1, mm | overlap 12 mm: align the red dashed lines

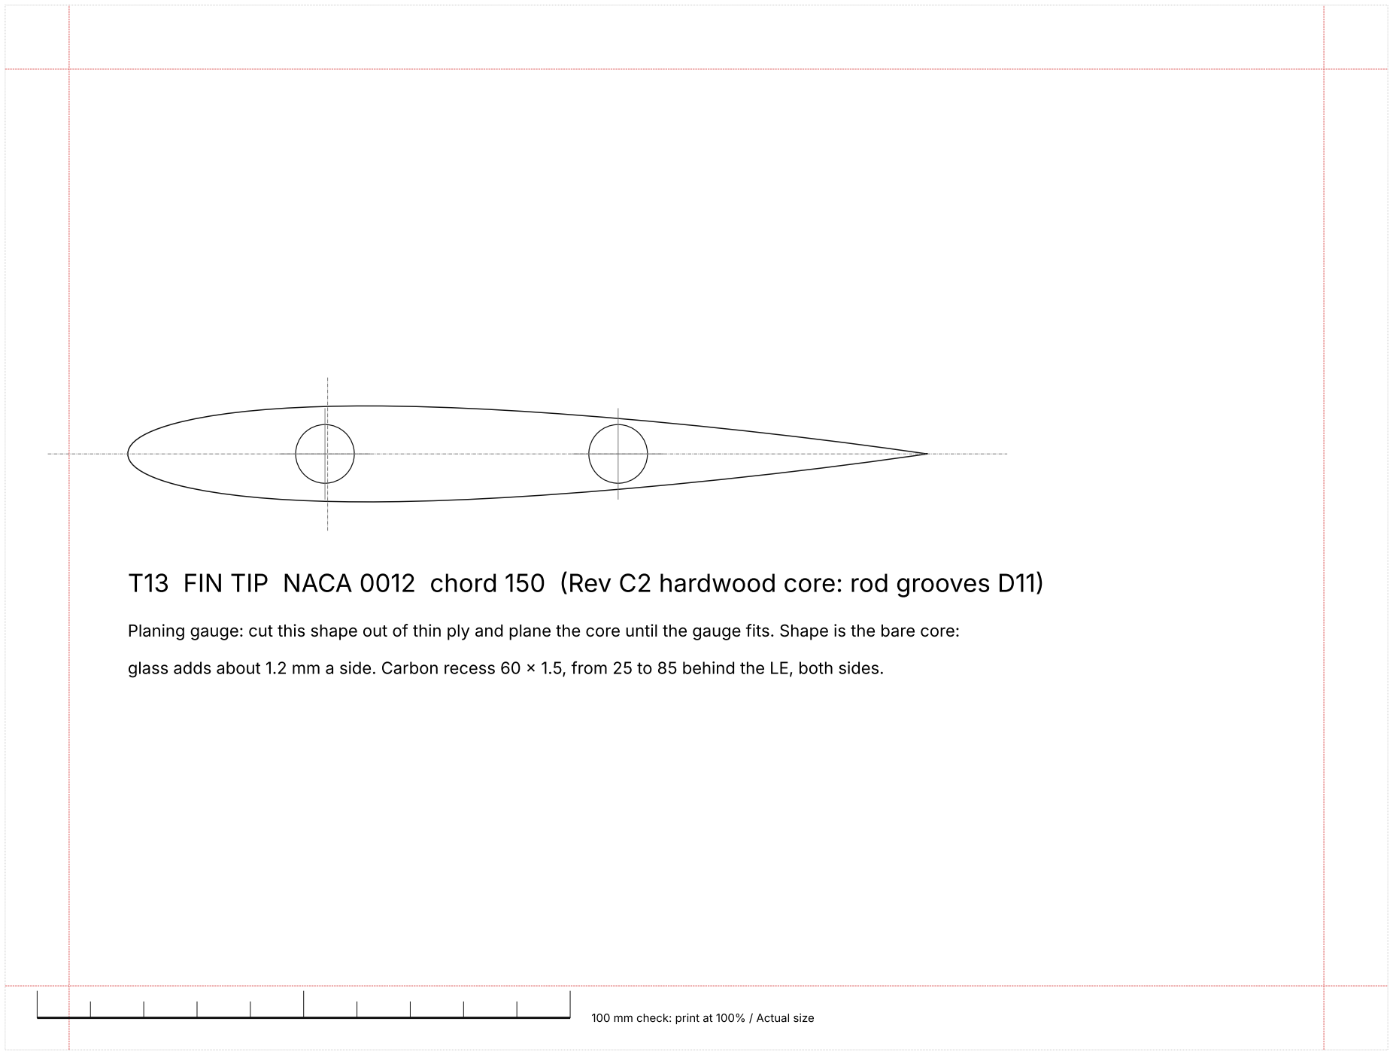
[picture p104: figure]

# T13 FIN TIP NACA 0012 chord 150 (Rev C2 hardwood core: rod grooves D11)

Planing gauge: cut this shape out of thin ply and plane the core until the gauge fits. Shape is the bare core:

glass adds about 1.2 mm a side. Carbon recess 60 x 1.5, from 25 to 85 behind the LE, both sides.

T13 FIN TIP NACA 0012 chord 150 (Rev C2 hardwood core: rod grooves D11) | page 1 of 2 (row 1, col 1) | 1:1, mm | overlap 12 mm: align the red dashed lines

T13 FIN TIP NACA 0012 chord 150 (Rev C2 hardwood core: rod grooves D11) | page 2 of 2 (row 1, col 2) | 1:1, mm | overlap 12 mm: align the red dashed lines

# T14 RUDDER NACA 0012 chord 120 (stock D12) MAKE 2

Hot-wire: screw template to the block end; lead in and out at the trailing edge.

T14 RUDDER NACA 0012 chord 120 (stock D12) MAKE 2 | page 1 of 1 (row 1, col 1) | 1:1, mm

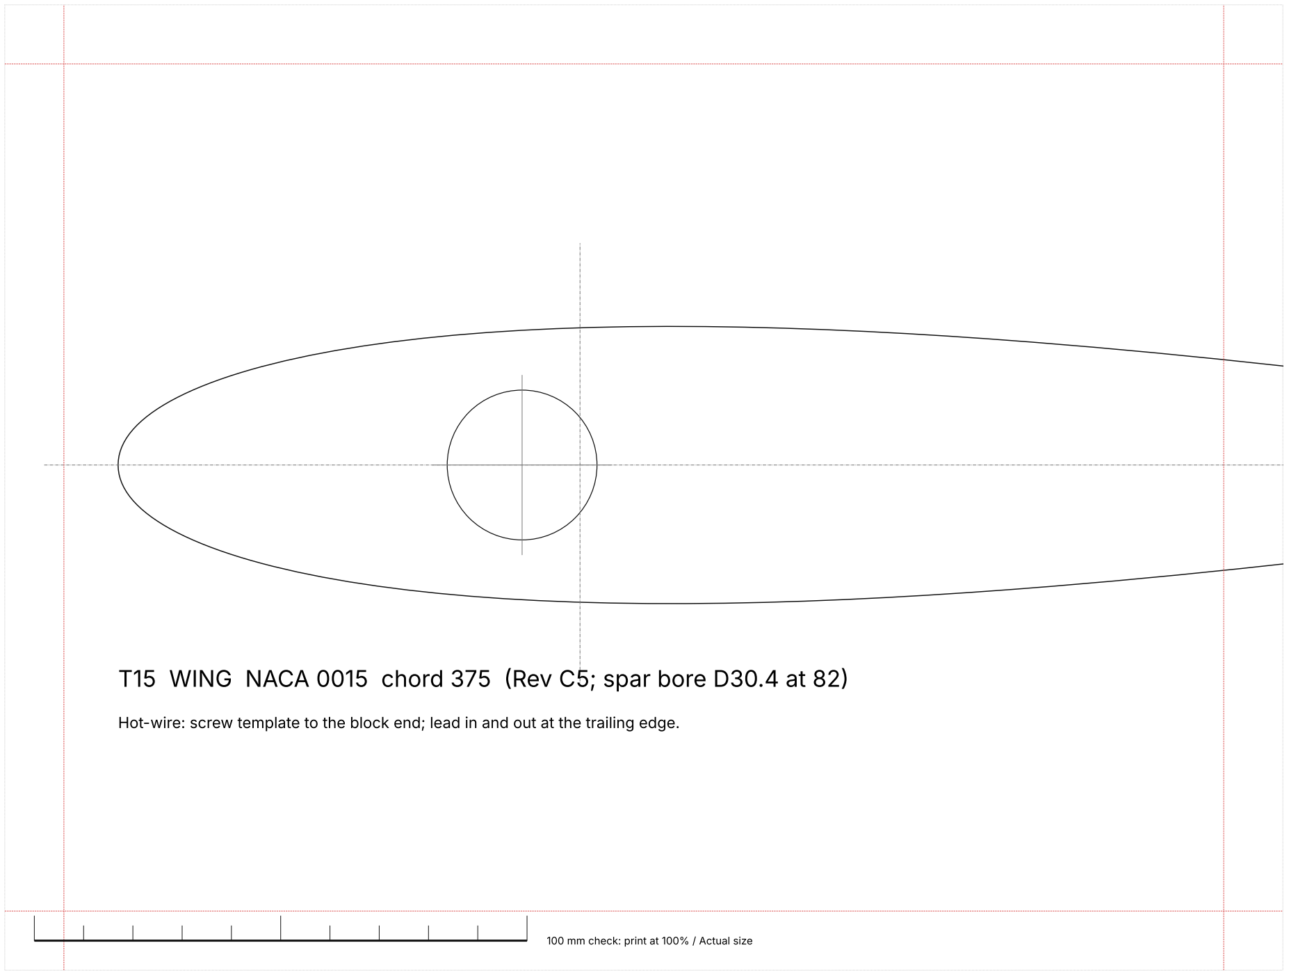
[picture p105: figure]

# T15 WING NACA 0015 chord 375 (Rev C5; spar bore D30.4 at 82)

Hot-wire: screw template to the block end; lead in and out at the trailing edge.

T15 WING NACA 0015 chord 375 (Rev C5; spar bore D30.4 at 82) | page 1 of 2 (row 1, col 1) | 1:1, mm | overlap 12 mm: align the red dashed lines

T15 WING NACA 0015 chord 375 (Rev C5; spar bore D30.4 at 82) | page 2 of 2 (row 1, col 2) | 1:1, mm | overlap 12 mm: align the red dashed lines

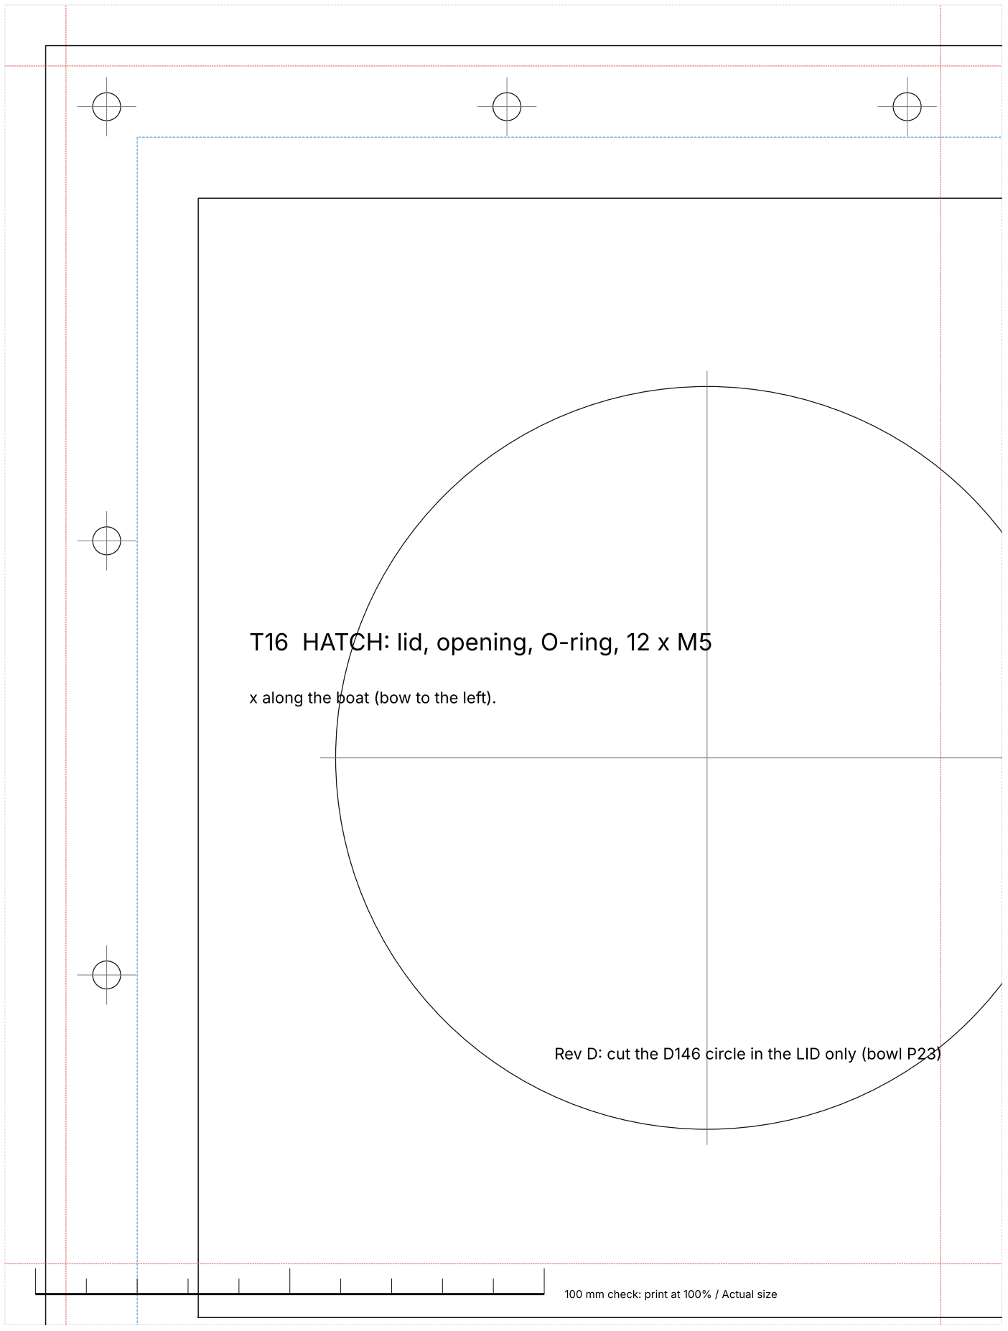
[picture p106: figure]
x along the boat (bow to the left).

# T16 HATCH: lid, opening, O-ring, 12 x M5

## Rev D: cut the D146 circle in the LID only (bowl P23)

Hatch lid, opening and bolt pattern | page 1 of 4 (row 1, col 1) | 1:1, mm | overlap 12 mm: align the red dashed lines

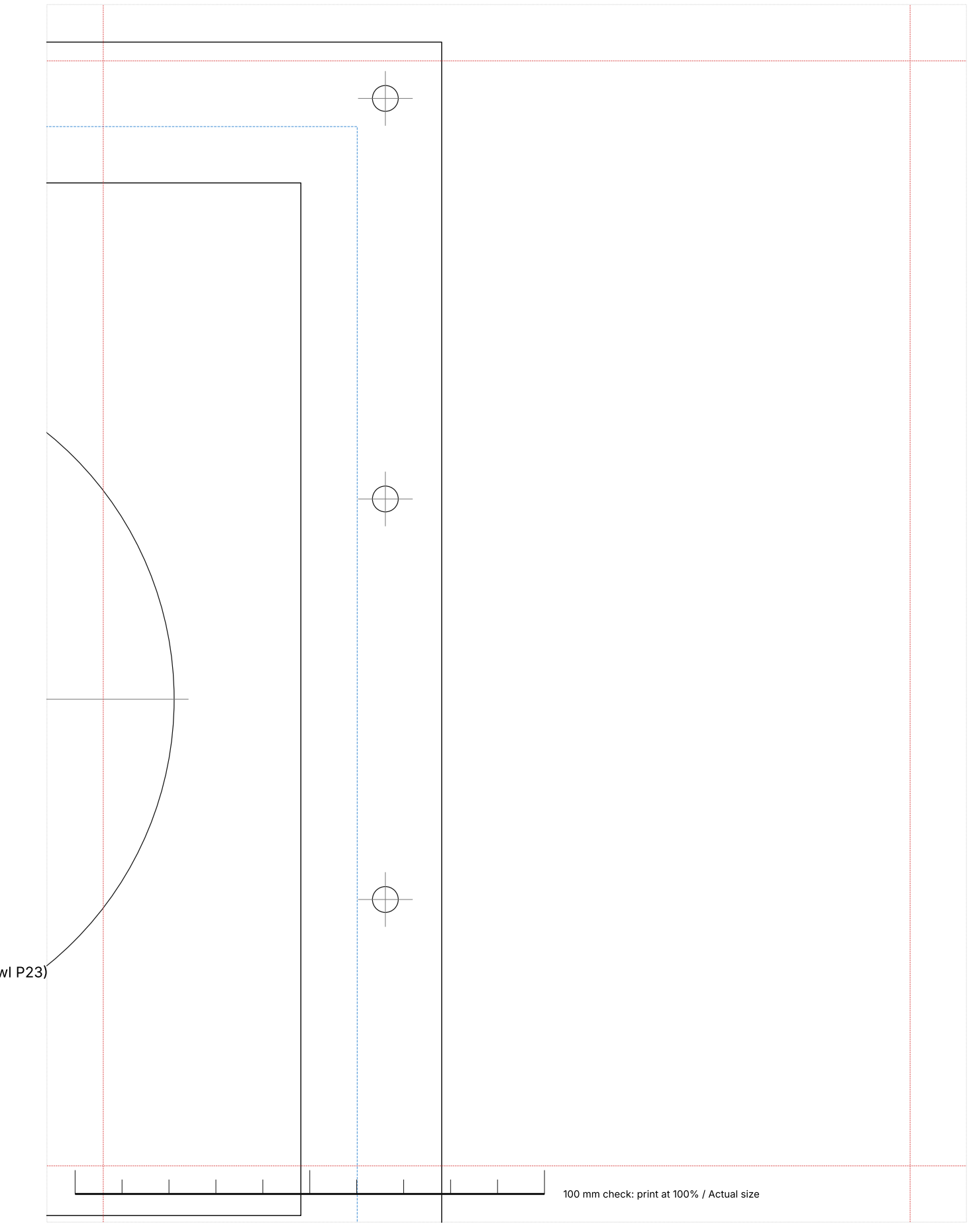
[picture p107: figure]

## Rev D: cut the D146 circle in the LID only (bowl P23)

Hatch lid, opening and bolt pattern | page 2 of 4 (row 1, col 2) | 1:1, mm | overlap 12 mm: align the red dashed lines

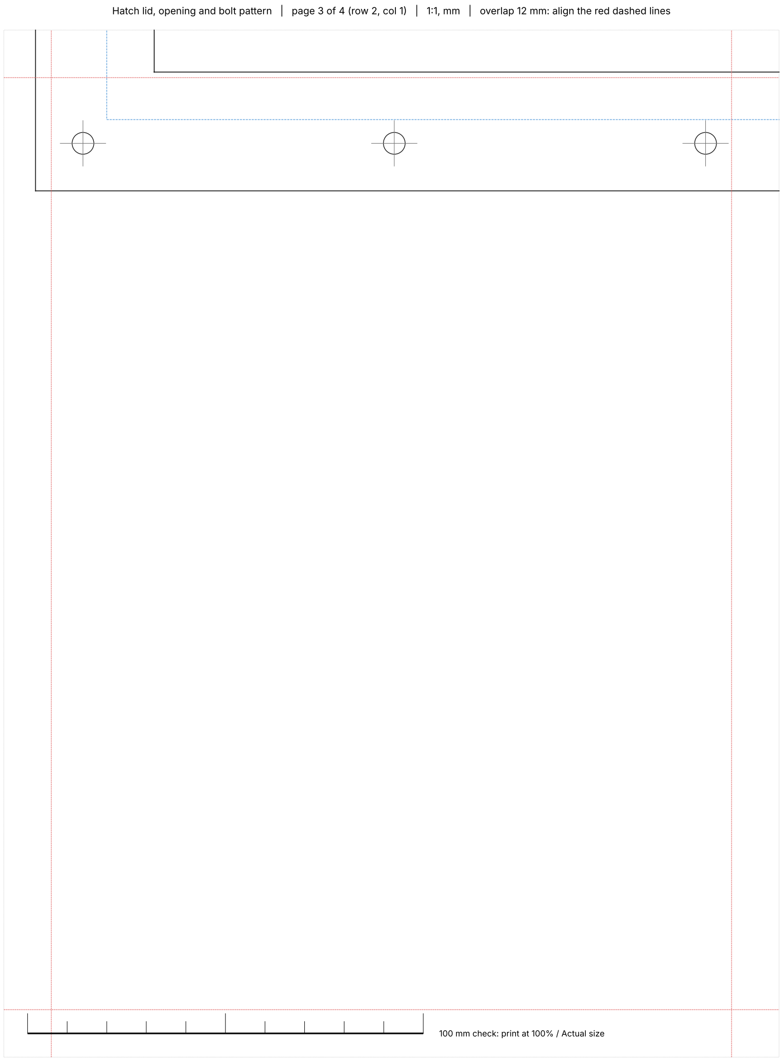
[picture p108: figure]

Hatch lid, opening and bolt pattern | page 3 of 4 (row 2, col 1) | 1:1, mm | overlap 12 mm: align the red dashed lines

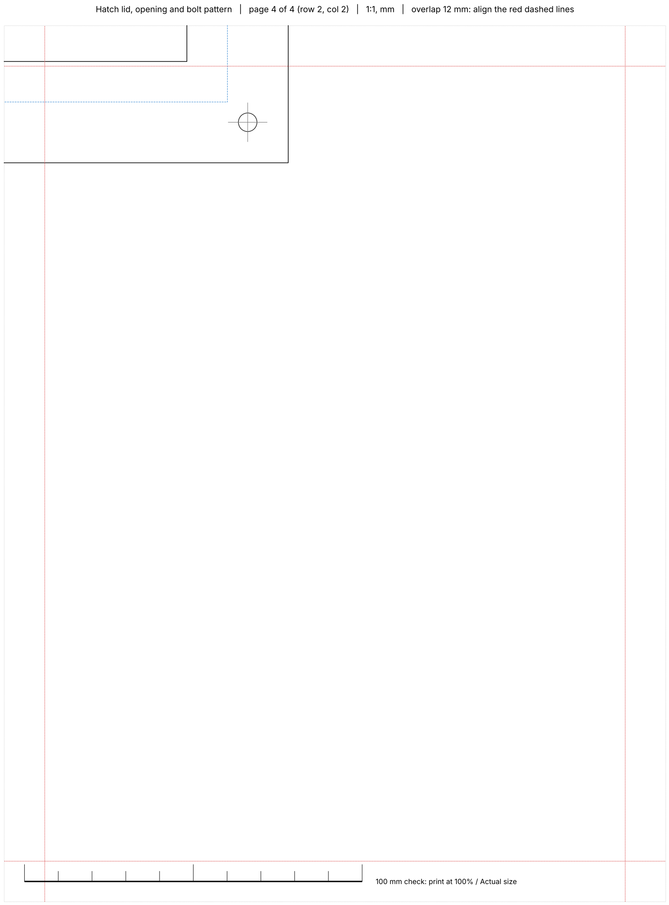
[picture p109: figure]

Hatch lid, opening and bolt pattern | page 4 of 4 (row 2, col 2) | 1:1, mm | overlap 12 mm: align the red dashed lines

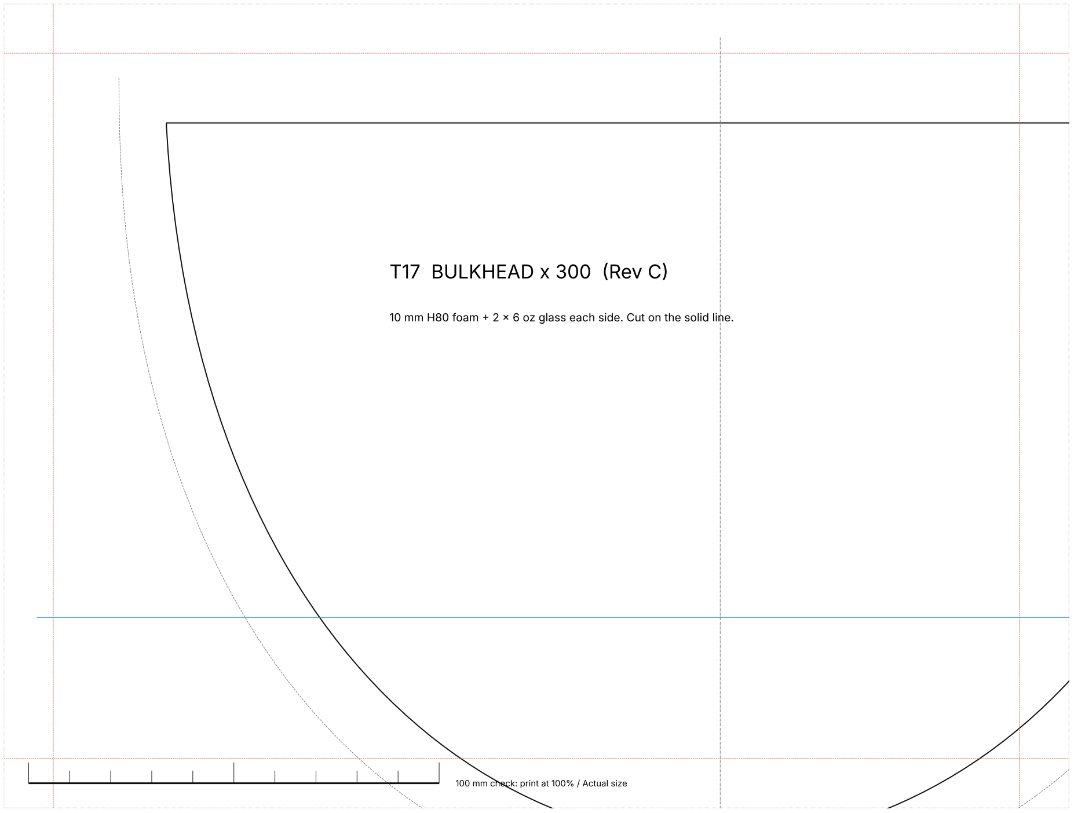
[picture p110: figure]
T17 BULKHEAD x 300 (Rev C)

10 mm H80 foam + 2 x 6 oz glass each side. Cut on the solid line.

Watertight bulkhead at x 300 | page 1 of 4 (row 1, col 1) | 1:1, mm | overlap 12 mm: align the red dashed lines

Watertight bulkhead at x 300 | page 2 of 4 (row 1, col 2) | 1:1, mm | overlap 12 mm: align the red dashed lines

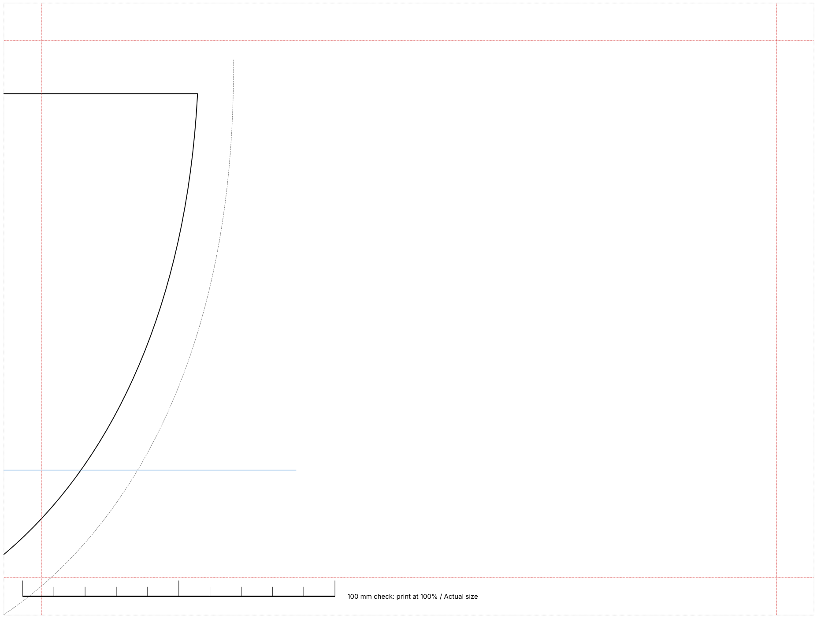
[picture p111: figure]

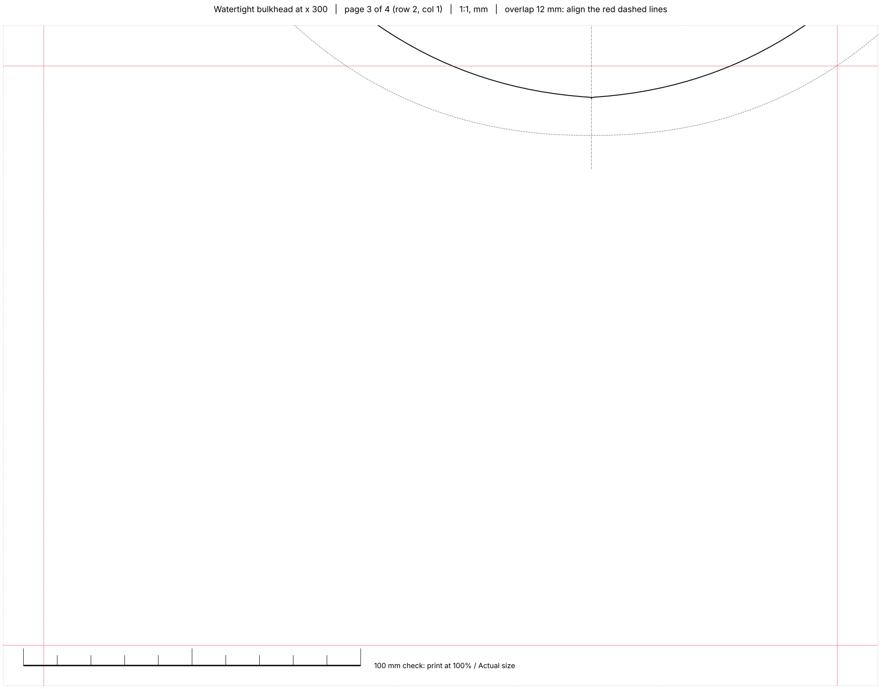
[picture p112: figure]

Watertight bulkhead at x 300 | page 3 of 4 (row 2, col 1) | 1:1, mm | overlap 12 mm: align the red dashed lines

Watertight bulkhead at x 300 | page 4 of 4 (row 2, col 2) | 1:1, mm | overlap 12 mm: align the red dashed lines

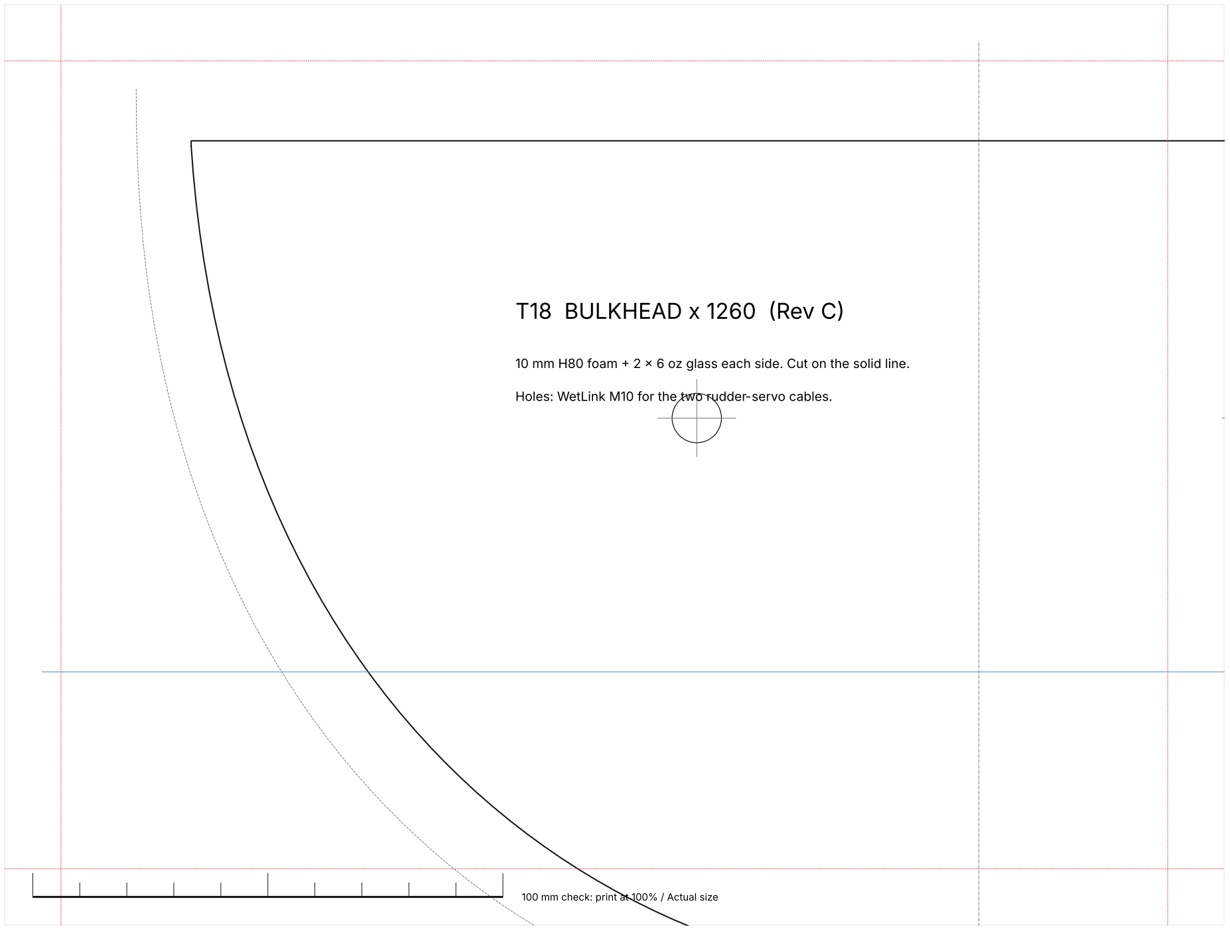
[picture p113: figure]
T18 BULKHEAD x 1260 (Rev C)

10 mm H80 foam + 2 x 6 oz glass each side. Cut on the solid line.

Holes: WetLink M10 for the two rudder-servo cables.

Watertight bulkhead at x 1260 | page 1 of 4 (row 1, col 1) | 1:1, mm | overlap 12 mm: align the red dashed lines

Watertight bulkhead at x 1260 | page 2 of 4 (row 1, col 2) | 1:1, mm | overlap 12 mm: align the red dashed lines

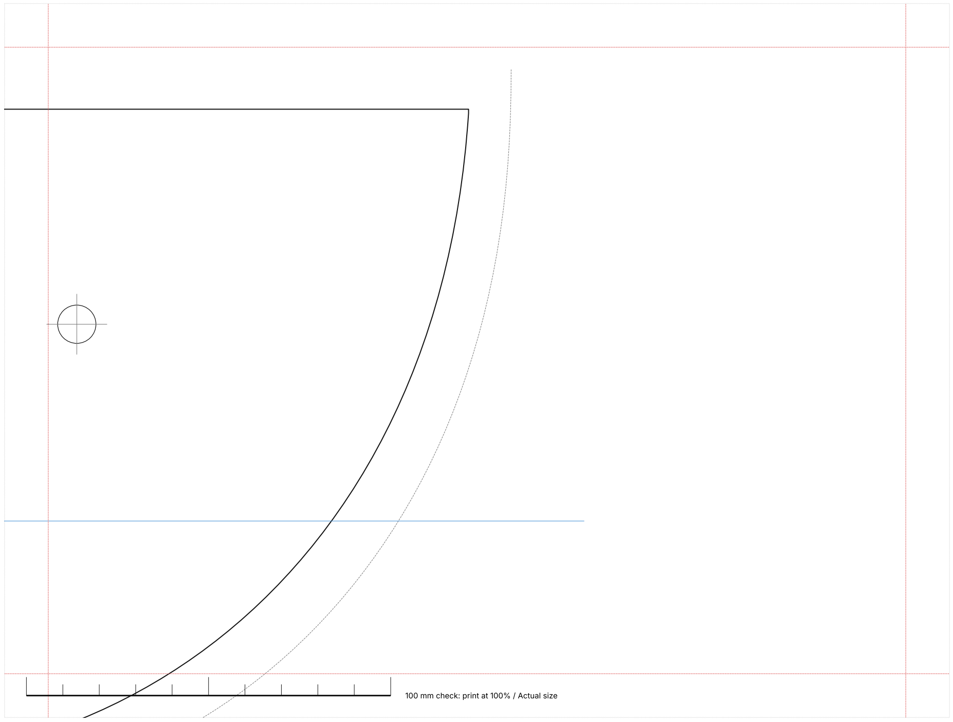
[picture p114: figure]

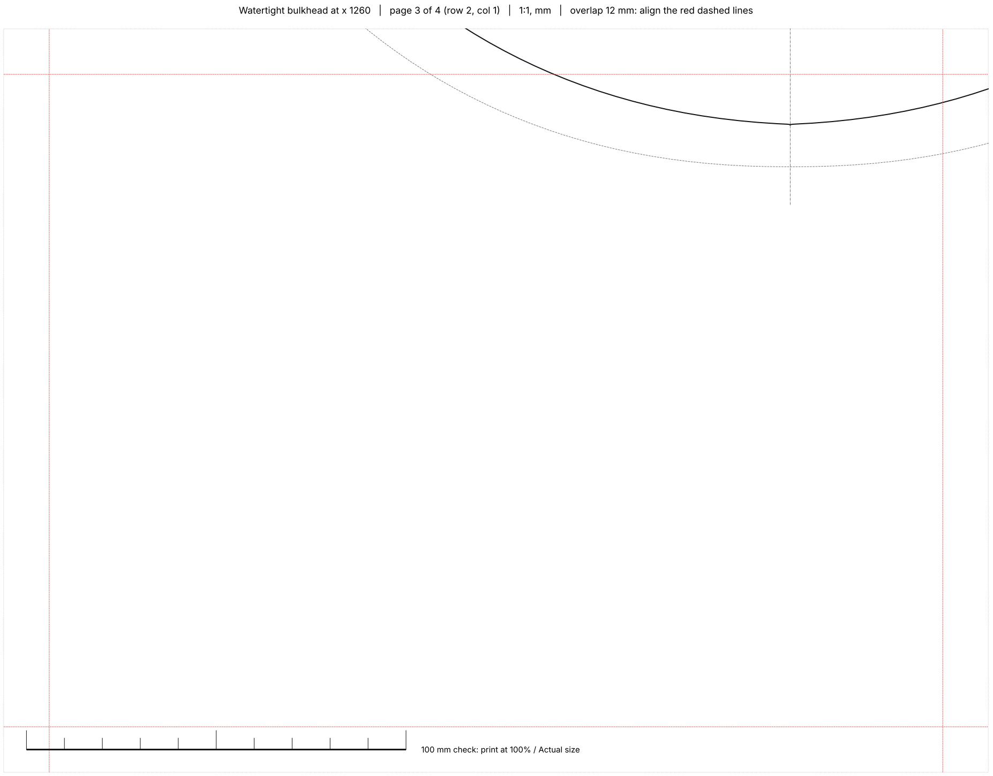
[picture p115: figure]

Watertight bulkhead at x 1260 | page 3 of 4 (row 2, col 1) | 1:1, mm | overlap 12 mm: align the red dashed lines

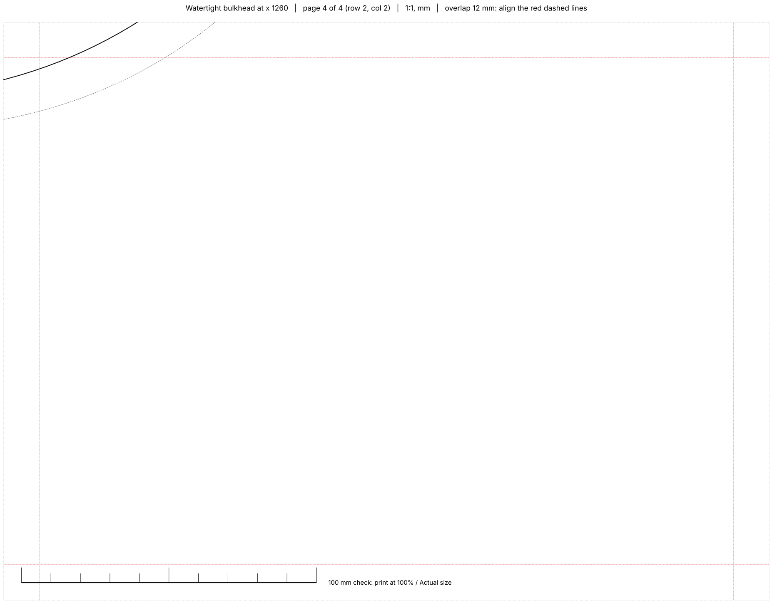
[picture p116: figure]

Watertight bulkhead at x 1260 | page 4 of 4 (row 2, col 2) | 1:1, mm | overlap 12 mm: align the red dashed lines

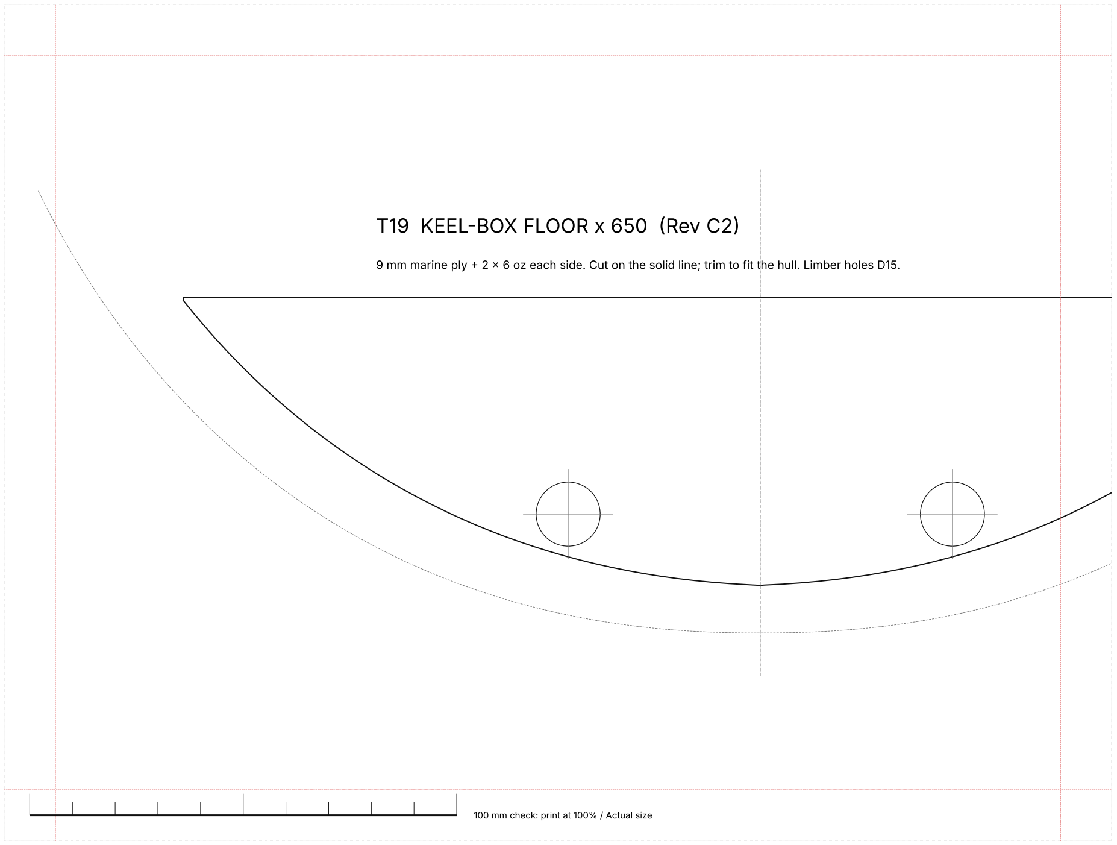
[picture p117: figure]
T19 KEEL-BOX FLOOR x 650 (Rev C2)

9 mm marine ply + 2 x 6 oz each side. Cut on the solid line; trim to fit the hull. Limber holes D15.

Keel-box floor at x 650 | page 1 of 2 (row 1, col 1) | 1:1, mm | overlap 12 mm: align the red dashed lines

Keel-box floor at x 650 | page 2 of 2 (row 1, col 2) | 1:1, mm | overlap 12 mm: align the red dashed lines

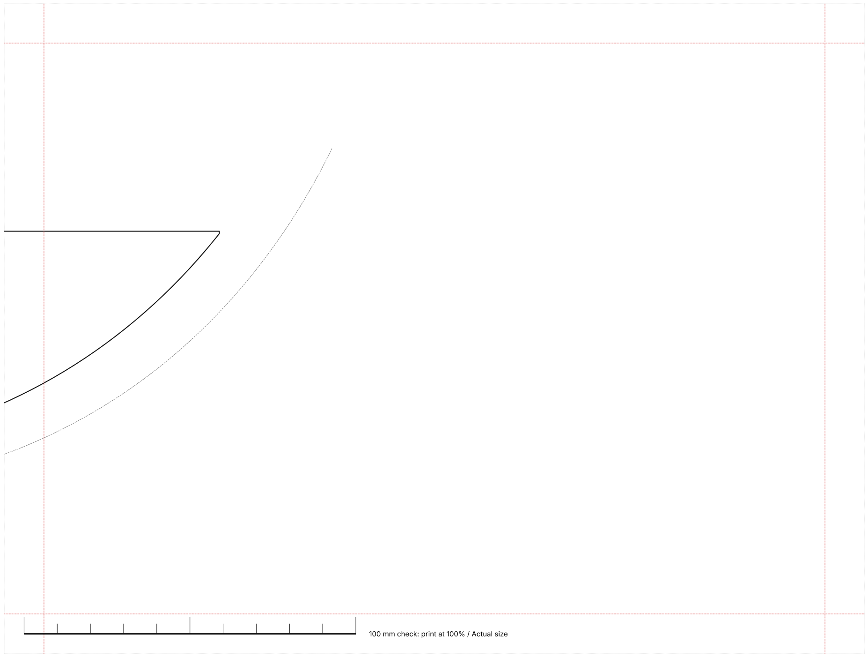
[picture p118: figure]

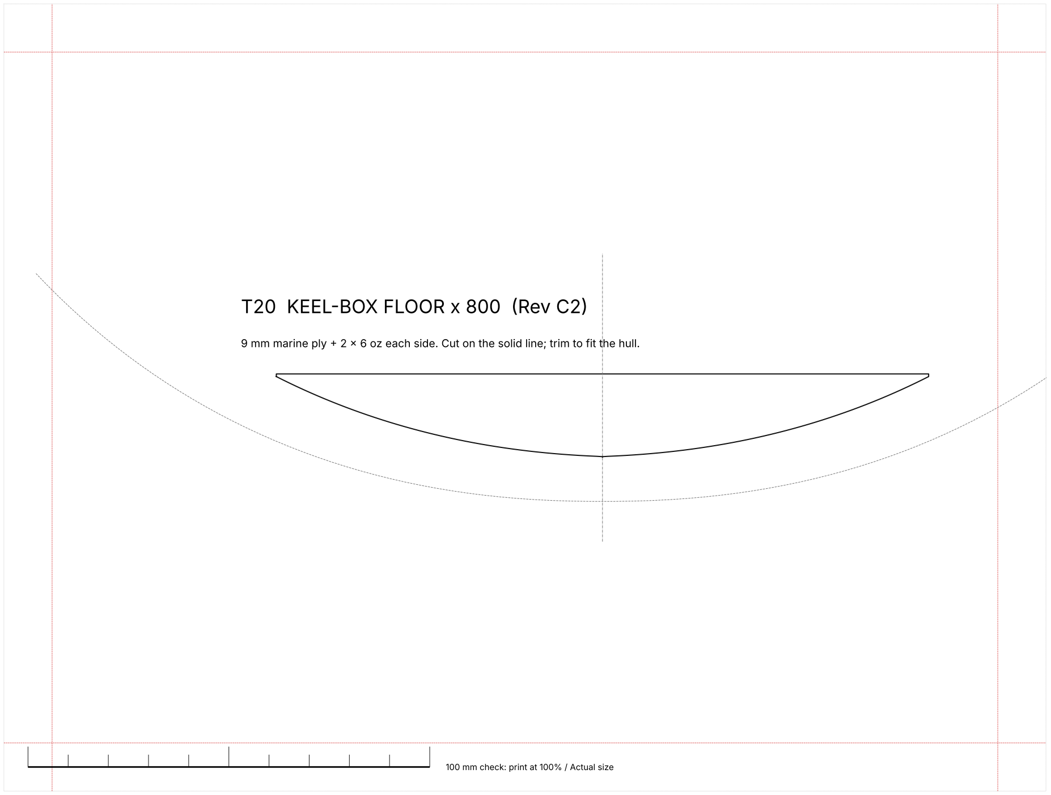
[picture p119: figure]
T20 KEEL-BOX FLOOR x 800 (Rev C2)

9 mm marine ply + 2 x 6 oz each side. Cut on the solid line; trim to fit the hull.

Keel-box floor at x 800 | page 1 of 2 (row 1, col 1) | 1:1, mm | overlap 12 mm: align the red dashed lines

Keel-box floor at x 800 | page 2 of 2 (row 1, col 2) | 1:1, mm | overlap 12 mm: align the red dashed lines

# T21 WEED FAIRING side profile (Rev E)

XPS, 22 wide at the fin, tapered to 8 at the nose. Fit to the real fin and bulb; 2 x 6 oz over.

Weed fairing, fin to bulb nose (Rev E) | page 1 of 2 (row 1, col 1) | 1:1, mm | overlap 12 mm: align the red dashed lines

Weed fairing, fin to bulb nose (Rev E) | page 2 of 2 (row 1, col 2) | 1:1, mm | overlap 12 mm: align the red dashed lines
