sheltonr2/drone-boat/(commit log)

2026-11-08 Initial commit: build plan, drawings, 3D-print files, simulator and results viewer
    Claude-Session: https://claude.ai/code/session_0114ZepeqeW8kwMkAtbPHQwS
    [P01_vane_housing.stl, P02_vane_arm.stl, P03_sensor_cap.stl, P04_magnet_holder.stl, P05_antenna_platform.stl, P06_transom_bracket.stl, P07_mast_bearing_housing.stl, P08_spar_clamp_boom_socket.stl]
2026-11-08 Rev B: move wing counterweight to a pod on a 300 mm forward arm
    - New printed pod P18; spar clamp P08 gains a forward arm socket
    - Drawings D00, D01, D06, D12, D17 updated (Rev B), build-files README
    - Simulator counts the arm tube and pod shell when sizing the lead (0.80 kg)
    - Rerun on synthetic weather: Rev B vs Rev A nose pocket (docs/Simulation_RevB.md, results/)
    - Build Plan and Executive Summary snapshots updated; viewer demo data refreshed
    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
    [P08_spar_clamp_boom_socket.stl, P08_spar_clamp_two_sockets.stl, P18_counterweight_pod.stl]
2026-11-08 Borrow ideas from jcolter11374/boat-sim: field tests, solar losses, odds by launch month
    - docs/Field_Tests.md: tow drag, inclining (GM), self-righting, wing balance, solar day
    - drone_sim/calibrate.py: predicted tow pulls and heel; fits hull form factor and GM from measurements
    - Solar: salt/soiling, MPPT, wiring and NOCT cell-temperature losses (marked GUESS)
    - Monte Carlo summary and charts: odds by launch month with 95% ranges
    - results: Apr-Sep launch window run (synthetic weather)
    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
2026-11-08 Move launch to the US Mid-Atlantic; target Europe (SW Ireland); apply boat-sim #50 fixes
    - Default route: off Ocean City, MD -> SW Ireland via 42N 48W, May launch, 240-day limit
    - Presets for Ocean City, Virginia Beach, Cape May; Brittany/Cornwall and Portugal targets
    - Europe landfall judged by Natural Earth countries (CONTINENT == Europe), overseas
    territories excluded; Azores/Madeira/Canaries optional (atlantic_islands_count)
    - No double-counted Stokes drift with Open-Meteo (SMOC total current includes it)
    - gridcheck command: same voyage on 1.0 and 0.25 degree weather grids
    - docs: Route_MidAtlantic.md; Build Plan, Executive Summary and README updated
    - results: route comparison and 10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
2026-11-09 Failure rates and crossing history from the Microtransat record; refit simulator hazards
    - docs/Failure_Rates.md: shared hazard table with sources, ranges and quality grades
    - docs/Crossing_History.md: all 37 Microtransat attempts 2010-2023 plus other autonomous crossings
    - docs/data/: attempts CSV, exposure-based hazard analysis, Monte Carlo scripts and output
    - Simulator: rate sets (planning default, historical, original), comms_silent failure,
    early-life multiplier with shakedown, capture out to ~150 km, last-report day per run,
    rate-set selector in the web UI
    - Mid-Atlantic Monte Carlo: 37% planning, 22% historical, 48% original
    - Field Test F: pass criteria for the 3-week coastal tr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
    [crossing_attempts.csv]
2026-11-09 Drift tests: drop 100 km off Ocean City; Open-Meteo-safe real-weather Monte Carlo
    - Real-weather dead-boat drift (4 May dates): 25 km drop went ashore 3 of 4 times, 100 km drop 0 of 4.
    Default launch moved to 38.02N 74.01W; route doc, summary and README updated
    - Downloader: per-location call ledger, paces under the hourly limit, stops cleanly at the daily limit;
    --wait-for-limits sleeps to the next UTC day (keeps Windows awake); Monte Carlo prints download size
    - New run_real_mc.bat: 60 voyages, May-mid-June 2023-2024, ~23k calls (2-3 days unattended)
    - Run log saved without local paths
    Claude-Session: https://claude.ai/code/sessi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
2026-11-09 Hurricane storm-frequency model (HURDAT2 analog seasons), Rev B GZ curve for boat-sim, timed MC tracks
    - storms.py + cli stormcheck: TS+ encounters within 200 km by launch month, season-bootstrap CIs
    - docs/Hurricane_Risk.md; HURDAT2 1981-2025 subset CSV (NOAA, public domain)
    - docs/data/revB_gz_curve.csv with inertia (for boat-sim's 3D view)
    - Monte Carlo tracks carry days since launch; default design label now Rev B
    - 200-run synthetic MC from the 100 km drop: 40% (33.5-46.9)
    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
    [hurdat2_atlantic_1981-2025_box.csv, revB_gz_curve.csv]
2026-11-09 Leeway drift model for a dead boat; wear-out option; launch plan, backup tracker, storm loads
    - Dead boat drifts at 3.3% of U10 within ~14 deg of downwind (was: reaching at 4-6%, 70 deg off)
    - failures.py wear_out (boat-sim #118), off by default
    - drift_tests.py: 50 km point, --bulk mode with a drop every 3 days; run_drift_bulk.bat
    - docs: Launch_Plan, Backup_Tracker, Storm_Loads; Field_Tests additions; README links
    - 200-run synthetic MC with the leeway model: 40.5% (33.9-47.4)
    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
    [design.py]
2026-11-10 Backup tracker (YB3) in the simulator, fitted by default
    A dead main box with a working tracker now drifts on at leeway, still
    tracked, instead of ending the voyage. Tracker dies at 0.0007/day
    (boat-sim #153). New outcomes arrived_tracked (success) and
    arrived_adrift. 200 runs from the 100 km drop: verified arrivals
    40.5% -> 54.5%, position known at the end 40.5% -> 65.5%.
    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
    [design.py]
2026-11-10 Drift tests on real 2023 data: 100 km drop grounds 8/16, shelf edge 5/16
    Re-run with the leeway model on ERA5 + Copernicus bulk data. Route doc
    updated with the results and a proposed move to a 150 km drop, pending
    the 2024 drift run. Add run_drift_bulk_2024.bat; drift_tests.py checks
    that the bulk months exist.
    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
2026-11-10 Rev C: foam-filled hull, twin rudders, 30 mm spar; drawings, parts, sim and docs
    Approved Nov 10 after the first real-weather Monte Carlo. Bulkheads at
    x 300/1260 with foam fill and a sealed battery box cap flooding at ~3 kg;
    twin rudders with separate servos; 30x26 spar on 6806 bearings; bulb D72;
    YB3 platform P19 and nav light P20; thruster and backup D-cell removed.
    Regenerated drawings (20 sheets, new D09), templates (T17/T18), 23 STLs.
    Simulator: Rev C default with Rev B preset, twin-rudder failures, bounded
    flooding. Design files for our sim and boat-sim in designs/.
    Claude-Session: https://claude.ai/code/session_0114ZepeqeW8kwMk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
    [P07_mast_bearing_housing.stl, P08_spar_clamp_two_sockets.stl, P14a_bulb_pattern_fwd.stl, P14b_bulb_pattern_aft.stl, P19_yb3_platform.stl, P20_nav_light_clamp.stl, T01_frame_station_1.dxf, T02_frame_station_2.dxf]
2026-11-10 Drawings: cover index names the twin-rudder sheet
    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
2026-11-11 Rev C vs Rev B and near-coast vs 100 km on 2023 real weather
    Rev C near-coast 38.8%, Rev B near-coast 41.2%, Rev C 100 km 44.8%
    verified arrivals. Rev C ends swamping and most steering losses but
    arrivals are level; near-coast launch costs more than estimated.
    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
2026-11-11 Rev C1: electronics box above the flood level
    Box raised onto a shelf (bottom z 118), open space kept as one 3 L sump
    at the low point, glands on top. Simulator: hull.wet_electronics_factor
    (2 for C1, a guess pending Field Test J; 6 for Rev B and C). Drawings
    regenerated as C1. Adds run_revC1_compare_2023.bat.
    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
    [revC_gz_curve.csv]
2026-11-11 Rev C2: hardwood-cored keel fin with carbon strips, tenon and keel-box floors
    Fin and hull joint redrawn after the strength estimate (D04, T12, T13, new
    T19/T20), proof test K added, simulator masses updated (26.4 kg, GM 0.190).
    Also remove simulator/CON, a reserved file name on Windows.
    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
    [T01_frame_station_1.dxf, T02_frame_station_2.dxf, T03_frame_station_3.dxf, T04_frame_station_4.dxf, T05_frame_station_5.dxf, T06_frame_station_6.dxf, T07_frame_station_7.dxf, T08_frame_station_8.dxf]
2026-11-11 Rev C3: structural review changes, and a structural-failure model in the simulator
    YB3 to a foredeck well, fibreglass stern post and counterweight arm, rudder
    servo-savers, 30 x 22 spar on wider bearings, second ply over the sump.
    Drawings, P07 and P19 STL, design files and documents updated. The voyage
    simulator now rolls for structural breaks at each knockdown.
    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
    [P07_mast_bearing_housing.stl, P19_yb3_platform.stl, T01_frame_station_1.dxf, T02_frame_station_2.dxf, T03_frame_station_3.dxf, T04_frame_station_4.dxf, T05_frame_station_5.dxf, T06_frame_station_6.dxf]
2026-11-11 Research review; strike model matched to measured buoy data
    Buoy accelerations in real breakers show the slam model overstated shock
    loads. Stern post and counterweight arm are not fail points; wing spar and
    rudder servos stand. Simulator default breaker set is now 'measured'.
    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
    [design.py]
2026-11-11 Rev C4: acetal mast bearings with catcher lands, build notes, rudder health spec
    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
    [P07_mast_bearing_housing.stl]
2026-11-11 Wing shape study: shorter, wider wing at the same area
    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
2026-11-11 Rev C5: wing 0.80 x 0.375 m at the same area
    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
    [T15_wing.dxf, revC_gz_curve.csv]
2026-11-11 Log: question relayed to John; his wing check
    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
2026-11-12 Fix wind-angle units in the voyage simulator; wing stall rule; electronics review
    The simulator passed wind angles in degrees to a polar indexed in radians,
    so every heading sailed at the dead-downwind speed. Fixed, with a guard.
    Wing stall angle now follows its lift (shorter wings stall later).
    Corrected wing study, electronics/potting review, PC run files.
    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
2026-11-12 Rev C6: limp-home controller, potting, RockBLOCK Plus in the hatch lid, main GPS to the stern post
    New printed parts P21 (limp-home case), P22 (switchover pod), P23 (RockBLOCK Plus bowl).
    Sheets D00, D01, D03, D07, D08, D20, D21; T16 lid cut. 27.8 kg, GM 0.182, DWL z 104.
    docs: Limp_Home_Spec.md, Potting_Spec.md, Field Test N, Design_RevC C6 section, parts and budget.
    Simulator: C6 default (limp_home fitted, electronics_protection, wet factor 1.3); pre-C6 design
    files keep their behaviour. run_revC6_2023.bat queued on the PC.
    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
    [P21_limp_home_case.stl, P22_switchover_pod.stl, P23_rockblock_plus_bowl.stl, T16_hatch.dxf]
2026-11-12 Rename Rev C6 to Rev D; add revision convention (docs/Revisions.md)
    C6 adds a system (backup controller, servo switch, new power feed, new modem), so it takes a new letter.
    Simulator revision key D (Rev C files still load as before); designs/revD_design.json, run_revD_2023.bat,
    boat-sim randolph_rev_d.yaml; revC_design.json and randolph_rev_c.yaml restored to C5. Drawings at Rev D;
    cover note C3 line fixed to its own mass (26.9 kg, DWL z 102).
    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
    [T16_hatch.dxf]
2026-11-12 Launch-point study: plan, research, 12 launch scenarios, stage A batch
    docs/Launch_Point_Study.md (research, candidates, stages, caveats); collab/launch_points/ (scenario and
    batch generators); docs/data/launch_analysis.py (paired comparison, near-coast losses, fishing-ground
    sensitivity). Autopilot: scenario option waypoint_rule "abeam" (default "radius" unchanged).
    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
2026-11-13 Reliability review: servos, weed, leaks; bilge pump and study options in the simulator
    docs/Reliability_Review.md. Simulator design keys: autopilot.leak_policy/leak_safe_kg, bilge_pump,
    rudder.servo_rate_factor, wing.tail_servo_rate_factor, wing.tail_fail_free_share, keel.weed_catch_factor,
    keel.weed_clear_per_day (defaults reproduce Rev D exactly). Three study designs and run_reliability_2023.bat.
    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
    [design.py]
2026-11-13 Log: stage A restarted in the visible queue window
    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
2026-11-13 Run queue survives unplugging: task battery settings, keep-awake on every run
    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
2026-11-13 Launch study stage A results (12 launch points); stage B queued; Canaveral route fix
    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
2026-11-13 Log: daily check-in (thread not readable this morning)
    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
2026-11-13 Launch study stage B and reliability results; speed check passed; stage C queued
    Stage B: 4 launches x 3 destinations. The three alternative launches are each
    about +4 over Ocean City 10 km pooled (ranges cross zero) and tied; SW Ireland
    = Cornwall, Brittany -2. Canaveral rerun 34.0%. Stage C: Hatteras Inlet to SW
    Ireland and Cornwall, plus the current plan, Rev D, 500 voyages, 2023+2024.
    Reliability: bilge pump + pump-and-sail +8.0 (+4.8 to +11.6); full package
    +18.8 (servo and weed factors are guesses); weed pessimistic -0.8. Rev D1
    recommendation awaiting Randolph.
    Speed check on the PC: identical results, 4.4x faster; installed.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
2026-11-13 Rev E: bilge pump, sealed servos, tail detent, weed fairing
    Randolph approved the reliability recommendations. A new letter rather than
    D1 because the pump is a new system. Pump on spacer P24 with keep-sailing
    leak response, vents, test valve and humidity sensor; SER-2000 sealed rudder
    servos in cradles P12 with arms P26 and spring links; potted tail servo with
    detent P25; fin-to-bulb fairing (T21). Raked rudders and the flush bulb nose
    deferred. 28.5 kg, DWL 106. Rev E simulator file and run queued on the PC.
    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
    [P12_rudder_servo_cradle.stl, P12_rudder_servo_mount.stl, P24_bilge_pump_spacer.stl, P25_tail_detent.stl, P26_rudder_servo_arm.stl, T21_weed_fairing.dxf]
2026-11-13 Launch study stage C and first Rev E run
    Stage C (Rev D, 500 voyages per pair, 2023 and 2024): Hatteras Inlet to
    Cornwall 68.4%, +9.2 (+3.8 to +14.8) over Ocean City to SW Ireland, the same
    in both years. Recommendation written for Randolph to decide.
    Rev E as drawn: 76.4%, +14.4 (+7.6 to +21.2) over Rev D.
    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
2026-11-14 Naval review follow-ups: drop point, drift, flooded stability, fatigue, steering
    Rev E on the new route 83.4% (+15.0 over Rev D); the 45 km drop clears
    Diamond Shoals and gives 87.6%. Speed x0.8 costs 5 points. Dead-boat drift
    from the inlet grounds half the drops. Flooded stability fine but the sump
    holds only 1.2 L. Fatigue negligible except the tail boom in big beam seas.
    The Rev E steering rule lost the course in the 6-DOF model and is replaced
    by a wave filter; Test P raised to 3 million movements.
    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
    [drawings.py]
2026-11-14 Rev E1, wave reanalysis for 2021-22, new runs queued
    Randolph's decisions: 45 km drop off Hatteras, leak SAFE limit 1.0 kg, 16 x 14
    tail boom (P08 and P09 sockets to suit). The wave forecast archive starts in
    November 2022, so the downloader now takes earlier months from WAVERYS. Queued:
    sea states, E1 baseline, wave download, launch windows on 2021-24 weather.
    Watch lines at the Cornwall end.
    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
    [P08_spar_clamp_two_sockets.stl, P09_tail_servo_housing.stl]
